peterriv/WaterSupplyController/README.md

# WaterSupplyController
Water pumping and watering management controller for country house
