peterriv/WaterSupplyController/DS/KLS5-CR2032-03.pdf

## ДЕРЖАТЕЛИ БАТАРЕЕК KLS5-CR2032-03

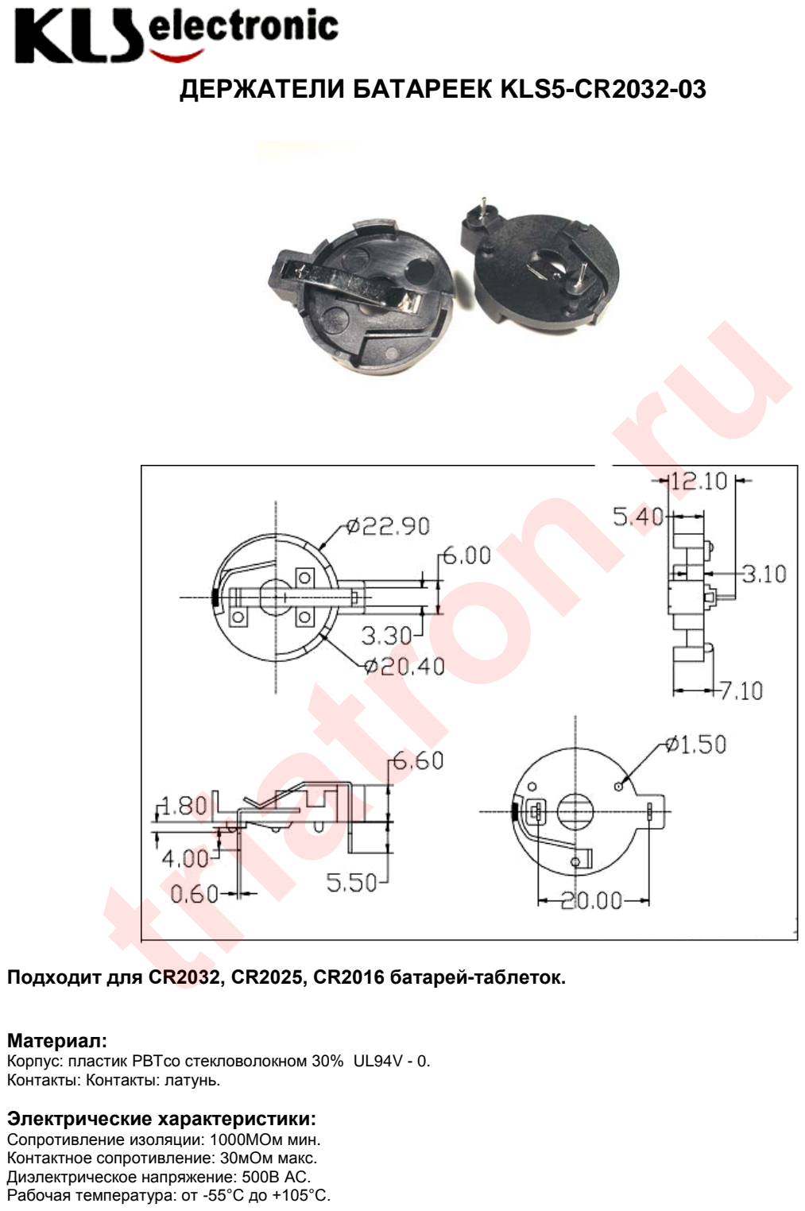
[picture p1: page 1]

Подходит для CR2032, CR2025, CR2016 батарей-таблеток.

### Материал:

Корпус: пластик PBTсо стекловолокном 30% UL94V - 0.
Контакты: Контакты: латунь.

### Электрические характеристики:

Сопротивление изоляции: 1000МОм мин.
Контактное сопротивление: 30мОм макс. Диэлектрическое напряжение: 500В АС. Рабочая температура: от -55°С до +105°С.

# triatron.ru
