peterriv/WaterSupplyController/DS/KLS5-CR2032-03.jpg

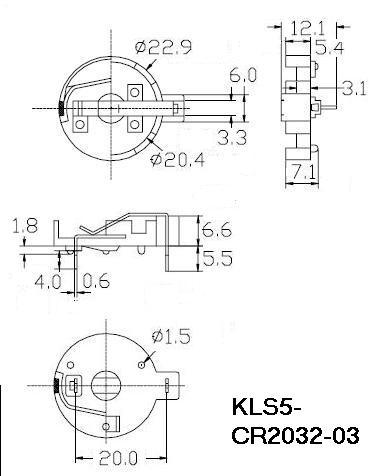
DS/KLS5-CR2032-03.jpg
