peterriv/WaterSupplyController/WaterSupplyController, BOM.xlsx

Line # | Designator | Value | Footprint | Manufacturer 1 | Manufacturer Part Number 1 | Quantity | Price
 | C1 | 22.0x35V | TC7343-D | KEMET | T494X226K035AT | 1 | 0.787
 | C2...C4, C7 | µ10x50V X7R | 0603_CAP | KEMET | C0603C104K5RAC7411 | 4 | 0.06
 | C5, C11, C19...C22 | 10nFx50V X7R | 0603_CAP | Yageo | CC0603KRX7R9BB103 | 6 | 0.042
 | C6 | 1n8x50V X7R | 0603_CAP | TDK | CGA3E2C0G1H182J080AA | 1 | 0.0225
 | C8 | 100.0x16V | TC7343-D | KEMET | T495C107K016ATE200 | 1 | 0.192
 | C9, C14 | 2µ2x10V X7R | 0603_CAP | TDK | C1608X7R1A225K080AC | 2 | 0.102
 | C10, C13, C15...C18, C27, C29_C1, C29_C2, C29_C3 | µ10x10V X7R | 0402_CAP | Yageo | CC0402KRX7R6BB104 | 10 | 0.06
 | C12 | 220.0x6.3V | TC6032-C | Kyocera AVX | TAJC227K006RNJ | 1 | 0.487
 | C23, C24 | 6.8pFx50V NP0 | 0603_CAP | Kyocera AVX | 06035A6R8CAT2A | 2 | 0.02
 | C25, C26 | 22pFx50V NP0 | 0603_CAP | KEMET | C0603C220J1GACTU | 2 | 0.01
 | C28 | 10.0x16V | TC3216-A | Samsung | CL31A106KOHNNNE | 1 | 0.0331
 | DA1 | MP1591DN | HSOP8 | Monolithic Power Systems | MP1591DN-LF-Z | 1
 | DA2 | L78L12ABUTR | SOT-89 | STMicroelectronics | L78L12ABUTR | 1 | 0.4317
 | DA3 | TPS79333DBVR | SOT23-5 | Texas Instruments | TPS79333DBVR | 1 | 5.12
 | DD1 | AT24C32AN-10SU | SO8 | Microchip / Atmel | AT24C32AN-10SU-1.8 | 1
 | DD2 | STM32F103RET6 | LQFP64 | STMicroelectronics | STM32F103RET6 | 1
 | DD3_C1, DD3_C2, DD3_C3 | SN65HVD485EDR | SO8 | Texas Instruments | SN65HVD485EDR | 3 | 23.87
 | GB1 | KLS5-CR2032-03 | CR2032P | KLS | KLS5-CR2032-03 | 1
 | HL1, HL3, HL4, HL6_C1, HL6_C2, HL6_C3 | KP-2012SYC | KP-2012_YEL | Kingbright | KP-2012SYCK | 6 | 0.684
 | HL2, HL5_C1, HL5_C2, HL5_C3 | KP-2012MGC | KP-2012_GRN | Kingbright | KP-2012SGC | 4 | 0.7
 | K1 | TRV-5VDC-SC-CD | TRV-5VDC-SC-CD | Tai-Shing Electronic Components | TRV-5VDC-SC-CD | 1
 | L1 | 22µH CDRH124NP-220MC | CDRH124 | Sumida | CDRH124NP-220MC | 1 | 1.53
 | L2, L3 | 470R BLM18PG471SN1D | 0603_BLM18 | Murata | BLM18PG600SN1D | 2 | 0.2
 | L4 | 100µH LQH43CN101K | LQH43 | Murata | LQH43CN101K03L | 1 | 0.49
 | R1, R27...R31, R37...R40 | 15k00 | 0603_RES | Yageo | RC0603FR-0715KL | 10 | 0.04
 | R2 | 100k00 | 0603_RES | Yageo | AC0603FR-07100KL | 1 | 0.069
 | R3 | 30k10 | 0603_RES | Panasonic | ERJ-3EKF3012V | 1 | 0.00313
 | R4 | 10k00 | 0603_RES | Panasonic | ERJ-3EKF1002V | 1 | 0.008
 | R5 | 8k20 | 0603_RES | Panasonic | ERJ-3EKF8201V | 1 | 0.006
 | R6 | 1k50 | 0603_RES | Panasonic | ERJ-3EKF1501V | 1 | 0.006
 | R7, R8, R25, R26 | 4k7 CAT16-472J4 | CAT16 | Bourns | CAT16-472J4LF | 4 | 0.192
 | R9, R13...R16, R24, R32...R36, R41...R45 | 5k11 | 0603_RES | Vishay | CRCW06035K11FKEA | 16 | 0.096
 | R10, R19 | k10 | 0603_RES | Yageo | RC0603FR-07100RL | 2 | 0.008
 | R11, R12 | 3k3 | 0603_RES | Yageo | RC0603FR-073K3L | 2 | 0.008
 | R17, R18, R46_C1, R46_C2, R46_C3, R47_C1, R47_C2, R47_C3 | 1k | 0603_RES | Yageo | RC0603FR-071KL | 8 | 0.064
 | R20...R23 | 6k19 | 0603_RES | Panasonic | ERJ-3EKF6191V | 4 | 0.064
 | R48_C1, R48_C2, R48_C3, R49_C1, R49_C2, R49_C3 | 240R00 | 0805_RES |  |  | 6
 | R50_C1, R50_C2, R50_C3, R51_C1, R51_C2, R51_C3 | 0R | 0402_RES | Yageo | RC0402JR-070RL | 6 | 0.006
 | VD1 | P1.5KE24A | DO-201AD | Littelfuse | TP1.5KE24A | 1 | 0.1319
 | VD2 | STPS3L60U | SMB-STPS3L60U | STMicroelectronics | STPS3L60U | 1 | 0.4583
 | VD12_C1, VD12_C2, VD12_C3, VD13_C1, VD13_C2, VD13_C3 | GSOT12C | SOT-23-(2) | Vishay Semiconductors | GSOT12-E3-08 | 6 | 0.99
 | VD3...VD11 | ES1D | SMA | ON Semiconductor / Fairchild | ES1B | 9 | 3.39
 | VT1...VT6, VT12...VT15 | MMBF170 | SOT-23 MOSFET | Diodes | MMBF170Q-7-F | 10 | 2.87
 | VT7...VT11, VT16...VT19 | IRLML0060TRPBF | SOT-23 MOSFET | Alpha & Omega Semiconductor | AO3400A | 9 | 3.62
 | X1_C1, X1_C2, X1_C3 | DS1025-01-1*3 P8BV1 | PLS2-3 | Connfly | DS1025-01-1*3 P8BV1 | 3
 | XP1 | DS1022-1*4RDF11-B | PLS-4RR | Connfly | DS1022-1*4RDF11-B | 1
 | XP2 | DS1025-05-2*3P8BV1-B | PLD2-6 | Connfly | DS1025-05-2*3P8BV1-B | 1
 | XP3 | B5B-PH-K-S(LF)(SN) | PH-5 | KLS | L-KLS1-XL1-2.00-05-S | 1
 | XP4 | B3B-PH-K-S(LF)(SN) | PH-3 | Connfly | DS1066-3MVW6X | 1
 | XP5_C1, XP5_C2, XP5_C3 | B4B-PH-K-S(LF)(SN) | PH-4 | JST | B4BPHKSLFSN | 3 | 3.02
 | XT1, XT4...XT8 | XY301VA-5.0-2P-12 | 301-021-12 | Ningbo Xinya M&E | XY301VA-5.0-2P-12 | 6
 | XT2, XT3 | XY301VA-5.0-3P-12 | 301-031-12 | Ningbo Xinya M&E | XY301VA-5.0-3P-12 | 2
 | ZQ1 | NX3215SA-32.768K-STD-MUA-8 | 1206_NX3215SA | NDK | NX3215SA-32.768K-STD-MUA-8 | 1
 | ZQ2 | 12MHz HC49SM | HC49SM | Abracon | ABLS-12.000MHZ-B4-T | 1 | 0.196
