peterriv/WaterSupplyController/Project Outputs for WaterSupplyController/Schematic Print/Schematic Prints.PDF

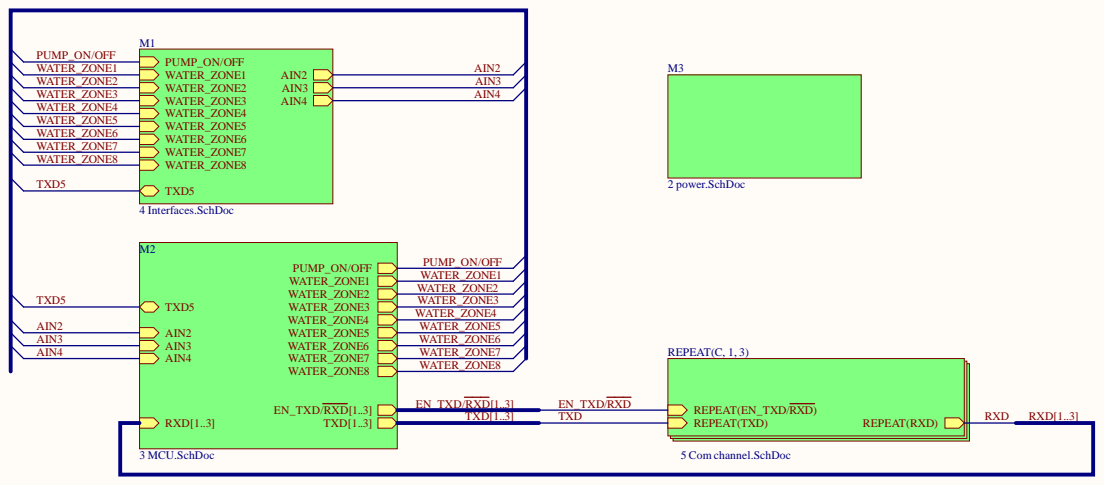
[picture p3: page 1]

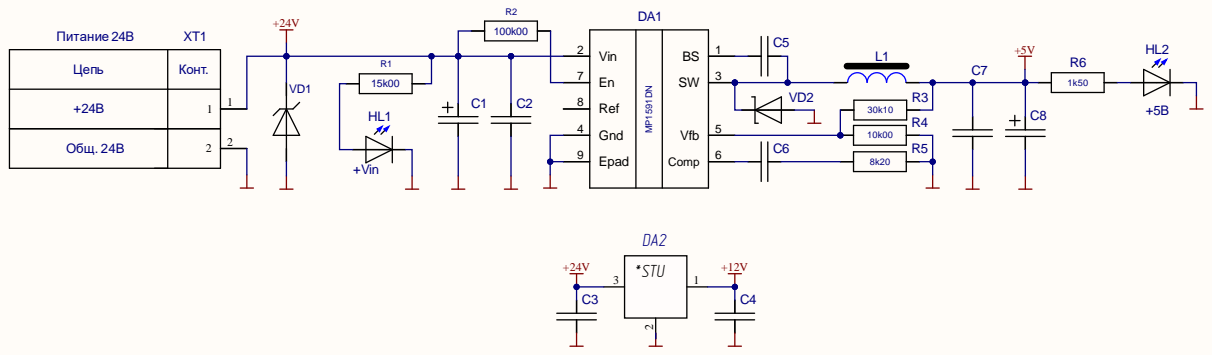
[picture p4: page 2]

Vin 2 | Comp | 6 Epad 9

Цепь | Конт.

C:\Work\WaterSupplyController\SchDocs\2 power.SchDoc

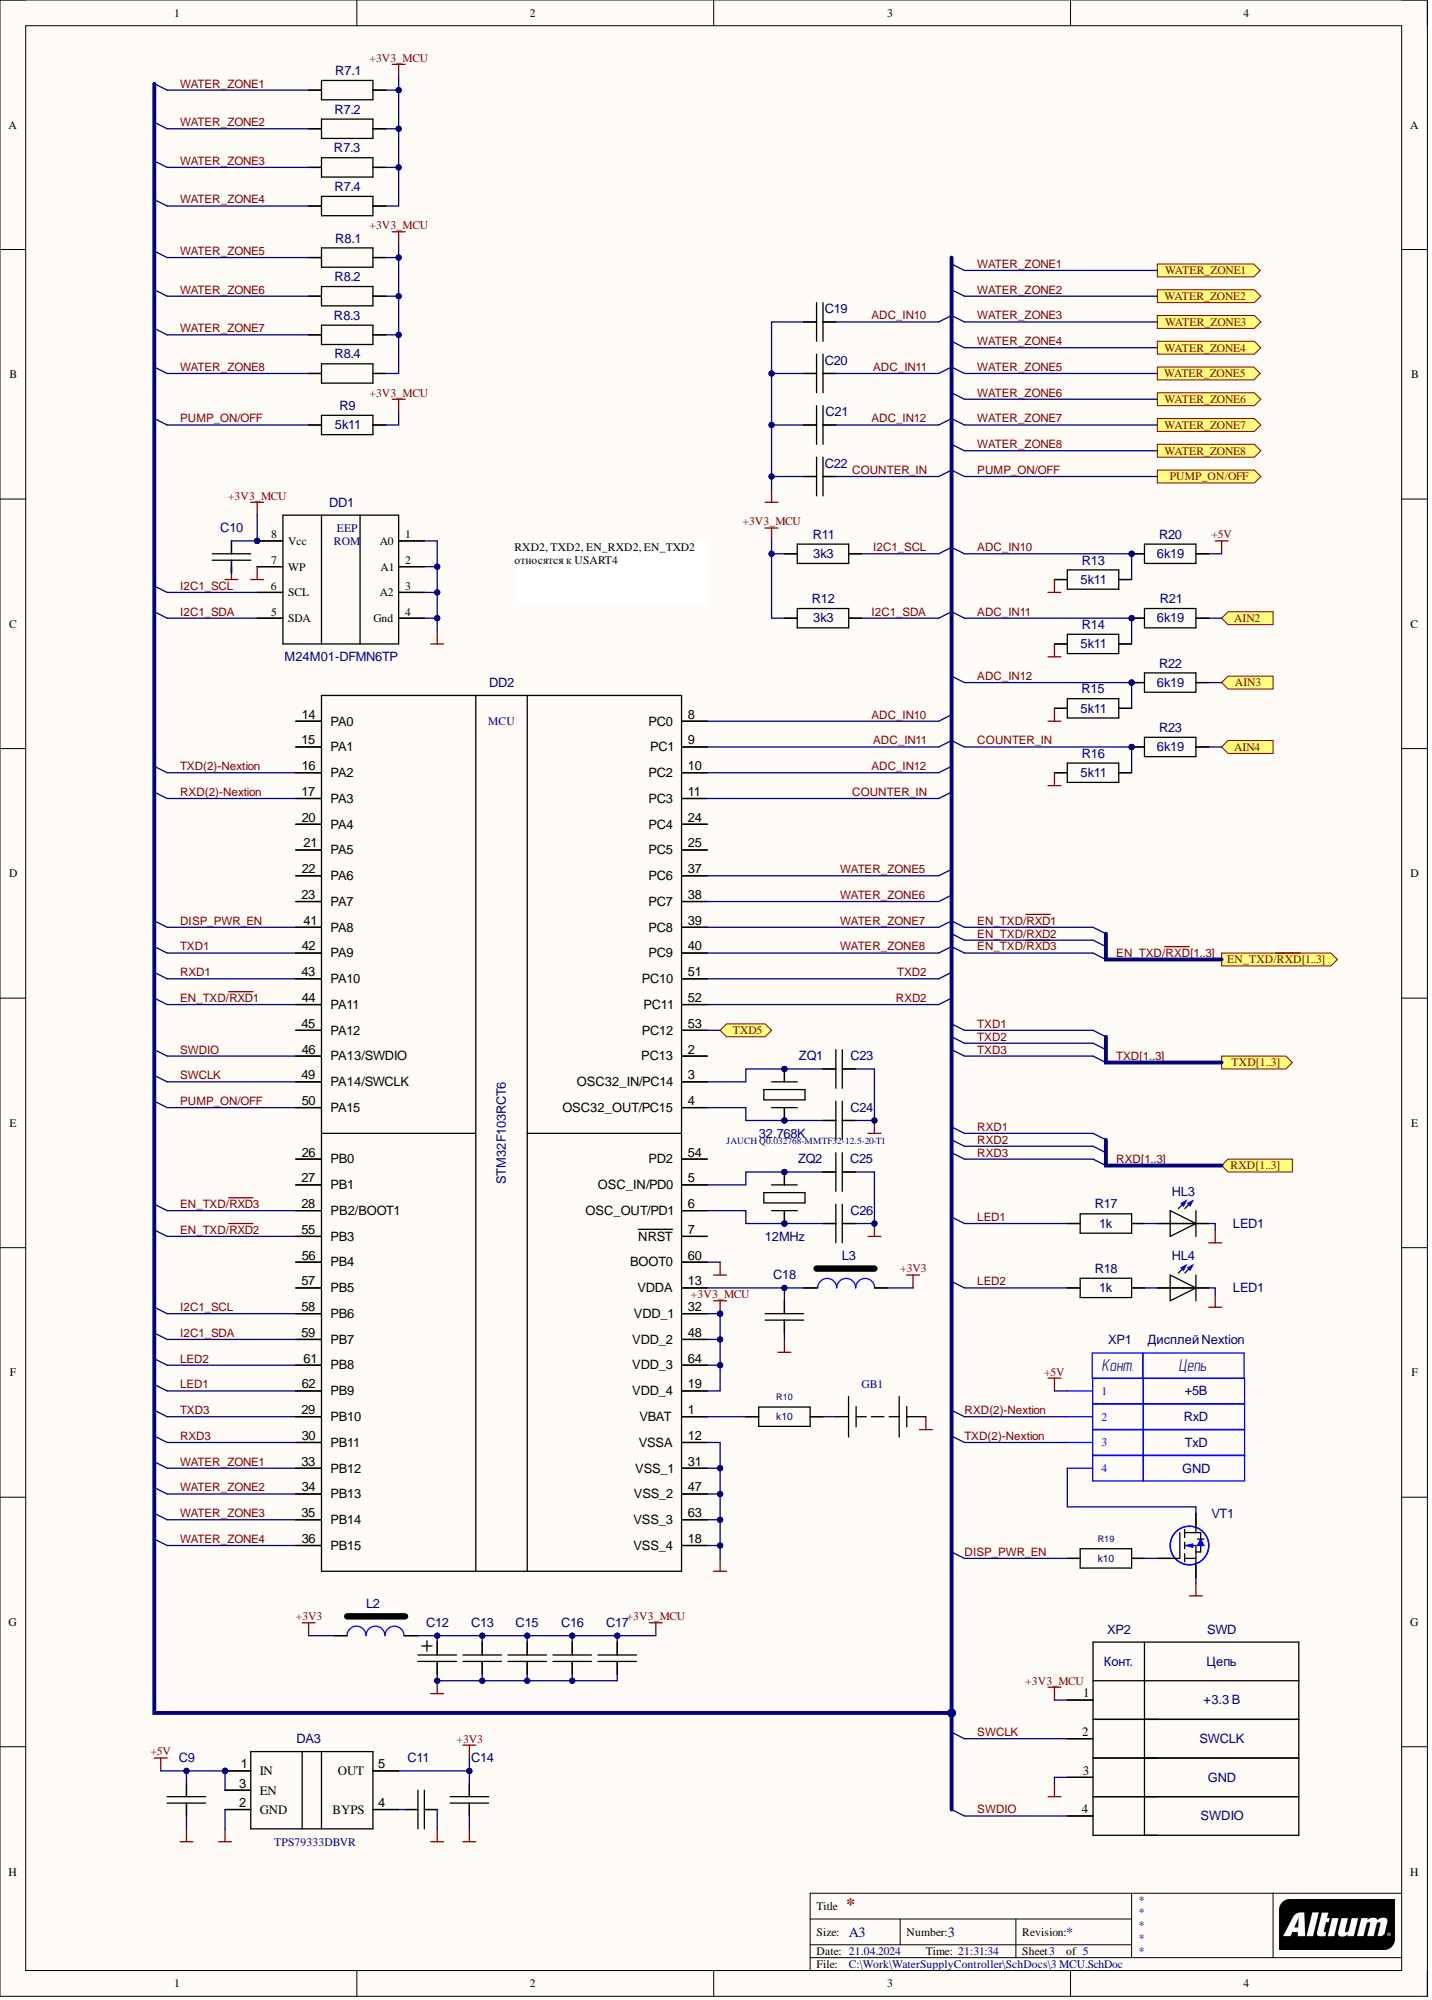
[picture p5: page 3]

Конт. | Цепь

3 | TxD

4 | GND

SWCLK

IN 1 EN 3 GND 2

GND

SWDIO

C:\Work\WaterSupplyController\SchDocs\3 MCU.SchDoc

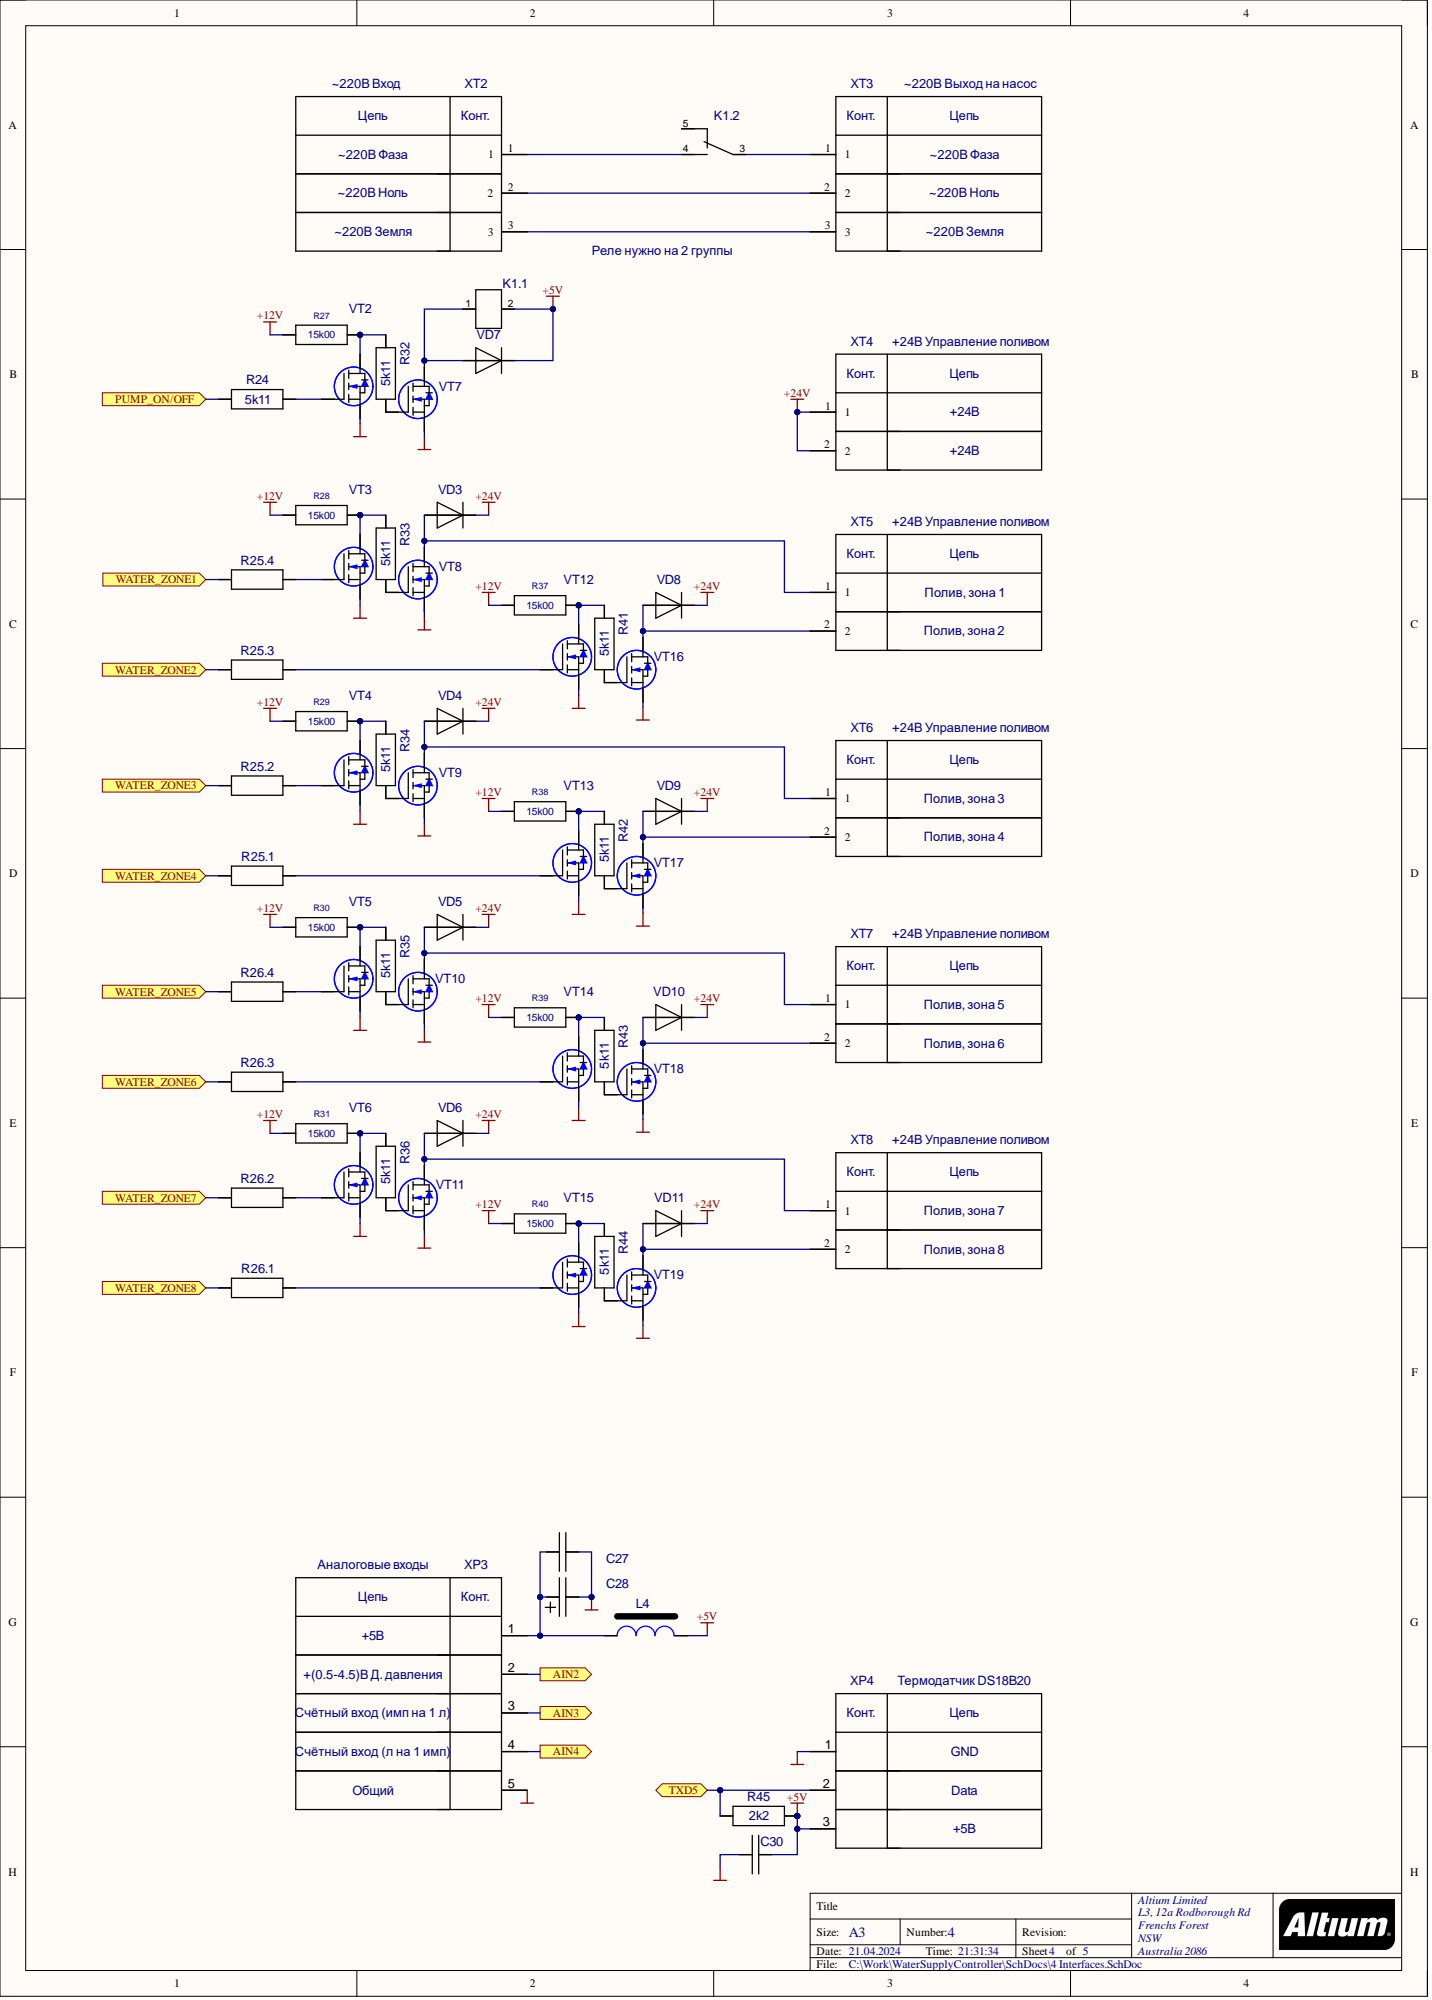
[picture p6: page 4]

Реле нужно на 2 группы

Конт. | Цепь

1 1 | Полив, зона 1

2 2 | Полив, зона 2

1 1 | Полив, зона 3

2 2 | Полив, зона 4

1 1 | Полив, зона 5

2 2 | Полив, зона 6

1 1 | Полив, зона 7

2 2 | Полив, зона 8

Цепь | Конт.

+(0.5-4.5)ВД. давления

Счётный вход (имп на 1 л)

Счётный вход (л на 1 имп)

C:\Work\WaterSupplyController\SchDocs\4 Interfaces.SchDoc

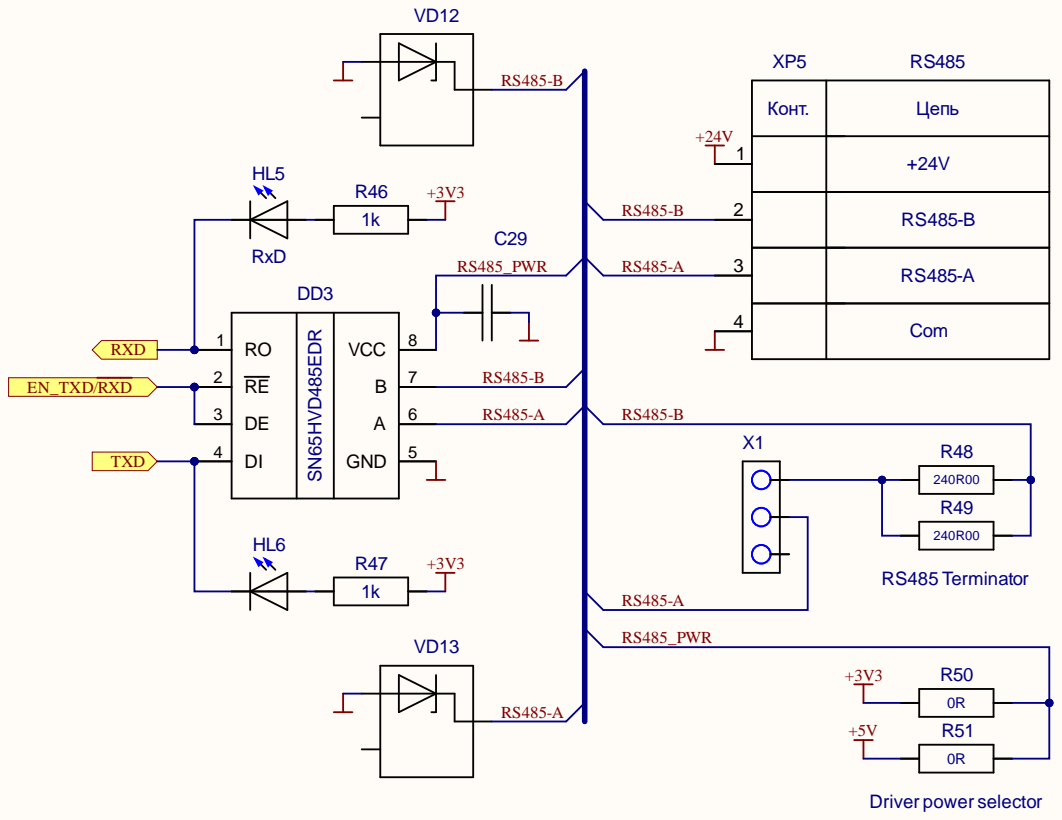
[picture p7: page 5]

Конт. | Цепь

Com

C:\Work\WaterSupplyController\SchDocs\5 Com channel.SchDoc
