peterriv/WaterSupplyController/DS/3.2_Nextion_Dimension.pdf

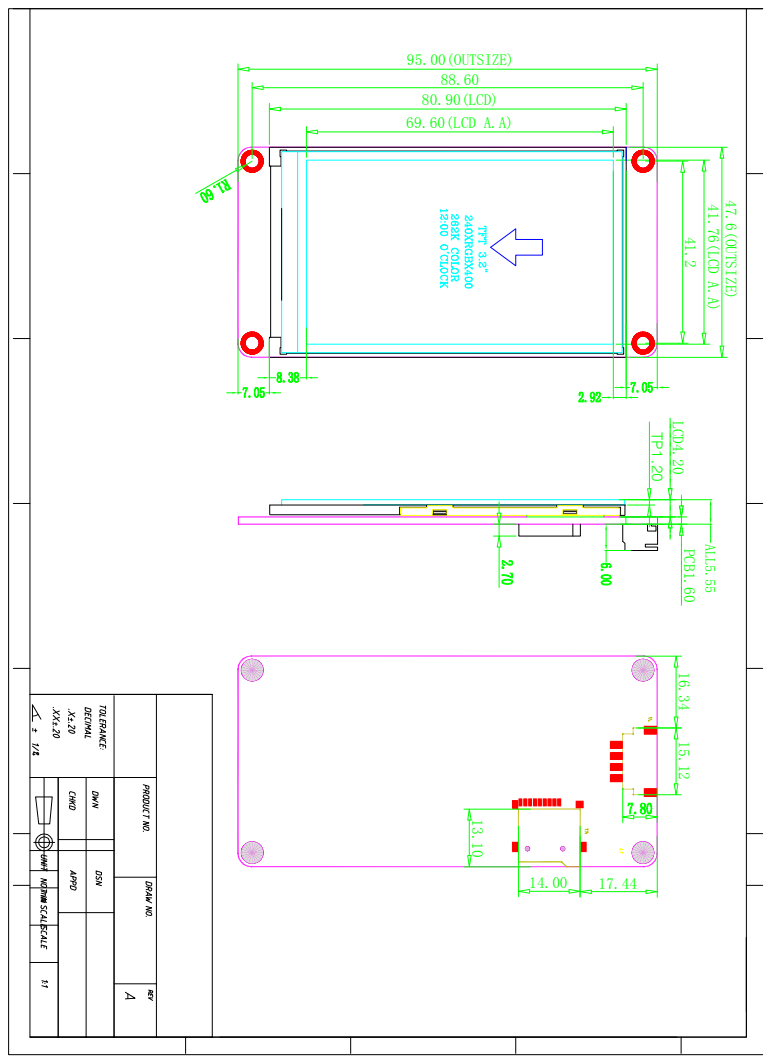
[picture p8: page 1]
41.76(LCD A.A); 47.6(OUTSIZE); 69.60(LCD A.A); 80.90(LCD); 95.00(OUTSIZE); LCD4.20; PCB1.60 16.34 15.12; ALL5.55
