peterriv/WaterSupplyController/DS/NX4832F035_dimension.pdf

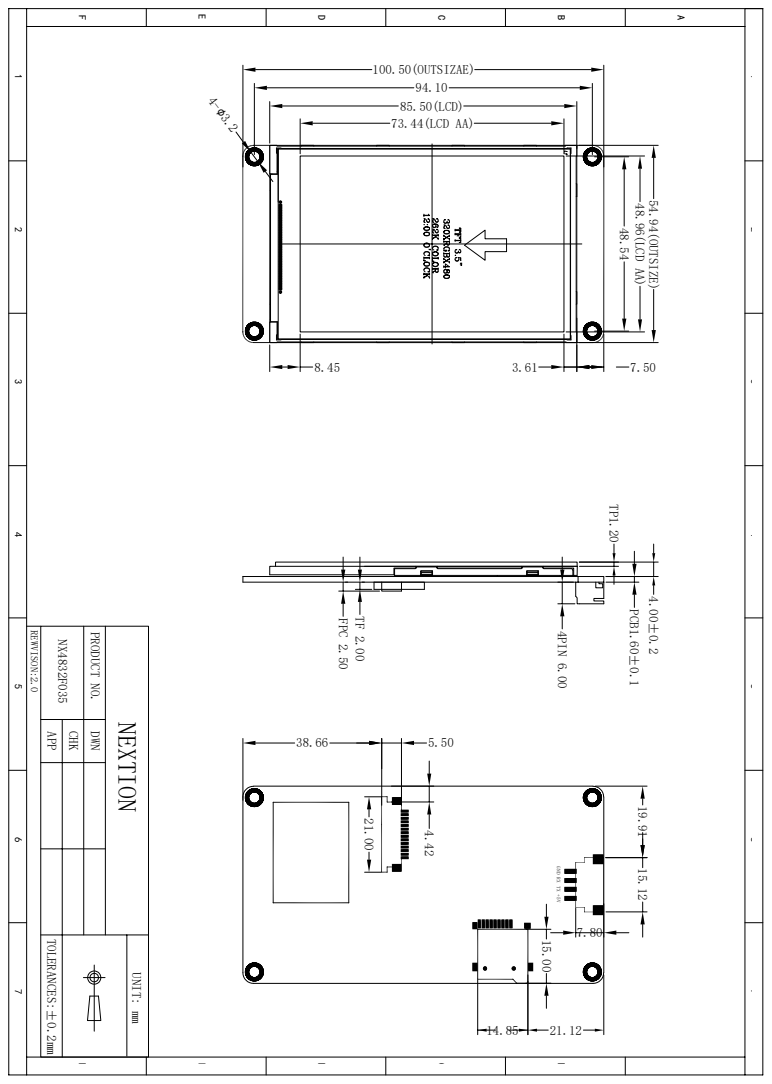
[picture p9: page 1]
PCB1.60±0.1; 4PIN 6.00; 48.96(LCD A; 54.94(OUTSIZE); 73.44(LCD AA); 94.10 85.50(LCD); 100.50(OUTSIZAE); FPC 2.50; PRODUCT NO.; U NIT: m; TOLERA; NCES:±0.2m; CHK; APP; REWVISON:2.0

+5V TX RX GND
