peterriv/WaterSupplyController/Project Outputs for WaterSupplyController/PCBDrawing/Draftsman.PDF

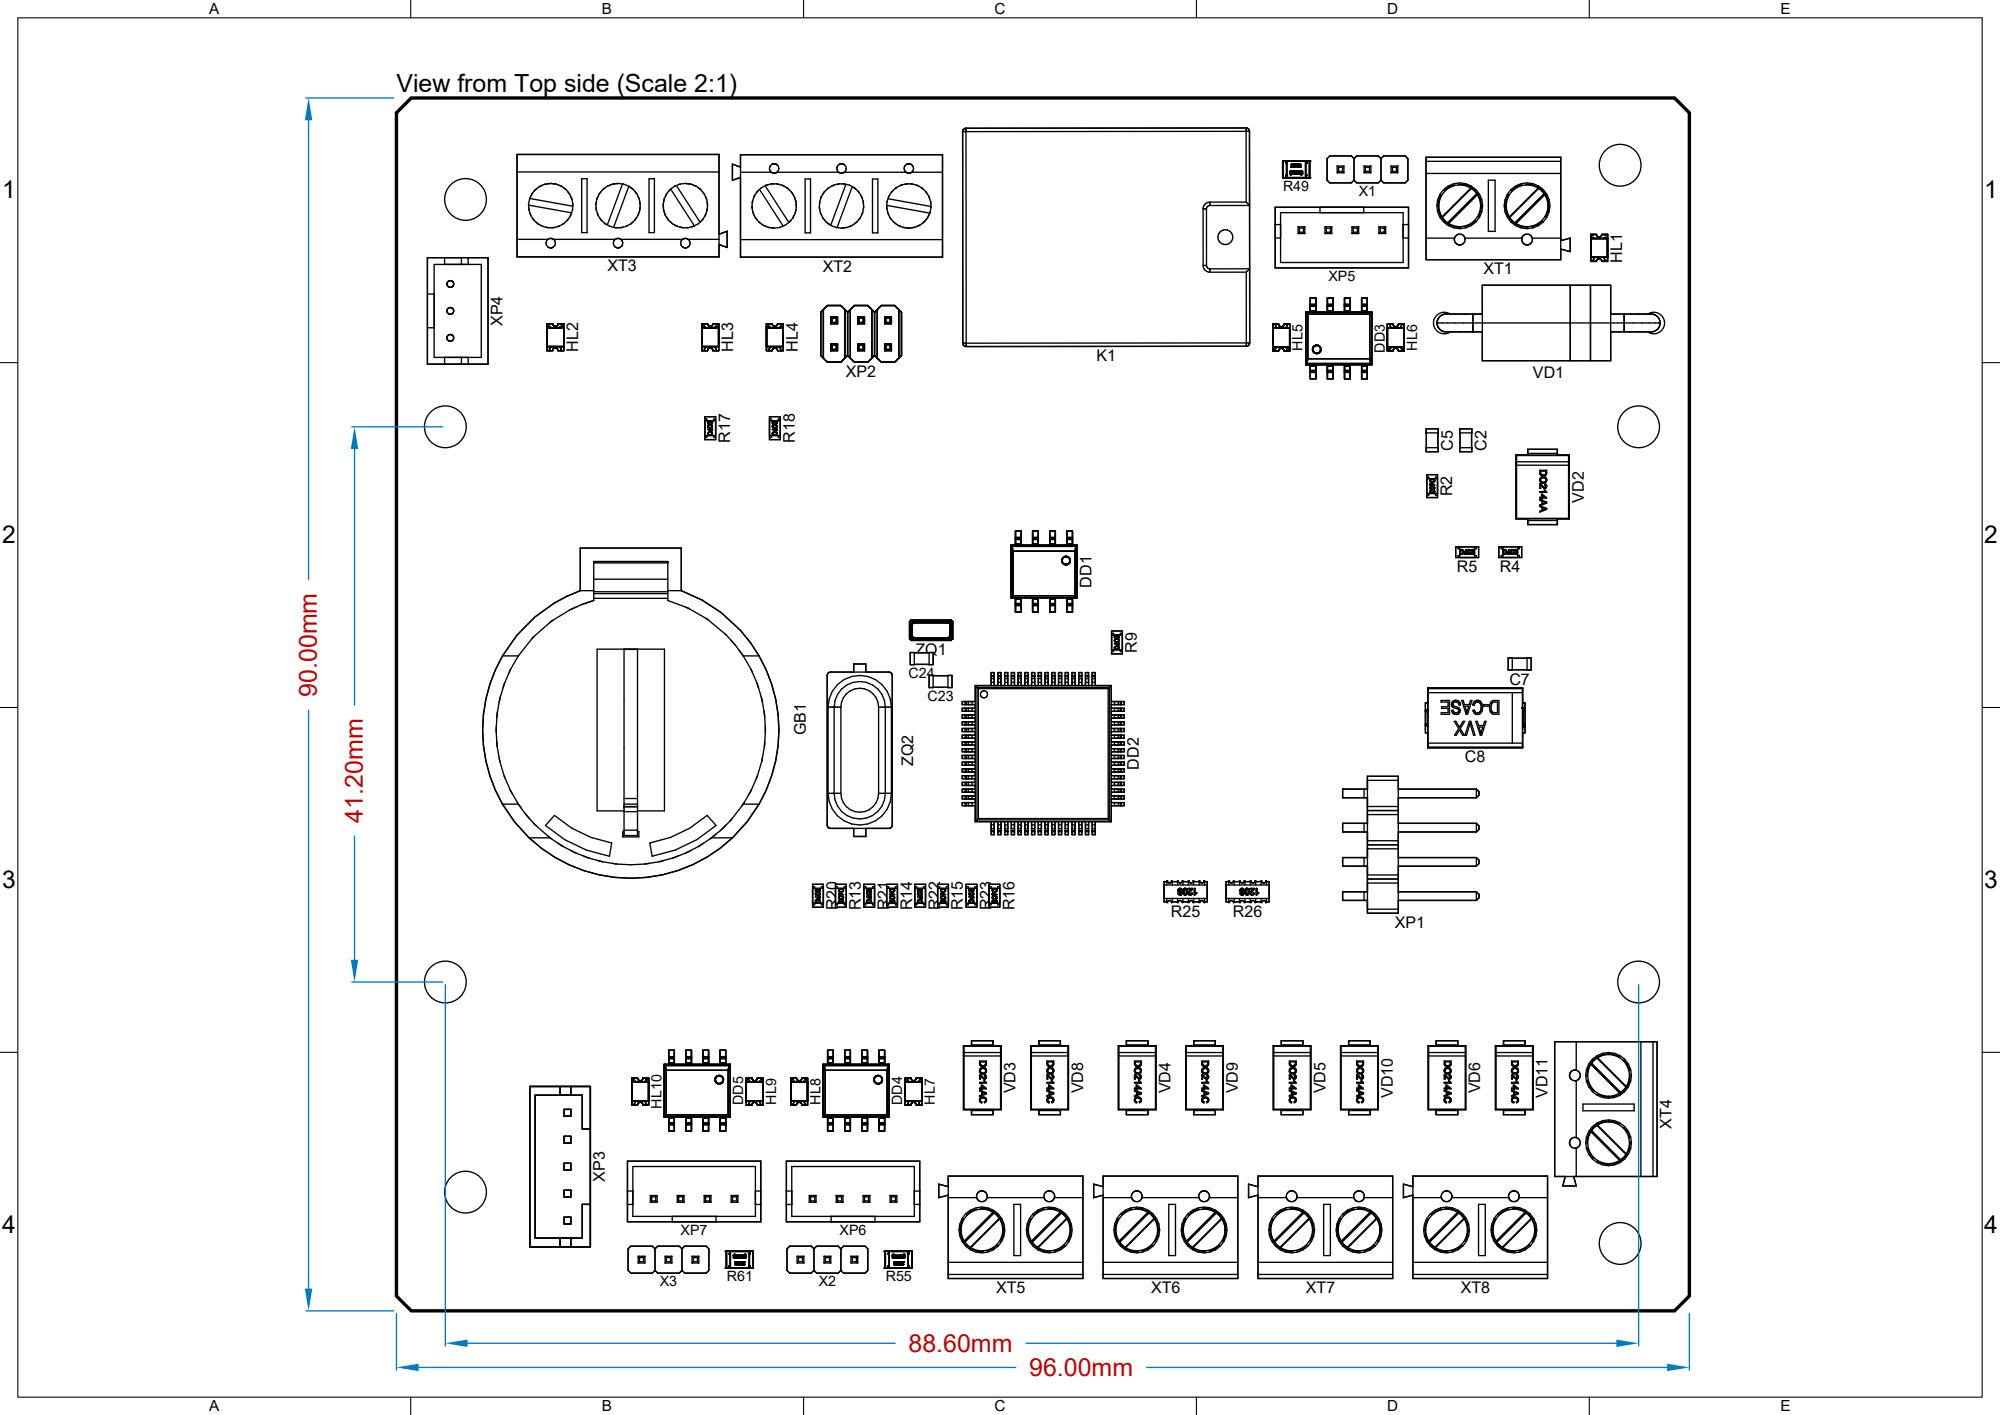
[picture p10: page 1]

View from Top side (Scale 2:1)

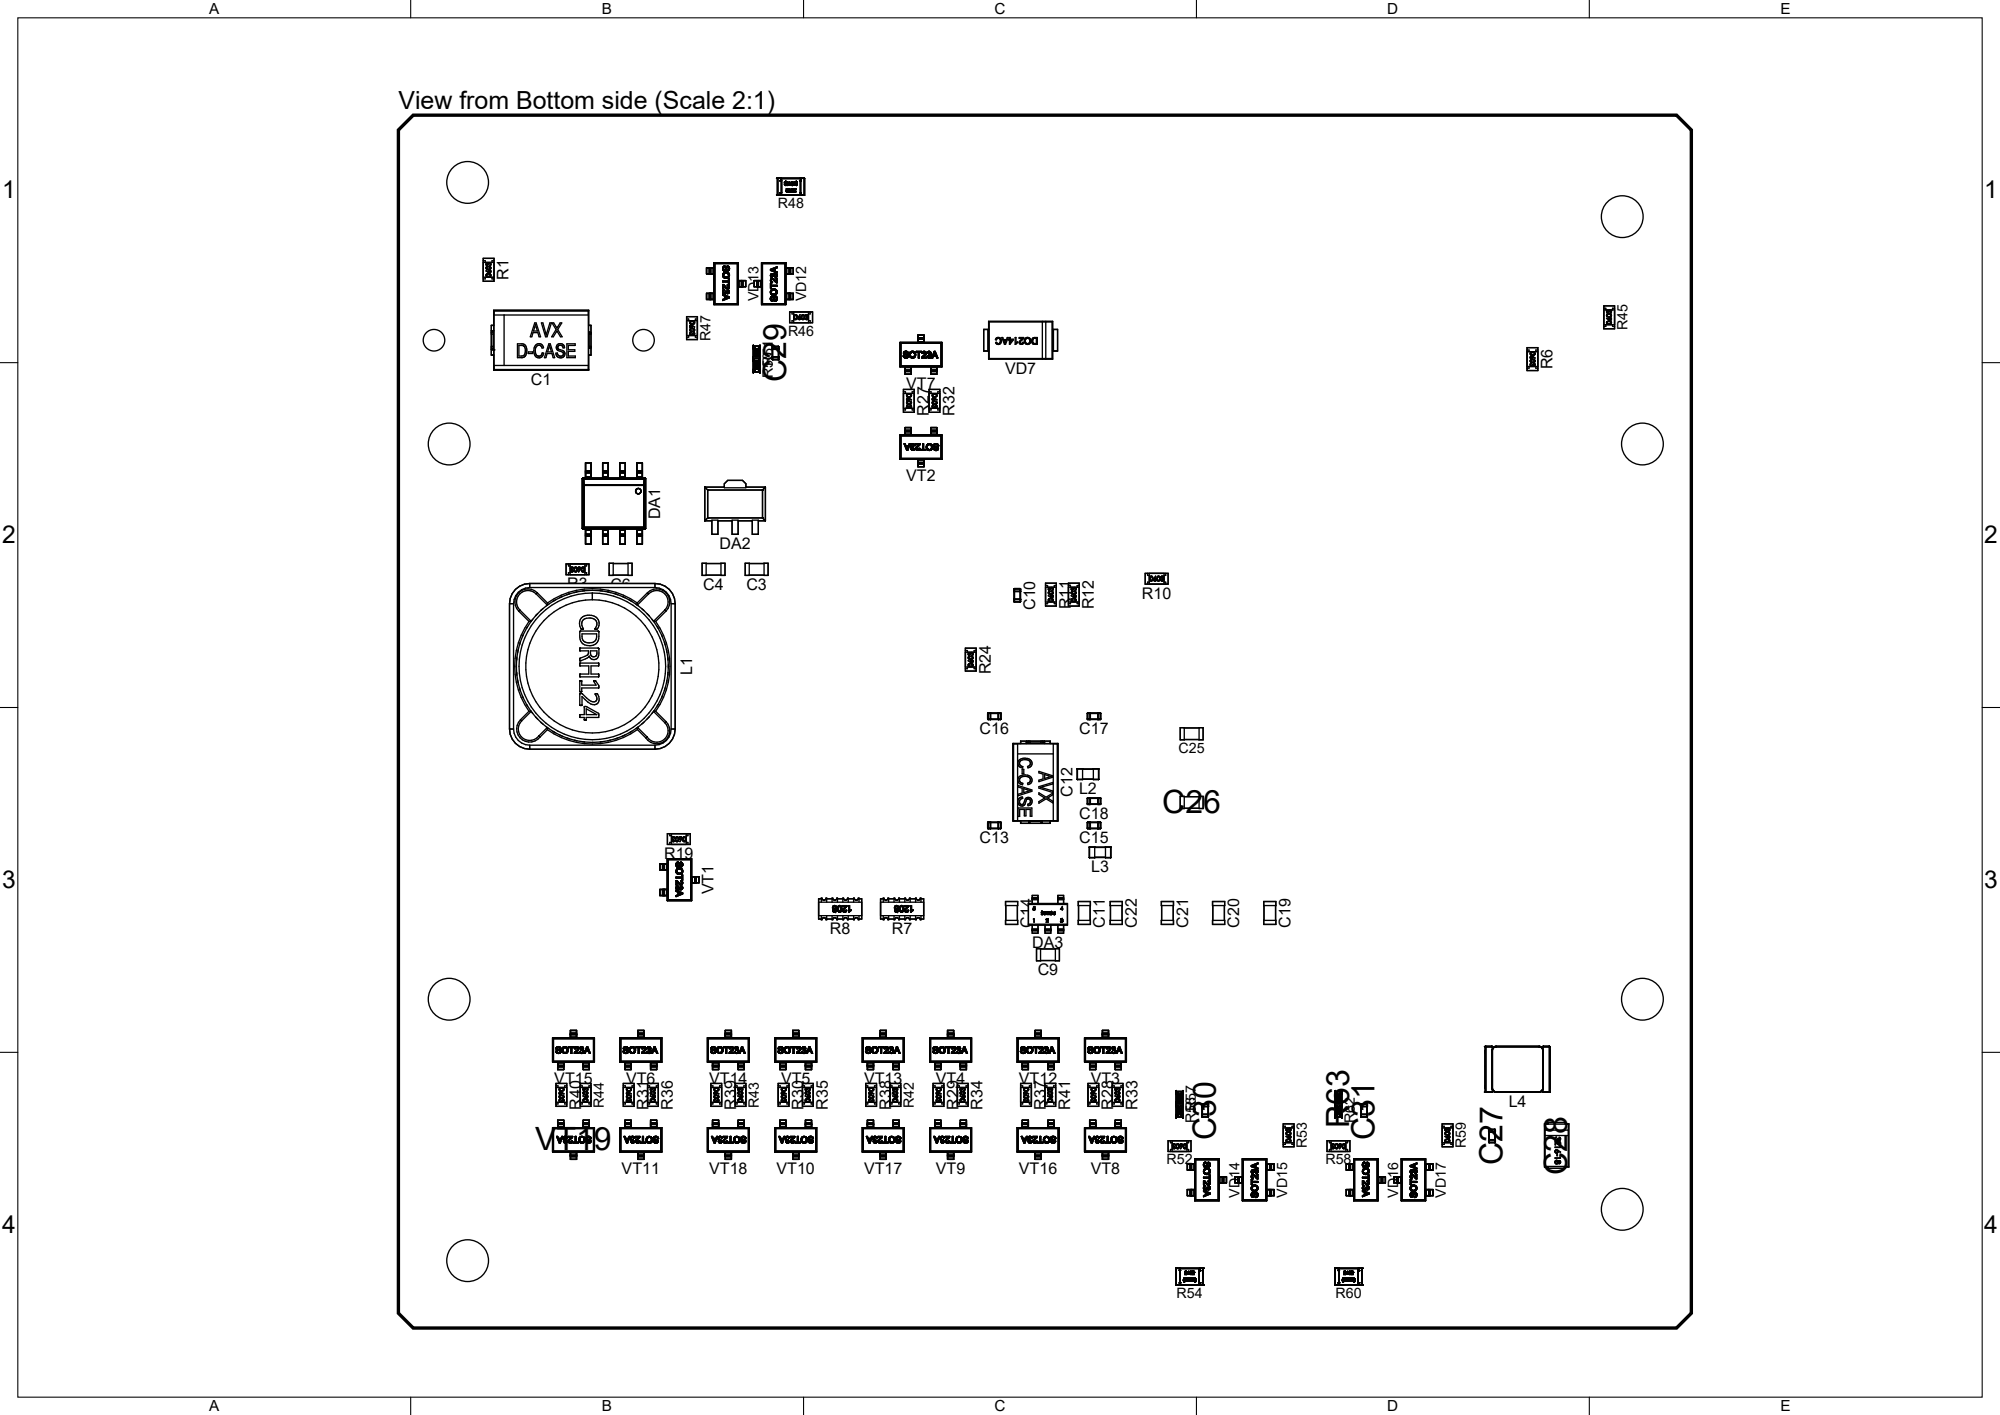
[picture p11: page 2]

View from Bottom side (Scale 2:1)
