peterriv/WaterSupplyController/(list of files, drawings)

Other design files:
SchDocs/1 top level sheet.SchDoc
SchDocs/2 power.SchDoc
SchDocs/3 MCU.SchDoc
SchDocs/4 Interfaces.SchDoc
SchDocs/5 Com channel.SchDoc
WaterSupplyController.PrjPcb
