peterriv/WaterSupplyController/FW/Core/Src/main.c

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
/* Includes ------------------------------------------------------------------*/
#include "main.h"

ADC_HandleTypeDef hadc1;
ADC_HandleTypeDef hadc2;
DMA_HandleTypeDef hdma_adc1;

CRC_HandleTypeDef hcrc;

I2C_HandleTypeDef hi2c1;

IWDG_HandleTypeDef hiwdg;

RTC_HandleTypeDef hrtc;

TIM_HandleTypeDef htim4;

UART_HandleTypeDef huart4;
UART_HandleTypeDef huart5;
UART_HandleTypeDef huart1;
UART_HandleTypeDef huart2;
UART_HandleTypeDef huart3;
DMA_HandleTypeDef hdma_uart4_rx;
DMA_HandleTypeDef hdma_uart4_tx;
DMA_HandleTypeDef hdma_usart1_rx;
DMA_HandleTypeDef hdma_usart1_tx;
DMA_HandleTypeDef hdma_usart2_rx;
DMA_HandleTypeDef hdma_usart2_tx;
DMA_HandleTypeDef hdma_usart3_rx;
DMA_HandleTypeDef hdma_usart3_tx;

/* USER CODE BEGIN PV */

JetsonComPort_t		jetson;
ExtComPort_t			external;
NextionComPort_t	nextion;
ComPortData_t			com1, com2, com3, com4, com5;

E2p_t									e2p;
Adc_t									adc1;
Statistics_t					stats;
Calibrations_t				calib;
Temperature_t					ds18b20;
WateringControl_t			water_ctrl;
LastPumpCycle_t				last_pump_cycle;
RingBuffer_t					com1_ring_buf, com2_ring_buf;

PumpCurrentState_t		pumpState;
PumpControlCommands_t pumpComms;
UvLampState_t 				uvLampState;
CurrentSystemState_t 	sysState;

// Флаг включения св-диода индикации секундной метки
volatile uint8_t	time_led_is_on;

//volatile uint8_t	uv_lamp_is_on;

// Флаг обнаружения восстановления напряжения питания (>4.8В), adc watchdog
volatile uint8_t	power_up_detected;
// Флаг обнаружения падения напряжения питания (<4.6В), adc watchdog
volatile uint8_t	power_down_detected;

// Переменные слежения за целостностью связи по RS485
volatile uint8_t 	control_link_is_lost;

// Переменная яркости дисплея в привязке к systick в мсек (2000/20=100%), (100/20=5%)
volatile int16_t	display_brightness;
// Таймер задержки перед уменьшением яркости дисплея, сек
volatile int16_t	display_brightness_timer;

// Флаг разрешения выполнения основного потока обслуживания периф. устройств 
volatile uint8_t 	periph_scan_enabled;

// Счётчик ошибок
volatile uint32_t func_err_counter;

// Счётчик ошибок датчика температуры
volatile uint32_t temp_sensors_err_counter;

volatile uint32_t	uv_lamp_preheating_on_time;


/* USER CODE END PV */

void SystemClock_Config(void);
static void MX_GPIO_Init(void);
static void MX_DMA_Init(void);
static void MX_ADC1_Init(void);
static void MX_I2C1_Init(void);
static void MX_UART4_Init(void);
static void MX_USART1_UART_Init(void);
static void MX_USART2_UART_Init(void);
static void MX_USART3_UART_Init(void);
static void MX_RTC_Init(void);
static void MX_TIM4_Init(void);
static void MX_UART5_Init(void);
static void MX_IWDG_Init(void);
static void MX_CRC_Init(void);
static void MX_ADC2_Init(void);
/**
  * @brief  The application entry point.
  * @retval int
  */
int main(void)
{

  /* USER CODE BEGIN 1 */
	
	ReturnCode_t 			func_res;
	HAL_StatusTypeDef	hal_func_res;
	
	int32_t time_temp, time_prev = 0;
	
  /* USER CODE END 1 */

  /* MCU Configuration--------------------------------------------------------*/

  /* Reset of all peripherals, Initializes the Flash interface and the Systick. */
  HAL_Init();

  /* Configure the system clock */
  SystemClock_Config();

  /* Initialize all configured peripherals */
  MX_GPIO_Init();
  MX_DMA_Init();
  MX_ADC1_Init();
  MX_I2C1_Init();
  MX_UART4_Init();
  MX_USART1_UART_Init();
  MX_USART2_UART_Init();
  MX_USART3_UART_Init();
  MX_RTC_Init();
  MX_TIM4_Init();
  MX_UART5_Init();
  MX_IWDG_Init();
  MX_CRC_Init();
  MX_ADC2_Init();
  /* USER CODE BEGIN 2 */

	// Initial hardware settings
	Init_sequence();
			
  /* USER CODE END 2 */

  /* Infinite loop */
  /* USER CODE BEGIN WHILE */
  while (1)
  {
		// Сброс watchdog******************************************************************************
		IWDG->KR = IWDG_KEY_RELOAD;

		// Если обнаружено падение напряжения питания +5В ниже +4.6В***********************************
		if (power_down_detected)
		{
			// Обработчик состояния падения напряжения питания ниже 4.6В
			Power_down_handler(&hcrc, &hi2c1, &hrtc, &e2p);			
			power_down_detected = 0;    
		
			Error_Handler();			
		}
		
		// Если принят блок данных с АЦП***************************************************************
		if (adc1.DataReady)
		{
			adc1.DataReady = 0;
			
			// Пересчёт значений АЦП в вольты
			Voltage_calc_from_adc_value(&e2p, &sysState);
			
			// Усреднение значения давления
			Get_average_pressure_value(&e2p, &sysState);
		}
		
		// Checking whether data is received via COM1**************************************************
		if (com1.RxdPacketIsReceived)
		{
			// Handles data from Com port
			func_res = Com_rxd_handler(&hcrc, com1.ComNum, &jetson, &nextion);			
			if(func_res != OK) func_err_counter++;

			com1.RxdPacketIsReceived = 0;			
		}
		
		// Checking whether data is received via COM3**************************************************
		if (com3.RxdPacketIsReceived)
		{
			// Handles data from Com port
			func_res = Com_rxd_handler(&hcrc, com3.ComNum, &jetson, &nextion);		
			if(func_res != OK) func_err_counter++;

			com3.RxdPacketIsReceived = 0;
		}
		
		// Проверка наличия принятой по COM2 строки данных из дисплея Nextion**************************
		if (com2.RxdPacketIsReceived)
		{
			// Обработчик принятого пакета по USART
			func_res = Nextion_received_data_handler(&hrtc, &e2p);	
			if(func_res != OK)
			{
				func_err_counter++;
			}

			com2.RxdPacketIsReceived = 0;
		}		

		// Проверка готовности обновления дисплея Nextion**********************************************
		if (nextion.RefreshReady)
		{		
			nextion.RefreshReady = 0;
			
			// Отрисовка на Nextion текущих значений
			func_res = Prepare_params_and_send_to_nextion(&hrtc, &e2p, &nextion, &sysState);			
			if(func_res != OK)
			{
				func_err_counter++;
			}
		}
		
		// Checking presence of unsent data in COM1 ring buffer****************************************
		if (Is_all_data_popped_from_ring_buffer(&com1_ring_buf))
		{
			// Checking whether data is ready to send via COM1
			if (com1.TxdPacketIsReadyToSend)
			{
				if (jetson.ComLink == COM1)
				{
					// Popping data from ring data buffer for sending 
					func_res = Pop_string_from_ring_buffer(jetson.ComRingBuf, jetson.PhTxdBuffer, &jetson.StringSize);
					if(func_res == OK)
					{
						com1.TxdPacketIsReadyToSend = 0;
						hal_func_res = HAL_UART_Transmit_DMA(&huart1, jetson.PhTxdBuffer, jetson.StringSize);
					}
					else func_err_counter++;
				}
				else if (external.ComLink == COM1)
				{
					// Popping data from ring data buffer for sending 
					func_res = Pop_string_from_ring_buffer(external.ComRingBuf, external.PhTxdBuffer, &external.StringSize);
					if(func_res == OK)
					{
						com1.TxdPacketIsReadyToSend = 0;
						hal_func_res = HAL_UART_Transmit_DMA(&huart1, external.PhTxdBuffer, external.StringSize);
					}
					else func_err_counter++;
				}
			}
		}
				
		// Checking presence of unsent data in COM2 ring buffer****************************************
		if (Is_all_data_popped_from_ring_buffer(&com2_ring_buf))
		{
			// Checking whether data is ready to send via COM2
			if (com2.TxdPacketIsReadyToSend)
			{
				if (nextion.ComLink == COM2)
				{
					// Popping data from ring data buffer for sending 
					func_res = Pop_string_from_ring_buffer(nextion.ComRingBuf, nextion.PhTxdBuffer, &nextion.StringSize);
					if(func_res == OK)
					{
						com2.TxdPacketIsReadyToSend = 0;
						hal_func_res = HAL_UART_Transmit_DMA(&huart2, nextion.PhTxdBuffer, nextion.StringSize);
					}
					else
					{
						func_err_counter++;
					}
				}
				else if (jetson.ComLink == COM2)
				{
					// Popping data from ring data buffer for sending 
					func_res = Pop_string_from_ring_buffer(jetson.ComRingBuf, jetson.PhTxdBuffer, &jetson.StringSize);
					if(func_res == OK)
					{
						com2.TxdPacketIsReadyToSend = 0;
						hal_func_res = HAL_UART_Transmit_DMA(&huart2, jetson.PhTxdBuffer, jetson.StringSize);
					}
					else func_err_counter++;
				}
				else if (external.ComLink == COM2)
				{
					// Popping data from ring data buffer for sending 
					func_res = Pop_string_from_ring_buffer(external.ComRingBuf, external.PhTxdBuffer, &external.StringSize);
					if(func_res == OK)
					{
						com2.TxdPacketIsReadyToSend = 0;
						hal_func_res = HAL_UART_Transmit_DMA(&huart2, external.PhTxdBuffer, external.StringSize);
					}
					else func_err_counter++;
				}
			}
		}
		
		// Проверка готовности выполнения ветки работы с периферией************************************
		if (periph_scan_enabled)
		{
			time_temp = Get_time_in_sec(&hrtc);
			
			if (time_temp != time_prev)
			{
				// Обновление секундного счётчика времени суток
				sysState.TimeInSeconds = time_temp;

				// Включение св-диода индикации секундной метки
				LED2_ON;
				time_led_is_on = 1;
				time_prev = time_temp;
			}
			
			// Коррекция времени и инкремент суток
			Make_time_correction_and_day_inc(&hrtc, &e2p, &sysState);
						
			// Выполнение автоинкремента/автодекремента каждые 150 мсек, если кнопка на дисплее удерживается
			Parsing_nextion_display_string(&hrtc, &e2p, nextion.RxdBuffer, com2.RxdPacketLenght8, com2.RxdPacketIsReceived, &sysState);
			
			// Управление системой
			SysControlLogic(&e2p, &sysState);

			// Сформировать статистику расхода воды
			Make_water_using_statistics(&e2p, &sysState);
			
			periph_scan_enabled = 0;
		}
		
		// Опрос термодатчиков только при наступлении очередного момента времени***********************
		if (ds18b20.GetSensorsData)
		{
			uint8_t err = OW_OK;
			
			// Опрос термодатчиков только при их наличии
			if (ds18b20.DiscoveredQuantity)
			{
				err = Polling_termosensors(&ds18b20);
				sysState.CurrentWaterTemp = (int16_t) (ds18b20.TempSensorsValues[0] * 10);
			}
			// При отсутствии д.темп. или ошибке связи
			if((ds18b20.DiscoveredQuantity == 0) || (err != OW_OK))
			{
				sysState.CurrentWaterTemp = 0;
				temp_sensors_err_counter++;
				
//				HAL_UART_MspDeInit(&huart5);
//				HAL_UART_MspInit(&huart5);
//				MX_UART5_Init();
				
				// Discovered termosensors qwantity on COM5
				ds18b20.DiscoveredQuantity = ds18b20_init(&huart5, &com5);
				err = OW_OK;
			}

			ds18b20.GetSensorsData = 0;
			
			// Сформировать статистику по температурам (раз в 1 сек)
			Make_temperature_statistics(&e2p, &sysState);
		}
		
    /* USER CODE END WHILE */

    /* USER CODE BEGIN 3 */
  }
  /* USER CODE END 3 */
}

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
/* USER CODE BEGIN 4 */

void HAL_Delay(uint32_t Delay)
{
  uint32_t tickstart = 0;
  tickstart = HAL_GetTick();
  while((HAL_GetTick() - tickstart) < Delay)
  {
		// Сброс watchdog
		IWDG->KR=0xAAAA;
  }
}


// Reset indication
void Leds_on_off(void)
{
	LED1_ON;
	HAL_Delay(50);
	LED2_ON;
	
	HAL_Delay(200);

	LED2_OFF;
	HAL_Delay(50);
	LED1_OFF;
	HAL_Delay(50);
}


// USART Tx transmit completed callback
void HAL_UART_TxCpltCallback(UART_HandleTypeDef *huart)
{
	if (huart->Instance == USART1)
	{
		com1.TxdPacketIsSent = 1;
		// Starting interpacket timer
		com1.TxdPacketReadyToSendTimer = 1;
		
		// Если отключено добавление паузы между пакетами
		if(COM1_DATA_PACKET_SENDING_INTERVAL == 0)
		{
			com1.TxdPacketIsReadyToSend = 1;
		}
	}

	else if (huart->Instance == USART2)
	{
		com2.TxdPacketIsSent = 1;
		// Starting interpacket timer
		com2.TxdPacketReadyToSendTimer = 1;
		
		// Если отключено добавление паузы между пакетами
		if(COM2_DATA_PACKET_SENDING_INTERVAL == 0)
		{
			com2.TxdPacketIsReadyToSend = 1;
		}
	}

	else if (huart->Instance == USART3)
	{
		com3.TxdPacketIsSent = 1;
		// Starting interpacket timer
		com3.TxdPacketReadyToSendTimer = 1;
		
		// Если отключено добавление паузы между пакетами
		if(COM3_DATA_PACKET_SENDING_INTERVAL == 0)
		{
			com3.TxdPacketIsReadyToSend = 1;
		}
	}
	
	else if (huart->Instance == UART4)
	{
		com4.TxdPacketIsSent = 1;
		// Starting interpacket timer
		com4.TxdPacketReadyToSendTimer = 1;
		
		// Если отключено добавление паузы между пакетами
		if(COM4_DATA_PACKET_SENDING_INTERVAL == 0)
		{
			com4.TxdPacketIsReadyToSend = 1;
		}
	}
	
	else if (huart->Instance == UART5)
	{
		com5.TxdPacketIsSent = 1;
		// Starting interpacket timer
		com5.TxdPacketReadyToSendTimer = 1;
		
		// Если отключено добавление паузы между пакетами
		if(COM5_DATA_PACKET_SENDING_INTERVAL == 0)
		{
			com5.TxdPacketIsReadyToSend = 1;
		}
	}
}


// Обработчик принимаемых данных по USART
void HAL_UART_RxCpltCallback(UART_HandleTypeDef *huart)
{
	// Com1
	if (huart->Instance == USART1 && com1.RxdPacketIsReceived == 0)
	{
		// Перезапуск таймера контроля непрерывности данных
		com1.RxDataFlowGapTimer = 1;
		
		// Сохранение приходящих символов, если начался приём строки
		if(jetson.ComLink == COM1)
		{
			if (com1.RxdIdx8 < sizeof(jetson.RxdBuffer))
			{
				jetson.RxdBuffer[com1.RxdIdx8++] = com1.ByteReceived;      
			}
				
			// проверка на заполнение буфера приёма
			if (com1.RxdIdx8 >= sizeof(jetson.RxdBuffer))
			{
				// Сохраняем длину принятой строки
				com1.RxdPacketLenght8 = com1.RxdIdx8;
				// Отключение контроля непрерывности данных
				com1.RxDataFlowGapTimer = 0;
				com1.RxdPacketIsReceived = 1;
				com1.RxdIdx8 = 0;
			} 
		}

		else if(nextion.ComLink == COM1)
		{
			if (com1.RxdIdx8 < sizeof(nextion.RxdBuffer))
			{
				nextion.RxdBuffer[com1.RxdIdx8++] = com1.ByteReceived;      
			}
				
			// проверка на заполнение буфера приёма
			if (com1.RxdIdx8 >= sizeof(nextion.RxdBuffer))
			{
				// Сохраняем длину принятой строки
				com1.RxdPacketLenght8 = com1.RxdIdx8;
				// Отключение контроля непрерывности данных
				com1.RxDataFlowGapTimer = 0;
				com1.RxdPacketIsReceived = 1;
				com1.RxdIdx8 = 0;
			} 		
		}
	}

	// Com2
	else if (huart->Instance == USART2)
	{
		// Перезапуск таймера контроля непрерывности данных
		com2.RxDataFlowGapTimer = 1;
		
		// �?ндикация приёма любого байта от дисплея Nextion
		//LED1_ON;

		// Сохранение приходящих символов, если начался приём строки
		if (com2.RxdIdx8 < sizeof(nextion.RxdBuffer))
		{
			nextion.RxdBuffer[com2.RxdIdx8++] = com2.ByteReceived;      
		}

		// проверка на завершение прихода (принимаемой в данный момент) строки по маркерам конца строки
		if (nextion.RxdBuffer[com2.RxdIdx8 - 1] == 0xFF)
		{
			if ((com2.RxdIdx8-1 != 0)&&(nextion.RxdBuffer[com2.RxdIdx8 - 2] == 0xFF))
			{
				if ((com2.RxdIdx8-2 != 0)&&(nextion.RxdBuffer[com2.RxdIdx8 - 3] == 0xFF))
				{
					// Сохраняем длину принятой строки
					com2.RxdPacketLenght8 = com2.RxdIdx8;
					// Отключение контроля непрерывности данных
					com2.RxDataFlowGapTimer = 0;
					com2.RxdPacketIsReceived = 1;
					com2.RxdIdx8 = 0;
				}
			}
		}
			
		// проверка на заполнение буфера приёма
		if (com2.RxdIdx8 >= sizeof(nextion.RxdBuffer))
		{
			// Сохраняем длину принятой строки
			com2.RxdPacketLenght8 = com2.RxdIdx8;
			// Отключение контроля непрерывности данных
			com2.RxDataFlowGapTimer = 0;
			com2.RxdPacketIsReceived = 1;
			com2.RxdIdx8 = 0;
		} 
	
		// Продолжаем, приём след. байта
		//HAL_UART_Receive_IT(&huart2, (uint8_t *) &com2.ByteReceived, 1);
	}
	
	// Com5
	else if (huart->Instance == UART5)
	{
		// Обработка в onewire.с в OW_Reset(), OW_Send() и в OW_SendBits()
		com5.RxdPacketIsReceived = 1;
	}
}


void HAL_UART_ErrorCallback(UART_HandleTypeDef *huart)
{
	// Com1
	if (huart->Instance == USART1)
	{
		com1.RxdPacketsErrorCounter++;
		HAL_UART_Receive_DMA(&huart1,(uint8_t *) &com1.ByteReceived, 1);
	}
	
	// Com2
	else if (huart->Instance == USART2)
	{
		com2.RxdPacketsErrorCounter++;
		HAL_UART_Receive_DMA(&huart2,(uint8_t *) &com2.ByteReceived, 1);
	}
}


// Starts receiving data on COM ports
void Com_start_receiving_data(ComNum_t ComNum)
{
	// Completing Com1 structure and data receive start
	if (ComNum == COM1)
	{
		com1.RxdIdx8 = 0;
		com1.RxdPacketIsReceived = 0;
		com1.RxDataFlowGapTimer = 0;
		HAL_UART_Receive_DMA(&huart1,(uint8_t *) &com1.ByteReceived, 1);
	}		

	// Completing Com2 structure and data receive start
	else if (ComNum == COM2)
	{
		com2.RxdIdx8 = 0;
		com2.RxdPacketIsReceived = 0;
		com2.RxDataFlowGapTimer = 0;
		HAL_UART_Receive_DMA(&huart2,(uint8_t *) &com2.ByteReceived, 1);
	}		
}




// Обработчик событий перепада уровней на входах МК
void HAL_GPIO_EXTI_Callback(uint16_t GPIO_Pin)
{
	static uint32_t time_point_prev = 0;
	
	// Если сработал счётный вход от счётчика воды (1 импульс на каждые 10 литров)
	if (GPIO_Pin == WATER_COUNTER_EXTI3_Pin) {
		// Если уровень =1 (включено)
		if (WATER_COUNTER_EXTI3_READ_PIN == 1) {
			if(e2p.Calibrations->WaterCounterLitersPerImpulse > 0) {
				// Задержка для борьбы с дребезгом контактов
				if(HAL_GetTick() - time_point_prev >= 100) {				
					// Если в  поливе
					if(*sysState.pumpCurrState == WateringMode) {
						if(e2p.LastPumpCycle->WateringVolumeCounter < e2p.Calibrations->WateringVolume) {
							// Счёт кол-ва воды, перекачанной насосом при поливе, литры
							e2p.LastPumpCycle->WateringVolumeCounter += e2p.Calibrations->WaterCounterLitersPerImpulse;
						}
					}
					
					// Счёт кол-ва воды, перекачанной насосом в текущем цикле, литры
					e2p.LastPumpCycle->WaterPumpedAtLastCycle += e2p.Calibrations->WaterCounterLitersPerImpulse;					
					// Счёт кол-ва воды, перекачанной насосом за текущие сутки, литры
					e2p.Statistics->PumpedWaterQuantityToday += e2p.Calibrations->WaterCounterLitersPerImpulse;
					// Счёт общего кол-ва воды, перекачанной насосом, литры
					e2p.Statistics->WaterPumpedTotal += e2p.Calibrations->WaterCounterLitersPerImpulse;
					
					time_point_prev = HAL_GetTick();
				}
			}
		}
		
		// Сброс флага вторичной сработки
		EXTI->PR |= WATER_COUNTER_EXTI3_Pin;
	}
	
	// Если сработал счётный вход от турбины (несколько импульсов на каждый литр)
	else if (GPIO_Pin == TURBINE_COUNTER_EXTI2_Pin) {
		// Если уровень = 1 (включено)
		if (TURBINE_EXTI2_READ_PIN == 1) {
			if(e2p.Calibrations->TurbineImpulsesPerLiter > 0) {			
				e2p.LastPumpCycle->TurbineImpCounter++;
				
				if(e2p.LastPumpCycle->TurbineImpCounter >= e2p.Calibrations->TurbineImpulsesPerLiter) {
					// Если в  поливе
					if(*sysState.pumpCurrState == WateringMode) {
						if(e2p.LastPumpCycle->WateringVolumeCounter < e2p.Calibrations->WateringVolume) {
							// Счёт кол-ва воды, перекачанной насосом при поливе, литры
							e2p.LastPumpCycle->WateringVolumeCounter += 1;
						}						
					}

					// Счёт кол-ва воды, перекачанной насосом в текущем цикле, литры
					e2p.LastPumpCycle->WaterPumpedAtLastCycle++;
					// Счёт кол-ва воды, перекачанной насосом за текущие сутки, литры
					e2p.Statistics->PumpedWaterQuantityToday++;					
					// Счёт общего кол-ва воды, перекачанной насосом, литры
					e2p.Statistics->WaterPumpedTotal++;
					
					e2p.LastPumpCycle->TurbineImpCounter = 0;
				}
			}
		}
		
		// Сброс флага вторичной сработки
		EXTI->PR |= TURBINE_COUNTER_EXTI2_Pin;
	}
}


void HAL_SYSTICK_Callback(void)
{
	static uint8_t		time_led_timer = 0;
	static uint16_t		periph_scan_timer = 0;
	static uint16_t		nextion_send_timer = 0;
	static uint16_t		control_data_timeout_timer = 0;
	static uint8_t		brightness_dim_already_done = 0;
	static uint16_t		timer_1000ms = 0, dry_work_timer = 0;
	static uint32_t		PumpedQuantityAtLastCycle_at_zero = 0;

	// Таймер отсылки данных в дисплей Nextion
	nextion_send_timer++;
	if (nextion_send_timer > NEXTION_REFRESH_PERIOD)
	{
		// Флаг выполнения обновления экрана
		nextion.RefreshReady = 1;
		nextion_send_timer = 0;
	}
	
	// Таймер паузы между опросами термодатчиков
	ds18b20.PollingWaitTimer++;
	if (ds18b20.PollingWaitTimer > TERMO_SENSORS_POLL_PERIOD)
	{
		// Флаг выполнения опроса датчиков
		ds18b20.GetSensorsData = 1;
		ds18b20.PollingWaitTimer = 0;
	}
	
	// Счёт секунд, проверка временных условий
	timer_1000ms++;
	if (timer_1000ms >= 1000)
	{
		timer_1000ms = 0;

		// Общее время работы контроллера, секунд
		e2p.Statistics->TotalControllerWorkingTime++;
		
		// Наработка УФ лампы
		if(*sysState.uvLampState != uvLampIsOff) {
			e2p.Statistics->UvLampWorkingTime++;
		}

		// Если насос запущен
		if (sysState.PumpIsStarted)
		{
			// Если в  режиме полива
			if(*sysState.pumpCurrState == WateringMode) {
				if(e2p.LastPumpCycle->WateringTimer < e2p.Calibrations->WateringTime) {
					e2p.LastPumpCycle->WateringTimer += 1;
				}
			}
			//else {
				// Если насос включен, то считаем время работы за одно включение, сек
				e2p.LastPumpCycle->PumpWorkingTimeAtLastCycle++;
			//}
			
			// Общее время работы насоса, секунд
			e2p.Statistics->TotalPumpWorkingTime++;
			
			// Обновляем точку отсчёта для обнаружения события "сухого хода" при нуле таймера
			if (dry_work_timer == 0) PumpedQuantityAtLastCycle_at_zero = e2p.Statistics->WaterPumpedTotal;
			
			dry_work_timer++;
			
			// Если прошло контрольное время,
			if (dry_work_timer >= e2p.LastPumpCycle->PumpDryRunStopTimeout)
			{
				// а значение "счётчика воды за цикл" не изменилось,
				if (PumpedQuantityAtLastCycle_at_zero == e2p.Statistics->WaterPumpedTotal)
				{
					// то фиксируем событие "сухого хода"
					sysState.DryRunProtectiveStop = 1;
				}
				
				dry_work_timer = 0;
			}
		}
		// Если не запущен, то обнуление счётчика времени отслеживания "сухого хода"
		else
		{
			dry_work_timer = 0;
		}
		
		// Таймер яркости дисплея
		if (display_brightness_timer > 0)
		{
			display_brightness_timer--;
			// Если досчитали до нуля, то однократная модификация флага
			if (display_brightness_timer == 0) brightness_dim_already_done = 0;
		}
	}

	// Если ещё не уменьшали плавно яркость дисплея
	if (brightness_dim_already_done == 0)
	{
		// При достижении таймаута
		if (display_brightness_timer == 0)
		{
			// Плавное уменьшение яркости дисплея в течение 2сек
			if (display_brightness > (DISPLAY_BRIGHTNESS_MIN_VALUE * DISPLAY_BRIGHTNESS_OFF_SPEED)) display_brightness--;
			// Прекращение плавного уменьшения яркости дисплея
			else brightness_dim_already_done = 1;
		}
	}
	
	// Таймер в мсек для выполнения потока опроса и управления периф. устройствами
	periph_scan_timer++;
	if (periph_scan_timer >= PERIPH_SCAN_TIMER_TIMEOUT)
	{
		// Флаг разрешения выполнения основного потока обслуживания периф. устройств 
		periph_scan_enabled = 1;
		periph_scan_timer = 0;
	}

	
	// Таймер 500 мсек для определения обрыва связи
	control_data_timeout_timer++;
	if (control_data_timeout_timer > NO_DATA_TIMEOUT_VALUE)
	{
		control_link_is_lost = 1;
		control_data_timeout_timer = 0;
	}

	
	// Приём по COM1
	if(COM1_DATA_FLOW_GAP_TIME_VALUE)
	{
		if (com1.RxDataFlowGapTimer != 0)
		{
			com1.RxDataFlowGapTimer++;

			// По истечении заданных мс при разрыве в данных считаем пакет завершённым, проверяем
			if (com1.RxDataFlowGapTimer >= COM1_DATA_FLOW_GAP_TIME_VALUE + 1)
			{
				// If received not zero length
				if(com1.RxdIdx8)
				{
					com1.RxdPacketIsReceived = 1;
					//com1.RxdPacketIsStarted = 0;
					// Getting received string length
					com1.RxdPacketLenght8 = com1.RxdIdx8;
					com1.RxdIdx8 = 0;
				}
				// Turning off data continuity watching timer
				com1.RxDataFlowGapTimer = 0;
			}
		}
	}
	
	// Передача по COM1, добавление паузы между пакетами
	if(COM1_DATA_PACKET_SENDING_INTERVAL)
	{
		if(com1.TxdPacketReadyToSendTimer) com1.TxdPacketReadyToSendTimer++;
		if(com1.TxdPacketReadyToSendTimer >= COM1_DATA_PACKET_SENDING_INTERVAL + 1)
		{
			com1.TxdPacketIsReadyToSend = 1;
			com1.TxdPacketReadyToSendTimer = 0;
		}
	}

	
	// Приём по COM2
		if(COM2_DATA_FLOW_GAP_TIME_VALUE)
	{
		if (com2.RxDataFlowGapTimer != 0)
		{
			com2.RxDataFlowGapTimer++;

			// По истечении заданных мс при разрыве в данных считаем пакет завершённым, проверяем
			if (com2.RxDataFlowGapTimer >= COM2_DATA_FLOW_GAP_TIME_VALUE + 1)
			{
				// If received not zero length
				if(com2.RxdIdx8)
				{
					com2.RxdPacketIsReceived = 1;
					//com2.RxdPacketIsStarted = 0;
					// Getting received string length
					com2.RxdPacketLenght8 = com2.RxdIdx8;
					com2.RxdIdx8 = 0;
				}
				// Turning off data continuity watching timer
				com2.RxDataFlowGapTimer = 0;
			}
		}
	}

	// Передача по COM2, добавление паузы между пакетами
	if(COM2_DATA_PACKET_SENDING_INTERVAL)
	{
		if(com2.TxdPacketReadyToSendTimer) com2.TxdPacketReadyToSendTimer++;
		if(com2.TxdPacketReadyToSendTimer >= COM2_DATA_PACKET_SENDING_INTERVAL + 1)
		{
			com2.TxdPacketIsReadyToSend = 1;
			com2.TxdPacketReadyToSendTimer = 0;
		}
	}

	
	// Выключение св-диода индикации секундной метки
	if (time_led_is_on) time_led_timer++;
	if (time_led_timer > 2)
	{
		LED2_OFF;	
		time_led_is_on = 0;
		time_led_timer = 0;
	}
}


// Копирование из одного буфера во 2-ой
void Copy_buf(uint8_t * source_buf, uint8_t * dest_buf, uint16_t buf_lenght)
{
	uint16_t idx=0;
	
	while (buf_lenght>0)
	{
		dest_buf[idx] = source_buf[idx];
		idx++;
		buf_lenght--;
	}
}


// Завершение измерения АЦП1
void HAL_ADC_ConvCpltCallback(ADC_HandleTypeDef* hadc)
{
	if (hadc->Instance == ADC1)
	{
		adc1.DataReady = 1;
	}

	else if (hadc->Instance == ADC2)
	{
		//adc2.DataReady = 1;
	}
}


// Пересчёт значений АЦП1 для каждого канала в вольты
void Voltage_calc_from_adc_value(E2p_t * e2p, CurrentSystemState_t * sysState)
{
	float	voltage;
	
	// Канал измерения напряжения питания +5В, аналог. вход ADC2_IN10*****************************
	{
		voltage = (float) HAL_ADC_GetValue(&hadc2);
		voltage *= ADC_LSB_VALUE;
		voltage *= FIVE_VOLTS_DIVISION_COEFF;

		// Единицы целых будут отображать единицы милливольт
		voltage /= 1;
		voltage = roundf(voltage);      

		adc1.VoltsBuf[0] = (int32_t) voltage;
	}

	// Канал измерения напряжения на аналог. входе (Д.Д.) AIN2 XP3.3 (+0,5..4,5В)******************
	{
		voltage = (float) (adc1.CountsBuf[Channel11] & 0x0000FFFF);
		voltage *= ADC_LSB_VALUE;
		voltage *= FIVE_VOLTS_DIVISION_COEFF;

		// Единицы целых будут отображать единицы милливольт
		voltage /= 1;
		voltage = roundf(voltage);      

		adc1.VoltsBuf[1] = (int32_t) voltage;
		
		// Давление воды в системе: (U тек. - U min)*( (P max - P min)/(U max - U min) )
		//voltage /= 100;
		voltage -= (float)e2p->Calibrations->PsensorMinPressureVoltage * 100;
		voltage *= ((float)e2p->Calibrations->PsensorMaxPressure - (float)e2p->Calibrations->PsensorMinPressure);
		voltage /= ((float)e2p->Calibrations->PsensorMaxPressureVoltage * 100 - (float)e2p->Calibrations->PsensorMinPressureVoltage * 100);
		//voltage *= 10;
		if (voltage < 0) voltage = 0;
		voltage = roundf(voltage);      

		sysState->WaterPressure = (int16_t) voltage;
		
		//if (WaterPressure<0) WaterPressure=0;
	}

	return;
}


// Initial hardware user settings
void Init_sequence(void)
{
	HAL_StatusTypeDef						HAL_func_res;

	// Определение размера структур для сохранения/восстановления из eeprom 
	e2p.StructSize = (uint16_t) sizeof(e2p);
	stats.StructSize = (uint16_t) sizeof(stats);
	calib.StructSize = (uint16_t) sizeof(calib);
	water_ctrl.StructSize = (uint16_t) sizeof(water_ctrl);
	last_pump_cycle.StructSize = (uint16_t) sizeof(last_pump_cycle);
	
	// Filling structure with addresses of sub structures
	e2p.Statistics 				= &stats;
	e2p.WateringControls 	= &water_ctrl;
	e2p.Calibrations			=	&calib;
	e2p.LastPumpCycle			= &last_pump_cycle;
	
	sysState.uvLampState = &uvLampState;
	sysState.pumpCurrState = &pumpState;
	sysState.pumpCtrlComms = &pumpComms;
	
	// Настройка слежения за появлением питания (срабатывает не при восстановлении, а при падении)
	//PVD_Config();
	
	// Запись калибровочного коэффициента (0-127) для коррекции хода часов реального времени ( ppm -> сек/месяц, 127 = -314 сек/мес)

	HAL_func_res = HAL_RTCEx_SetSmoothCalib(&hrtc, 0, 0, RTC_TIME_CALIBRATION_COEFF);
	
	DISPLAY_POWER_ENABLE;
	
	RXD1_DISABLE;
	RXD4_DISABLE;
	RXD3_DISABLE;
	
	WATER_PUMP_OFF;
	WATER_ZONE1_OFF;
	WATER_ZONE2_OFF;
	WATER_ZONE3_OFF;
	WATER_ZONE4_OFF;
	WATER_ZONE5_OFF;
	WATER_ZONE6_OFF;
	PWR_CTRL1_OFF;
	UV_STERILIZER_OFF;
	
	// ADC autocalibration
	HAL_ADCEx_Calibration_Start(&hadc1);
	HAL_ADCEx_Calibration_Start(&hadc2);

	HAL_TIM_OC_Start(&htim4, TIM_CHANNEL_4);
	
	// без этого не работает ацп в связке с таймером 4 по capture/compare
	TIM4->CCMR2 |= TIM_CCMR2_OC4M_1 | TIM_CCMR2_OC4M_2;
	TIM4->CR2 |= TIM_CR2_OIS4;
	
	// Сброс watchdog
	IWDG->KR = IWDG_KEY_RELOAD;
		
	// Запуск АЦП1
	adc1.DataReady = 0;
	HAL_func_res = HAL_ADC_Start_DMA(&hadc1, adc1.CountsBuf, sizeof(adc1.CountsBuf) / 4 );
	// Запуск АЦП2
	HAL_func_res = HAL_ADC_Start(&hadc2);

	// Сброс флага обнаружения восстановления питания
	power_up_detected = 0;
	
	ADC2->LTR = 0;
	ADC2->HTR = ADC_WDG_HIGH_THRESHOLD;
	// Clear the ADC analog watchdog flag
  __HAL_ADC_CLEAR_FLAG(&hadc2, ADC_FLAG_AWD);
	// Enable ADC analog watchdog interrupt
	__HAL_ADC_ENABLE_IT(&hadc2, ADC_IT_AWD);

	// Ждём восстановления напряжения питания цепи +5В, >= ADC_WDG_HIGH_THRESHOLD
	while (power_up_detected == 0)
	{
		// Reset indication
		Leds_on_off();
	}
	
	// Сброс флага обнаружения восстановления питания
	power_up_detected = 0;
	
	ADC2->LTR = ADC_WDG_LOW_THRESHOLD;
	ADC2->HTR = 4095;
	// Clear the ADC analog watchdog flag
  __HAL_ADC_CLEAR_FLAG(&hadc2, ADC_FLAG_AWD);
	// Enable ADC analog watchdog interrupt
	__HAL_ADC_ENABLE_IT(&hadc2, ADC_IT_AWD);
	
	// Восстановление рабочих переменных из eeprom
	Restore_all_data(&hcrc, &hi2c1, &hrtc, &e2p);

	// Naming working structures of Com ports 
	com1.ComNum = COM1;
	com2.ComNum = COM2;
	com3.ComNum = COM3;
	com4.ComNum = COM4;
	
	// Link logical Com port to physical
	nextion.ComLink = NEXTION_DISPLAY_COM_PORT;
	jetson.ComLink = JETSON_COM_PORT;
	external.ComLink = EXTERNAL_INTERFACE_COM_PORT;

	// Link logical structure to physical usart1
	if(jetson.ComLink == COM1)
	{
		jetson.Com = &com1;
		jetson.ComRingBuf = &com1_ring_buf;
		jetson.ComRingBuf->ComLink = COM1;
	}
	else if(nextion.ComLink == COM1)
	{
		nextion.Com = &com1;
		nextion.ComRingBuf = &com1_ring_buf;
		nextion.ComRingBuf->ComLink = COM1;
	}
	else if(external.ComLink == COM1)
	{
		external.Com = &com1;
		external.ComRingBuf = &com1_ring_buf;
		external.ComRingBuf->ComLink = COM1;
	}

	// Link logical structure to physical usart2
	if(jetson.ComLink == COM2)
	{
		jetson.Com = &com2;
		jetson.ComRingBuf = &com2_ring_buf;
		jetson.ComRingBuf->ComLink = COM2;
	}
	else if(nextion.ComLink == COM2)
	{
		nextion.Com = &com2;
		nextion.ComRingBuf = &com2_ring_buf;
		nextion.ComRingBuf->ComLink = COM2;
	}
	else if(external.ComLink == COM2)
	{
		external.Com = &com2;
		external.ComRingBuf = &com2_ring_buf;
		external.ComRingBuf->ComLink = COM2;
	}
	
	// Init ring buffers for data sending by UART
	// Setting sizes of elements of buffers
	com1_ring_buf.PBufElementSize = 4;		// uint32_t = 4 bytes
	com2_ring_buf.PBufElementSize = 4;		// uint32_t = 4 bytes
	com1_ring_buf.DBufElementSize = 1;		// uint8_t  = 1 byte
	com2_ring_buf.DBufElementSize = 1;		// uint8_t  = 1 byte
	
	// Setting mask for index wrapping when accessing ring data buffer
	com1_ring_buf.DBufMask = sizeof(com1_ring_buf.DBuf) / com1_ring_buf.DBufElementSize - 1;
	com2_ring_buf.DBufMask = sizeof(com2_ring_buf.DBuf) / com2_ring_buf.DBufElementSize - 1;
	// Setting mask for index wrapping when accessing ring pointers buffer
	com1_ring_buf.PBufMask = sizeof(com1_ring_buf.PBuf) / com1_ring_buf.PBufElementSize - 1;
	com2_ring_buf.PBufMask = sizeof(com2_ring_buf.PBuf) / com1_ring_buf.PBufElementSize - 1;

	// Prepare for first sending (starting sending timers)
	com1.TxdPacketIsReadyToSend = 1;
	com1.TxdPacketReadyToSendTimer = 1;  // Enables counting time intervals between sendings, using as pause
	com2.TxdPacketIsReadyToSend = 1;
	com2.TxdPacketReadyToSendTimer = 1;
	com3.TxdPacketIsReadyToSend = 1;
	com3.TxdPacketReadyToSendTimer = 1;
	com4.TxdPacketIsReadyToSend = 1;
	com4.TxdPacketReadyToSendTimer = 1;
	com5.TxdPacketIsReadyToSend = 1;
	com5.TxdPacketReadyToSendTimer = 1;
	
	// Com ports data receive starting
	Com_start_receiving_data(COM1);
	Com_start_receiving_data(COM2);
	Com_start_receiving_data(COM3);
	Com_start_receiving_data(COM4);
	//Com_start_receiving_data(COM5);		// Termosensor's COM port, initializing in ds18b20.c
	
	// Яркость дисплея на max (2000/20=100%)
	display_brightness = DISPLAY_BRIGHTNESS_MAX_VALUE*DISPLAY_BRIGHTNESS_OFF_SPEED;
	// Запуск таймера уменьшения яркости дисплея
	display_brightness_timer = DISPLAY_BRIGHTNESS_OFF_DELAY;
	
	// Setting instance name (number)
	com5.ComNum = COM5;
	// Discovered termosensors qwantity on COM5
	ds18b20.DiscoveredQuantity = ds18b20_init(&huart5, &com5);
	
	// Waits until the RTC registers (RTC_CNT, RTC_ALR and RTC_PRL) are synchronized with RTC APB clock
	HAL_func_res = HAL_RTC_WaitForSynchro(&hrtc);

	HAL_Delay(500);
}


// Разбор принятой строки от дисплея Nextion
void Parsing_nextion_display_string(RTC_HandleTypeDef  * hrtc, E2p_t * e2p, uint8_t * buf,
																		uint16_t string_lenght, uint8_t string_status, CurrentSystemState_t * sysState)
{
	const uint32_t 	key_is_pressed = 0x71010000;
	const uint32_t 	key_is_released = 0x71000000;
	uint8_t					large_step = 0;
	static uint8_t	state_machine = 0;
	static uint32_t	source_type = 0;
	static uint32_t	source_value = 0;
	static uint32_t	key_pressing_time_moment = 0;
	int32_t 				time_temp;

	// Если статус строки !=0, то обрабатываем как вновь принятую, иначе - повторяем, как предыдущую
	if (string_status != 0)
	{
		// 4 байта - идентификатор события
		source_type  = ((uint32_t) buf[0]) << 24;
		source_type |= ((uint32_t) buf[1]) << 16;
		source_type |= ((uint32_t) buf[2]) << 8;
		source_type |= ((uint32_t) buf[3]) << 0;

		// 4 байта - значение
		source_value  = ((uint32_t) buf[4]) << 24;
		source_value |= ((uint32_t) buf[5]) << 16;
		source_value |= ((uint32_t) buf[6]) << 8;
		source_value |= ((uint32_t) buf[7]) << 0;
		
		// Фиксируем момент нажатия кнопки на дисплее
		key_pressing_time_moment = HAL_GetTick();
		// Кнопка только нажата, ещё не обработана
		state_machine = 0;

			// Яркость дисплея на max (2000/20=100%)
		display_brightness = DISPLAY_BRIGHTNESS_MAX_VALUE * DISPLAY_BRIGHTNESS_OFF_SPEED;
		// Запуск таймера уменьшения яркости дисплея
		display_brightness_timer = DISPLAY_BRIGHTNESS_OFF_DELAY;
	}
		
	// Если кнопка на дисплее нажата и обработана 1 раз
	if (state_machine == 1)
	{
		// Секундная пауза перед автоинкрементом/автодекрементом
		if (HAL_GetTick() < key_pressing_time_moment + 1000) return;
		else
		{
			state_machine = 2;
			large_step = 0;
		}
	}

	if (state_machine == 2)
	{
		// 20-ти секундная пауза перед автоинкрементом/автодекрементом числами *1000
		if (HAL_GetTick() >= key_pressing_time_moment + 20000) large_step = 3;
		// 10-ти секундная пауза перед автоинкрементом/автодекрементом числами *100
		if (HAL_GetTick() >= key_pressing_time_moment + 10000) large_step = 2;
		// 5-ти секундная пауза перед автоинкрементом/автодекрементом числами *10
		else if (HAL_GetTick() >= key_pressing_time_moment + 5000) large_step = 1;
		else large_step = 0;
	}
		
	// Если кнопка была отжата, то обеспечиваем реакцию на повторное нажатие
	if (source_value == key_is_released)
	{
		// Если это не код номера экрана scrX
		if((source_type & 0xFFFFFF00) != 0x53637200)
		{
			state_machine = 0;
			// Обновляем момент нажатия кнопки на дисплее
			key_pressing_time_moment = 0;
			
			return;
		}
	}

	if (state_machine == 0) state_machine = 1;
	
	// Чтение текущего времени
	time_temp = Get_time_in_sec(hrtc);
	
	// Разбор принятой строки
	switch (source_type)
	{	
		// Если нажата кнопка ручного принудительного включения насоса
		case PumpOn:
		{
			if (source_value == key_is_pressed) {
				// Если не активен какой-либо режим работы
				if(*sysState->pumpCurrState == IdleMode) {
					// Обнуление счётчиков значений последнего цикла
					e2p->LastPumpCycle->PumpWorkingTimeAtLastCycle = 0;
					e2p->LastPumpCycle->WaterPumpedAtLastCycle = 0;
				}
				// Включить насос
				sysState->pumpCtrlComms->SwitchPumpOn = 1;
				*sysState->pumpCurrState = HandPumpingMode;					
			}
						
			break;
		}

		// Если нажата кнопка выключения насоса
		case PumpOff:
		{
			if (source_value == key_is_pressed)
			{
				// Если в режиме прогрева УФ лампы, индицируем
				if(*sysState->uvLampState == uvLampPreheating) {
					*sysState->uvLampState = uvLampBlinkWhilePreheating;
				}
			
				// Если не в режиме  полива
				//if(*sysState->pumpCurrState != WateringMode) {
					// Если не в режиме прогрева УФ лампы
					if((*sysState->uvLampState != uvLampPreheating) &&
						 (*sysState->uvLampState != uvLampBlinkWhilePreheating)) {
						// Выключить насос
						sysState->pumpCtrlComms->SwitchPumpOff = 1;

						// Если кнопка выкл. была нажата при активном событии "сухого хода", то
						if (sysState->DryRunProtectiveStop)
						{
							// сброс события "сухого хода"
							sysState->DryRunProtectiveStop = 0;
							
							// Возобновление автоподкачки, если была прервана "сухим ходом"
							if (*sysState->pumpCurrState == AutoPumpingMode)
							{
								// Отключение автоподкачки
								//e2p->LastPumpCycle->auto_pump_is_done = 0;
								
								// Включаем насос
								sysState->pumpCtrlComms->SwitchPumpOn = 1;
								sysState->pumpCtrlComms->SwitchPumpOff = 0;
							}
						}
						// Если событие "сухой ход" неактивно, то
						else
						{
							// Если кнопка выкл. была нажата при штатной работе автоподкачки, то
							if (*sysState->pumpCurrState == AutoPumpingMode)
							{
								// Разрешение повторной попытки автоподкачки воды
								*sysState->pumpCurrState = IdleMode;						
							}
						}
					}
				//}
			}

			break;
		}

		// Уменьшение давления включения насоса, атм * 10 ***************************
		case PumpOnPressureDec:
		{
			e2p->Calibrations->PumpOnPressure -= 1;
			if (e2p->Calibrations->PumpOnPressure < 0) e2p->Calibrations->PumpOnPressure = 0;
			break;
		}

		// Увеличение давления включения насоса, атм * 10
		case PumpOnPressureInc:
		{
			e2p->Calibrations->PumpOnPressure += 1;
			if (e2p->Calibrations->PumpOnPressure > PRESSURE_MAX_VALUE) e2p->Calibrations->PumpOnPressure = PRESSURE_MAX_VALUE;
			break;
		}

		// Уменьшение давления выключения насоса, атм * 10 ***************************
		case PumpOffPressureDec:
		{
			e2p->Calibrations->PumpOffPressure -= 1;
			if (e2p->Calibrations->PumpOffPressure < 0) e2p->Calibrations->PumpOffPressure = 0;
			break;
		}

		// Увеличение давления выключения насоса, атм * 10
		case PumpOffPressureInc:
		{
			e2p->Calibrations->PumpOffPressure += 1;
			if (e2p->Calibrations->PumpOffPressure > PRESSURE_MAX_VALUE) e2p->Calibrations->PumpOffPressure = PRESSURE_MAX_VALUE;
			break;
		}

		// Уменьшение минимального значения давления датчика давления, атм * 10 ******
		case PresSensorPminDec:
		{
			e2p->Calibrations->PsensorMinPressure -= 1;
			if (e2p->Calibrations->PsensorMinPressure < 0) e2p->Calibrations->PsensorMinPressure = 0;
			break;
		}

		// Увеличение минимального значения давления датчика давления, атм * 10
		case PresSensorPminInc:
		{
			e2p->Calibrations->PsensorMinPressure += 1;
			if (e2p->Calibrations->PsensorMinPressure > PRESSURE_MAX_VALUE) e2p->Calibrations->PsensorMinPressure = PRESSURE_MAX_VALUE;
			break;
		}
	
		// Уменьшение максимального значения давления датчика давления, атм * 10 ******
		case PresSensorPmaxDec:
		{
			e2p->Calibrations->PsensorMaxPressure -= 1;
			if (e2p->Calibrations->PsensorMaxPressure < 0) e2p->Calibrations->PsensorMaxPressure = 0;
			break;
		}

		// Увеличение максимального значения давления датчика давления, атм * 10
		case PresSensorPmaxInc:
		{
			e2p->Calibrations->PsensorMaxPressure += 1;
			if (e2p->Calibrations->PsensorMaxPressure > PRESSURE_MAX_VALUE) e2p->Calibrations->PsensorMaxPressure = PRESSURE_MAX_VALUE;
			break;
		}			

		// Уменьшение напряжения (0 - 5В), соотв. минимальному давлению датчика давления, мВ*100 ******
		case VoltageForPminDec:
		{
			e2p->Calibrations->PsensorMinPressureVoltage -= 1;
			if (e2p->Calibrations->PsensorMinPressureVoltage < 0) e2p->Calibrations->PsensorMinPressureVoltage = 0;
			break;
		}

		// Увеличение напряжения (0 - 5В), соотв. минимальному давлению датчика давления, мВ*100
		case VoltageForPminInc:
		{
			e2p->Calibrations->PsensorMinPressureVoltage += 1;
			if (e2p->Calibrations->PsensorMinPressureVoltage > MAX_PRESSURE_SENSOR_VOLTAGE)
					e2p->Calibrations->PsensorMinPressureVoltage = MAX_PRESSURE_SENSOR_VOLTAGE;
			break;
		}			

		// Уменьшение напряжения (0 - 5В), соотв. максимальному давлению датчика давления, мВ*100 ******
		case VoltageForPmaxDec:
		{
			e2p->Calibrations->PsensorMaxPressureVoltage -= 1;
			if (e2p->Calibrations->PsensorMaxPressureVoltage < 0) e2p->Calibrations->PsensorMaxPressureVoltage = 0;
			break;
		}

		// Увеличение напряжения (0 - 5В), соотв. максимальному давлению датчика давления, мВ*100
		case VoltageForPmaxInc:
		{
			e2p->Calibrations->PsensorMaxPressureVoltage += 1;
			if (e2p->Calibrations->PsensorMaxPressureVoltage > MAX_PRESSURE_SENSOR_VOLTAGE)
					e2p->Calibrations->PsensorMaxPressureVoltage = MAX_PRESSURE_SENSOR_VOLTAGE;
			break;
		}
		// Уменьшение времени срабатывания останова насоса по "сухому ходу", сек ******
		case PumpRunDryStopTimeoutDec:
		{
			if (large_step == 0)			e2p->LastPumpCycle->PumpDryRunStopTimeout -= 1;
			else if (large_step == 1)	e2p->LastPumpCycle->PumpDryRunStopTimeout -= 1;
			else if (large_step == 2)	e2p->LastPumpCycle->PumpDryRunStopTimeout -= 10;
			else if (large_step == 3)	e2p->LastPumpCycle->PumpDryRunStopTimeout -= 50;
			break;
		}

		// Увеличение времени срабатывания останова насоса по "сухому ходу", сек
		case PumpRunDryStopTimeoutInc:
		{
			if (large_step == 0)			e2p->LastPumpCycle->PumpDryRunStopTimeout += 1;
			else if (large_step == 1)	e2p->LastPumpCycle->PumpDryRunStopTimeout += 1;
			else if (large_step == 2)	e2p->LastPumpCycle->PumpDryRunStopTimeout += 10;
			else if (large_step == 3)	e2p->LastPumpCycle->PumpDryRunStopTimeout += 50;
			break;
		}
		
	// Полив
		// Уменьшение значения текущего номера выхода полива, 1-6 ******
		case CurrWateringOutputNumberDec:
		{
			e2p->WateringControls->CurrWateringOutputNumber -= 1;
			if (e2p->WateringControls->CurrWateringOutputNumber < 1) e2p->WateringControls->CurrWateringOutputNumber = 6;
			break;
		}

		// Увеличение значения текущего номера выхода полива, 1-6 ******
		case CurrWateringOutputNumberInc:
		{
			e2p->WateringControls->CurrWateringOutputNumber += 1;
			if (e2p->WateringControls->CurrWateringOutputNumber > 6) e2p->WateringControls->CurrWateringOutputNumber = 1;
			break;
		}	
				
		// Уменьшение значения смещения времени включения полива зоны 1-6 относительно начала суток, мин ******
		case OutxZeroClockTimeDeltaDec:
		{
			if (e2p->WateringControls->CurrWateringOutputNumber == 1) 			e2p->WateringControls->out1_zero_clock_time_delta -= 5;
			else if (e2p->WateringControls->CurrWateringOutputNumber == 2) e2p->WateringControls->out2_zero_clock_time_delta -= 5;
			else if (e2p->WateringControls->CurrWateringOutputNumber == 3) e2p->WateringControls->out3_zero_clock_time_delta -= 5;
			else if (e2p->WateringControls->CurrWateringOutputNumber == 4) e2p->WateringControls->out4_zero_clock_time_delta -= 5;
			else if (e2p->WateringControls->CurrWateringOutputNumber == 5) e2p->WateringControls->out5_zero_clock_time_delta -= 5;
			else if (e2p->WateringControls->CurrWateringOutputNumber == 6) e2p->WateringControls->out6_zero_clock_time_delta -= 5;

			if (e2p->WateringControls->out1_zero_clock_time_delta < 0) e2p->WateringControls->out1_zero_clock_time_delta = 1435;
			if (e2p->WateringControls->out2_zero_clock_time_delta < 0) e2p->WateringControls->out2_zero_clock_time_delta = 1435;
			if (e2p->WateringControls->out3_zero_clock_time_delta < 0) e2p->WateringControls->out3_zero_clock_time_delta = 1435;
			if (e2p->WateringControls->out4_zero_clock_time_delta < 0) e2p->WateringControls->out4_zero_clock_time_delta = 1435;
			if (e2p->WateringControls->out5_zero_clock_time_delta < 0) e2p->WateringControls->out5_zero_clock_time_delta = 1435;
			if (e2p->WateringControls->out6_zero_clock_time_delta < 0) e2p->WateringControls->out6_zero_clock_time_delta = 1435;
			break;
		}

		// Увеличение значения смещения времени включения полива зоны 1-6 относительно начала суток, мин
		case OutxZeroClockTimeDeltaInc:
		{
			if (e2p->WateringControls->CurrWateringOutputNumber == 1) 			e2p->WateringControls->out1_zero_clock_time_delta += 5;
			else if (e2p->WateringControls->CurrWateringOutputNumber == 2) e2p->WateringControls->out2_zero_clock_time_delta += 5;
			else if (e2p->WateringControls->CurrWateringOutputNumber == 3) e2p->WateringControls->out3_zero_clock_time_delta += 5;
			else if (e2p->WateringControls->CurrWateringOutputNumber == 4) e2p->WateringControls->out4_zero_clock_time_delta += 5;
			else if (e2p->WateringControls->CurrWateringOutputNumber == 5) e2p->WateringControls->out5_zero_clock_time_delta += 5;
			else if (e2p->WateringControls->CurrWateringOutputNumber == 6) e2p->WateringControls->out6_zero_clock_time_delta += 5;

			if (e2p->WateringControls->out1_zero_clock_time_delta > 1435) e2p->WateringControls->out1_zero_clock_time_delta = 0;
			if (e2p->WateringControls->out2_zero_clock_time_delta > 1435) e2p->WateringControls->out2_zero_clock_time_delta = 0;
			if (e2p->WateringControls->out3_zero_clock_time_delta > 1435) e2p->WateringControls->out3_zero_clock_time_delta = 0;
			if (e2p->WateringControls->out4_zero_clock_time_delta > 1435) e2p->WateringControls->out4_zero_clock_time_delta = 0;
			if (e2p->WateringControls->out5_zero_clock_time_delta > 1435) e2p->WateringControls->out5_zero_clock_time_delta = 0;
			if (e2p->WateringControls->out6_zero_clock_time_delta > 1435) e2p->WateringControls->out6_zero_clock_time_delta = 0;
			break;
		}		

		// Уменьшение значения времени работы полива зоны 1-6, мин ***************************
		case OutxWorkingTimeDec:
		{
			if (e2p->WateringControls->CurrWateringOutputNumber == 1)			e2p->WateringControls->out1_working_time -= 5;
			else if (e2p->WateringControls->CurrWateringOutputNumber == 2) e2p->WateringControls->out2_working_time -= 5;
			else if (e2p->WateringControls->CurrWateringOutputNumber == 3) e2p->WateringControls->out3_working_time -= 5;
			else if (e2p->WateringControls->CurrWateringOutputNumber == 4) e2p->WateringControls->out4_working_time -= 5;
			else if (e2p->WateringControls->CurrWateringOutputNumber == 5) e2p->WateringControls->out5_working_time -= 5;
			else if (e2p->WateringControls->CurrWateringOutputNumber == 6) e2p->WateringControls->out6_working_time -= 5;

			if (e2p->WateringControls->out1_working_time < 0) e2p->WateringControls->out1_working_time = 1435;
			if (e2p->WateringControls->out2_working_time < 0) e2p->WateringControls->out2_working_time = 1435;
			if (e2p->WateringControls->out3_working_time < 0) e2p->WateringControls->out3_working_time = 1435;
			if (e2p->WateringControls->out4_working_time < 0) e2p->WateringControls->out4_working_time = 1435;
			if (e2p->WateringControls->out5_working_time < 0) e2p->WateringControls->out5_working_time = 1435;
			if (e2p->WateringControls->out6_working_time < 0) e2p->WateringControls->out6_working_time = 1435;
			break;
		}

		// Увеличение значения времени работы полива зоны 1-6, мин
		case OutxWorkingTimeInc:
		{
			if (e2p->WateringControls->CurrWateringOutputNumber == 1) 			e2p->WateringControls->out1_working_time += 5;
			else if (e2p->WateringControls->CurrWateringOutputNumber == 2) e2p->WateringControls->out2_working_time += 5;
			else if (e2p->WateringControls->CurrWateringOutputNumber == 3) e2p->WateringControls->out3_working_time += 5;
			else if (e2p->WateringControls->CurrWateringOutputNumber == 4) e2p->WateringControls->out4_working_time += 5;
			else if (e2p->WateringControls->CurrWateringOutputNumber == 5) e2p->WateringControls->out5_working_time += 5;
			else if (e2p->WateringControls->CurrWateringOutputNumber == 6) e2p->WateringControls->out6_working_time += 5;

			if (e2p->WateringControls->out1_working_time > 1435) e2p->WateringControls->out1_working_time = 0;
			if (e2p->WateringControls->out2_working_time > 1435) e2p->WateringControls->out2_working_time = 0;
			if (e2p->WateringControls->out3_working_time > 1435) e2p->WateringControls->out3_working_time = 0;
			if (e2p->WateringControls->out4_working_time > 1435) e2p->WateringControls->out4_working_time = 0;
			if (e2p->WateringControls->out5_working_time > 1435) e2p->WateringControls->out5_working_time = 0;
			if (e2p->WateringControls->out6_working_time > 1435) e2p->WateringControls->out6_working_time = 0;
			break;
		}	

		// Уменьшение значения интервала времени между включениями полива зоны 1-6, мин
		case OutxWorkIntervalTimeDec:
		{
			if (e2p->WateringControls->CurrWateringOutputNumber == 1) 			e2p->WateringControls->out1_interval_time -= 5;
			else if (e2p->WateringControls->CurrWateringOutputNumber == 2) e2p->WateringControls->out2_interval_time -= 5;
			else if (e2p->WateringControls->CurrWateringOutputNumber == 3) e2p->WateringControls->out3_interval_time -= 5;
			else if (e2p->WateringControls->CurrWateringOutputNumber == 4) e2p->WateringControls->out4_interval_time -= 5;
			else if (e2p->WateringControls->CurrWateringOutputNumber == 5) e2p->WateringControls->out5_interval_time -= 5;
			else if (e2p->WateringControls->CurrWateringOutputNumber == 6) e2p->WateringControls->out6_interval_time -= 5;

			if (e2p->WateringControls->out1_interval_time < 0) e2p->WateringControls->out1_interval_time = 1435;
			if (e2p->WateringControls->out2_interval_time < 0) e2p->WateringControls->out2_interval_time = 1435;
			if (e2p->WateringControls->out3_interval_time < 0) e2p->WateringControls->out3_interval_time = 1435;
			if (e2p->WateringControls->out4_interval_time < 0) e2p->WateringControls->out4_interval_time = 1435;
			if (e2p->WateringControls->out5_interval_time < 0) e2p->WateringControls->out5_interval_time = 1435;
			if (e2p->WateringControls->out6_interval_time < 0) e2p->WateringControls->out6_interval_time = 1435;
			break;
		}

		// Увеличение значения интервала времени между включениями полива зоны 1-6, мин
		case OutxWorkIntervalTimeInc:
		{
			if (e2p->WateringControls->CurrWateringOutputNumber == 1) 			e2p->WateringControls->out1_interval_time+=5;
			else if (e2p->WateringControls->CurrWateringOutputNumber == 2) e2p->WateringControls->out2_interval_time+=5;
			else if (e2p->WateringControls->CurrWateringOutputNumber == 3) e2p->WateringControls->out3_interval_time+=5;
			else if (e2p->WateringControls->CurrWateringOutputNumber == 4) e2p->WateringControls->out4_interval_time+=5;
			else if (e2p->WateringControls->CurrWateringOutputNumber == 5) e2p->WateringControls->out5_interval_time+=5;
			else if (e2p->WateringControls->CurrWateringOutputNumber == 6) e2p->WateringControls->out6_interval_time+=5;

			if (e2p->WateringControls->out1_interval_time>1435) e2p->WateringControls->out1_interval_time=0;
			if (e2p->WateringControls->out2_interval_time>1435) e2p->WateringControls->out2_interval_time=0;
			if (e2p->WateringControls->out3_interval_time>1435) e2p->WateringControls->out3_interval_time=0;
			if (e2p->WateringControls->out4_interval_time>1435) e2p->WateringControls->out4_interval_time=0;
			if (e2p->WateringControls->out5_interval_time>1435) e2p->WateringControls->out5_interval_time=0;
			if (e2p->WateringControls->out6_interval_time>1435) e2p->WateringControls->out6_interval_time=0;
			break;
		}

		// Сброс установок для текущей зоны полива
		case CurrOutputSettingsToDefault:
		{
			if (e2p->WateringControls->CurrWateringOutputNumber == 1)
			{
				e2p->WateringControls->out1_interval_time = 0;
				e2p->WateringControls->out1_working_time = 0;
				e2p->WateringControls->out1_zero_clock_time_delta = 0;
			}
			else if (e2p->WateringControls->CurrWateringOutputNumber == 2)
			{
				e2p->WateringControls->out2_interval_time = 0;
				e2p->WateringControls->out2_working_time = 0;
				e2p->WateringControls->out2_zero_clock_time_delta = 0;				
			}

			else if (e2p->WateringControls->CurrWateringOutputNumber == 3)
			{
				e2p->WateringControls->out3_interval_time = 0;
				e2p->WateringControls->out3_working_time = 0;
				e2p->WateringControls->out3_zero_clock_time_delta = 0;				
			}

			else if (e2p->WateringControls->CurrWateringOutputNumber == 4)
			{
				e2p->WateringControls->out4_interval_time = 0;
				e2p->WateringControls->out4_working_time = 0;
				e2p->WateringControls->out4_zero_clock_time_delta = 0;				
			}

			else if (e2p->WateringControls->CurrWateringOutputNumber == 5)
			{
				e2p->WateringControls->out5_interval_time = 0;
				e2p->WateringControls->out5_working_time = 0;
				e2p->WateringControls->out5_zero_clock_time_delta = 0;				
			}

			else if (e2p->WateringControls->CurrWateringOutputNumber == 6)
			{
				e2p->WateringControls->out6_interval_time = 0;
				e2p->WateringControls->out6_working_time = 0;
				e2p->WateringControls->out6_zero_clock_time_delta = 0;				
			}
		
			break;
		}		
		
		// Уменьшение значения смещения времени автоподкачки относительно начала суток, мин ******
		case AutoPumpTimeDeltaFromStartOfDayDec:
		{
			if (large_step == 0)			e2p->LastPumpCycle->AutoPumpTimeDeltaFromStartOfDay -= 5;
			else if (large_step == 1)	e2p->LastPumpCycle->AutoPumpTimeDeltaFromStartOfDay -= 20;
			else if (large_step == 2)	e2p->LastPumpCycle->AutoPumpTimeDeltaFromStartOfDay -= 20;
			else if (large_step == 3)	e2p->LastPumpCycle->AutoPumpTimeDeltaFromStartOfDay -= 20;
			
			if (e2p->LastPumpCycle->AutoPumpTimeDeltaFromStartOfDay < 0) e2p->LastPumpCycle->AutoPumpTimeDeltaFromStartOfDay = 1435;
			break;
		}

		// Увеличение значения смещения времени автоподкачки относительно начала суток, мин
		case AutoPumpTimeDeltaFromStartOfDayInc:
		{
			if (large_step == 0)			e2p->LastPumpCycle->AutoPumpTimeDeltaFromStartOfDay += 5;
			else if (large_step == 1)	e2p->LastPumpCycle->AutoPumpTimeDeltaFromStartOfDay += 20;
			else if (large_step == 2)	e2p->LastPumpCycle->AutoPumpTimeDeltaFromStartOfDay += 20;
			else if (large_step == 3)	e2p->LastPumpCycle->AutoPumpTimeDeltaFromStartOfDay += 20;
			
			if (e2p->LastPumpCycle->AutoPumpTimeDeltaFromStartOfDay > 1435) e2p->LastPumpCycle->AutoPumpTimeDeltaFromStartOfDay = 0;
			break;
		}		

		// Уменьшение значения интервала времени между включениями автоподкачки, мин
		case AutoPumpIntervalTimeDec:
		{
			if (large_step == 0)			e2p->LastPumpCycle->AutoPumpTimeInterval -= 5;
			else if (large_step == 1)	e2p->LastPumpCycle->AutoPumpTimeInterval -= 20;
			else if (large_step == 2)	e2p->LastPumpCycle->AutoPumpTimeInterval -= 20;
			else if (large_step == 3)	e2p->LastPumpCycle->AutoPumpTimeInterval -= 20;

			if (e2p->LastPumpCycle->AutoPumpTimeInterval < 0) e2p->LastPumpCycle->AutoPumpTimeInterval = 1435;
			break;
		}

		// Увеличение значения интервала времени между включениями автоподкачки, мин
		case AutoPumpIntervalTimeInc:
		{
			if (large_step == 0)			e2p->LastPumpCycle->AutoPumpTimeInterval += 5;
			else if (large_step == 1)	e2p->LastPumpCycle->AutoPumpTimeInterval += 20;
			else if (large_step == 2)	e2p->LastPumpCycle->AutoPumpTimeInterval += 20;
			else if (large_step == 3)	e2p->LastPumpCycle->AutoPumpTimeInterval += 20;
			
			if (e2p->LastPumpCycle->AutoPumpTimeInterval > 1435) e2p->LastPumpCycle->AutoPumpTimeInterval = 0;
			break;
		}
		
		// Уменьшение объёма автоподкачки, литры *******************************************
		case AutoPumpVolumeDec:
		{
			if (large_step == 0)			e2p->LastPumpCycle->AutoPumpVolume -= 1;
			else if (large_step == 1)	e2p->LastPumpCycle->AutoPumpVolume -= 10;
			else if (large_step == 2)	e2p->LastPumpCycle->AutoPumpVolume -= 100;
			else if (large_step == 3)	e2p->LastPumpCycle->AutoPumpVolume -= 1000;

			if (e2p->LastPumpCycle->AutoPumpVolume < 0) e2p->LastPumpCycle->AutoPumpVolume = 100000;

			break;
		}

		// Увеличение объёма автоподкачки, литры
		case AutoPumpVolumeInc:
		{
			if (large_step == 0)			e2p->LastPumpCycle->AutoPumpVolume += 1;
			else if (large_step == 1)	e2p->LastPumpCycle->AutoPumpVolume += 10;
			else if (large_step == 2)	e2p->LastPumpCycle->AutoPumpVolume += 100;
			else if (large_step == 3)	e2p->LastPumpCycle->AutoPumpVolume += 1000;
			
			if (e2p->LastPumpCycle->AutoPumpVolume > 100000) e2p->LastPumpCycle->AutoPumpVolume = 0;
			
			break;			
		}

		// Уменьшение кол-ва включений автоподкачки за сутки***********************************
		case AutoPumpTimesDec:
		{
			if (large_step == 0)			e2p->LastPumpCycle->AutoPumpTimes -= 1;
			else if (large_step == 1)	e2p->LastPumpCycle->AutoPumpTimes -= 10;
			else if (large_step == 2)	e2p->LastPumpCycle->AutoPumpTimes -= 10;
			else if (large_step == 3)	e2p->LastPumpCycle->AutoPumpTimes -= 10;

			if (e2p->LastPumpCycle->AutoPumpTimes < 0) e2p->LastPumpCycle->AutoPumpTimes = 100;

			break;
		}

		// Увеличение кол-ва включений автоподкачки за сутки
		case AutoPumpTimesInc:
		{
			if (large_step == 0)			e2p->LastPumpCycle->AutoPumpTimes += 1;
			else if (large_step == 1)	e2p->LastPumpCycle->AutoPumpTimes += 10;
			else if (large_step == 2)	e2p->LastPumpCycle->AutoPumpTimes += 10;
			else if (large_step == 3)	e2p->LastPumpCycle->AutoPumpTimes += 10;
			
			if (e2p->LastPumpCycle->AutoPumpTimes > 100) e2p->LastPumpCycle->AutoPumpTimes = 0;
			
			break;			
		}
		

		// Уменьшение значения текущего времени *****************************************
		case CurrentTimeDecrement:
		{
			// Обновление счётчика времени в секундах
			sysState->TimeInSeconds = time_temp;
			if (large_step == 0)			sysState->TimeInSeconds -= 60;
			else if (large_step == 1)	sysState->TimeInSeconds -= 600;
			else if (large_step == 2)	sysState->TimeInSeconds -= 600;
			else if (large_step == 3)	sysState->TimeInSeconds -= 600;

			// Обнуление секунд во время настройки времени
			sysState->TimeInSeconds -= (sysState->TimeInSeconds % 60);
			
			if (sysState->TimeInSeconds < 0) sysState->TimeInSeconds = 86399;
			// Установка времени
			Write_time_to_RTC(hrtc, sysState->TimeInSeconds);
			break;
		}

		// Увеличение значения текущего времени
		case CurrentTimeIncrement:
		{
			// Обновление счётчика времени в секундах
			sysState->TimeInSeconds = time_temp;
			if (large_step == 0)			sysState->TimeInSeconds += 60;
			else if (large_step == 1)	sysState->TimeInSeconds += 600;
			else if (large_step == 2)	sysState->TimeInSeconds += 600;
			else if (large_step == 3)	sysState->TimeInSeconds += 600;

			// Обнуление секунд во время настройки времени
			sysState->TimeInSeconds -= (sysState->TimeInSeconds % 60);
			
			if (sysState->TimeInSeconds > 86399) sysState->TimeInSeconds = 0;
			// Установка времени
			Write_time_to_RTC(hrtc, sysState->TimeInSeconds);
			break;
		}
	
		// Уменьшение значения коррекции текущего времени *******************************
		case TimeCorrectionValueDec:
		{
			e2p->Calibrations->TimeCorrectionValue -= 1;

			if (e2p->Calibrations->TimeCorrectionValue < -7) e2p->Calibrations->TimeCorrectionValue = -7;
			break;
		}

		// Увеличение значения коррекции текущего времени
		case TimeCorrectionValueInc:
		{
			e2p->Calibrations->TimeCorrectionValue += 1;

			if (e2p->Calibrations->TimeCorrectionValue > 7) e2p->Calibrations->TimeCorrectionValue = 7;
			break;
		}
	
		// Уменьшение минимальной точки источника воды *******************************
		case VoltageForPminSourceDec:
		{
			e2p->Calibrations->SourcePsensorMinPressureVoltage -= 1;

			if (e2p->Calibrations->SourcePsensorMinPressureVoltage < 0) e2p->Calibrations->SourcePsensorMinPressureVoltage = 0;
			break;
		}

		// Увеличение минимальной точки источника воды
		case VoltageForPminSourceInc:
		{
			e2p->Calibrations->SourcePsensorMinPressureVoltage += 1;

			if (e2p->Calibrations->SourcePsensorMinPressureVoltage > SOURCE_PRESSURE_MAX_VALUE)
			{
				e2p->Calibrations->SourcePsensorMinPressureVoltage = SOURCE_PRESSURE_MAX_VALUE;
			}
			break;
		}
	
		// Уменьшение максимальной точки источника воды *******************************
		case VoltageForPmaxSourceDec:
		{
			e2p->Calibrations->SourcePsensorMaxPressureVoltage -= 1;

			if (e2p->Calibrations->SourcePsensorMaxPressureVoltage < 0) e2p->Calibrations->SourcePsensorMaxPressureVoltage = 0;
			break;
		}

		// Увеличение максимальной точки источника воды
		case VoltageForPmaxSourceInc:
		{
			e2p->Calibrations->SourcePsensorMaxPressureVoltage += 1;

			if (e2p->Calibrations->SourcePsensorMaxPressureVoltage > SOURCE_PRESSURE_MAX_VALUE)
			{
				e2p->Calibrations->SourcePsensorMaxPressureVoltage = SOURCE_PRESSURE_MAX_VALUE;
			}
			break;
		}

		// Уменьшение минимальной точки накопителя воды *******************************
		case VoltageForPminTankDec:
		{
			e2p->Calibrations->TankPsensorMinPressureVoltage -= 1;

			if (e2p->Calibrations->TankPsensorMinPressureVoltage < 0) e2p->Calibrations->TankPsensorMinPressureVoltage = 0;
			break;
		}

		// Увеличение минимальной точки накопителя воды
		case VoltageForPminTankInc:
		{
			e2p->Calibrations->TankPsensorMinPressureVoltage += 1;

			if (e2p->Calibrations->TankPsensorMinPressureVoltage > DEST_PRESSURE_MAX_VALUE)
			{
				e2p->Calibrations->TankPsensorMinPressureVoltage = DEST_PRESSURE_MAX_VALUE;
			}
			break;
		}

		// Уменьшение максимальной точки накопителя воды *******************************
		case VoltageForPmaxTankDec:
		{
			e2p->Calibrations->TankPsensorMaxPressureVoltage -= 1;

			if (e2p->Calibrations->TankPsensorMaxPressureVoltage < 0) e2p->Calibrations->TankPsensorMaxPressureVoltage = 0;
			break;
		}

		// Увеличение максимальной точки накопителя воды
		case VoltageForPmaxTankInc:
		{
			e2p->Calibrations->TankPsensorMaxPressureVoltage += 1;

			if (e2p->Calibrations->TankPsensorMaxPressureVoltage > DEST_PRESSURE_MAX_VALUE)
			{
				e2p->Calibrations->TankPsensorMaxPressureVoltage = DEST_PRESSURE_MAX_VALUE;
			}
			break;
		}

		// Установка минимальной точки источника воды по текущему значению напряжения датч. давления****
		case SetVoltageForPminSource:
		{
			// Треб. преобр в %
			e2p->Calibrations->SourcePsensorMinPressureVoltage = sysState->WellWaterLevelInVolts;

			if (e2p->Calibrations->SourcePsensorMinPressureVoltage < 0) e2p->Calibrations->SourcePsensorMinPressureVoltage = 0;
			break;
		}
		// Установка максимальной точки источника воды по текущему значению напряжения датч. давления
		case SetVoltageForPmaxSource:
		{
			// Треб. преобр в %
			e2p->Calibrations->SourcePsensorMaxPressureVoltage = sysState->WellWaterLevelInVolts;

			if (e2p->Calibrations->SourcePsensorMaxPressureVoltage > 100) e2p->Calibrations->SourcePsensorMaxPressureVoltage = 100;
			break;
		}

		// Установка минимальной точки накопителя воды по текущему значению напряжения датч. давления****
		case SetVoltageForPminTank:
		{
			// Треб. преобр в %
			e2p->Calibrations->TankPsensorMinPressureVoltage = sysState->TankWaterLevelInVolts;

			if (e2p->Calibrations->TankPsensorMinPressureVoltage < 0) e2p->Calibrations->TankPsensorMinPressureVoltage = 0;
			break;
		}
		// Установка максимальной точки накопителя воды по текущему значению напряжения датч. давления
		case SetVoltageForPmaxTank:
		{
			// Треб. преобр в %
			e2p->Calibrations->TankPsensorMaxPressureVoltage = sysState->TankWaterLevelInVolts;

			if (e2p->Calibrations->TankPsensorMaxPressureVoltage > 100) e2p->Calibrations->TankPsensorMaxPressureVoltage = 100;
			break;
		}

		// Экран 0
		case Screen0:
		{
			nextion.ScreenNumber = 0;
			break;
		}
		// Экран 1
		case Screen1:
		{
			nextion.ScreenNumber = 1;
			break;
		}
		// Экран 2
		case Screen2:
		{
			nextion.ScreenNumber = 2;
			break;
		}
		// Экран 3
		case Screen3:
		{
			nextion.ScreenNumber = 3;
			break;
		}
		// Экран 4
		case Screen4:
		{
			nextion.ScreenNumber = 4;
			break;
		}
		// Экран 5
		case Screen5:
		{
			nextion.ScreenNumber = 5;
			break;
		}
		// Экран 6
		case Screen6:
		{
			nextion.ScreenNumber = 6;
			break;
		}
		// Экран 7
		case Screen7:
		{
			nextion.ScreenNumber = 7;
			break;
		}
		// Экран 8
		case Screen8:
		{
			nextion.ScreenNumber = 8;
			break;
		}
		// Экран 9
		case Screen9:
		{
			nextion.ScreenNumber = 9;
			break;
		}

		// Вкл. реж. полива при повышенном давлении с огранич. по врем., объёму
		case WateringModeOn:
		{
			if (source_value == key_is_pressed) {
				// Если не активен какой-либо режим работы
				if(*sysState->pumpCurrState == IdleMode) {
					// Обнуление счётчиков значений последнего цикла
					e2p->LastPumpCycle->PumpWorkingTimeAtLastCycle = 0;
					e2p->LastPumpCycle->WaterPumpedAtLastCycle = 0;
					
					// Начальная установка счётчиков полива
					e2p->LastPumpCycle->WateringTimer = 0;
					e2p->LastPumpCycle->WateringVolumeCounter = 0;
				}
					
				// Если установлено давление защитного отключения для  режима полива
				if(e2p->Calibrations->WateringPumpOffPressure) {
					// Если установлен объём для полива,
					if((e2p->Calibrations->WateringVolume) ||
						 // либо установлена продолжительность полива
						 (e2p->Calibrations->WateringTime)) {
						// Включ. режима  полива
						sysState->pumpCtrlComms->SwitchPumpOn = 1;
						*sysState->pumpCurrState = WateringMode;
					}
				}
			}

			break;
		}
		// Выкл. реж. полива при повышенном давлении с огранич. по врем., объёму
		case WateringModeOff:
		{
			if (source_value == key_is_pressed) {
					// Обнуление счётчиков полива
					e2p->LastPumpCycle->WateringTimer = 0;
					e2p->LastPumpCycle->WateringVolumeCounter = 0;
				
				// Если в режиме прогрева УФ лампы, индицируем
				if(*sysState->uvLampState == uvLampPreheating) {
					*sysState->uvLampState = uvLampBlinkWhilePreheating;
				}
			
				// Если не в режиме прогрева УФ лампы
				if((*sysState->uvLampState != uvLampPreheating) &&
					 (*sysState->uvLampState != uvLampBlinkWhilePreheating)) {
					// Выключить режим  полива
					sysState->pumpCtrlComms->SwitchPumpOff = 1;
				}
					 
				// Если кнопка выкл. была нажата при активном событии "сухого хода", то
				if (sysState->DryRunProtectiveStop)
				{
					// сброс события "сухого хода"
					sysState->DryRunProtectiveStop = 0;
					
					// Возобновление автоподкачки, если была прервана "сухим ходом"
					if (*sysState->pumpCurrState == AutoPumpingMode)
					{
						// Отключение автоподкачки
						//e2p->LastPumpCycle->auto_pump_is_done = 0;
						
						// Включаем насос
						sysState->pumpCtrlComms->SwitchPumpOn = 1;
						sysState->pumpCtrlComms->SwitchPumpOff = 0;
					}
				}
				// Если событие "сухой ход" неактивно, то
				else
				{
					// Если кнопка выкл. была нажата при штатной работе автоподкачки, то
					if (*sysState->pumpCurrState == AutoPumpingMode)
					{
						// Разрешение повторной попытки автоподкачки воды
						*sysState->pumpCurrState = IdleMode;						
					}
				}
			}

			break;
		}

		// Увеличение объёма полива в реж. полива с огранич. по врем., объёму
		case WateringVolumeInc:
		{
			if (large_step == 0)			e2p->Calibrations->WateringVolume += 10;
			else if (large_step == 1)	e2p->Calibrations->WateringVolume += 10;
			else if (large_step == 2)	e2p->Calibrations->WateringVolume += 10;
			else if (large_step == 3)	e2p->Calibrations->WateringVolume += 100;
			if (e2p->Calibrations->WateringVolume > 30000) e2p->Calibrations->WateringVolume = 0;		
			break;
		}
		// Уменьшение объёма полива в реж. полива с огранич. по врем., объёму
		case WateringVolumeDec:
		{
			if (large_step == 0)			e2p->Calibrations->WateringVolume -= 10;
			else if (large_step == 1)	e2p->Calibrations->WateringVolume -= 10;
			else if (large_step == 2)	e2p->Calibrations->WateringVolume -= 10;
			else if (large_step == 3)	e2p->Calibrations->WateringVolume -= 100;
			if (e2p->Calibrations->WateringVolume < 0) e2p->Calibrations->WateringVolume = 30000;				
			break;
		}

		// Увеличение времени полива в реж. полива с огранич. по врем., объёму
		case WateringTimeInc:
		{
			if (large_step == 0)			e2p->Calibrations->WateringTime += 60;
			else if (large_step == 1)	e2p->Calibrations->WateringTime += 60;
			else if (large_step == 2)	e2p->Calibrations->WateringTime += 600;
			else if (large_step == 3)	e2p->Calibrations->WateringTime += 600;		
			if (e2p->Calibrations->WateringTime > 36000) e2p->Calibrations->WateringTime = 0;			
			break;
		}
		// Уменьшение времени полива в реж. полива с огранич. по врем., объёму
		case WateringTimeDec:
		{
			if (large_step == 0)			e2p->Calibrations->WateringTime -= 60;
			else if (large_step == 1)	e2p->Calibrations->WateringTime -= 60;
			else if (large_step == 2)	e2p->Calibrations->WateringTime -= 600;
			else if (large_step == 3)	e2p->Calibrations->WateringTime -= 600;		
			if (e2p->Calibrations->WateringTime < 0) e2p->Calibrations->WateringTime = 36000;	
			break;
		}

		// Увеличение давления отключения насоса в реж. полива с огранич. по врем., объёму
		case WateringPumpOffPressureInc:
		{
			if (large_step == 0)			e2p->Calibrations->WateringPumpOffPressure += 1;
			else if (large_step == 1)	e2p->Calibrations->WateringPumpOffPressure += 1;
			else if (large_step == 2)	e2p->Calibrations->WateringPumpOffPressure += 1;
			else if (large_step == 3)	e2p->Calibrations->WateringPumpOffPressure += 10;	
			if (e2p->Calibrations->WateringPumpOffPressure > PRESSURE_MAX_VALUE)
				e2p->Calibrations->WateringPumpOffPressure = PRESSURE_MAX_VALUE;
			break;
		}
		// Уменьшение давления отключения насоса в реж. полива с огранич. по врем., объёму
		case WateringPumpOffPressureDec:
		{
			if (large_step == 0)			e2p->Calibrations->WateringPumpOffPressure -= 1;
			else if (large_step == 1)	e2p->Calibrations->WateringPumpOffPressure -= 1;
			else if (large_step == 2)	e2p->Calibrations->WateringPumpOffPressure -= 1;
			else if (large_step == 3)	e2p->Calibrations->WateringPumpOffPressure -= 10;				
			if (e2p->Calibrations->WateringPumpOffPressure < 0)
				e2p->Calibrations->WateringPumpOffPressure = 0;			
			break;
		}
		
		// Увеличение кол-ва счётных импульсов на 1 литр при учёте перекачиваемой жидкости
		case ImpulsesPerOneLiterInc:
		{
			if (large_step == 0)			e2p->Calibrations->TurbineImpulsesPerLiter += 1;
			else if (large_step == 1)	e2p->Calibrations->TurbineImpulsesPerLiter += 10;
			else if (large_step == 2)	e2p->Calibrations->TurbineImpulsesPerLiter += 10;
			else if (large_step == 3)	e2p->Calibrations->TurbineImpulsesPerLiter += 100;
			if (e2p->Calibrations->TurbineImpulsesPerLiter > 10000) e2p->Calibrations->TurbineImpulsesPerLiter = 0;				
			break;
		}
		// Уменьшение кол-ва счётных импульсов на 1 литр при учёте перекачиваемой жидкости
		case ImpulsesPerOneLiterDec:
		{
			if (large_step == 0)			e2p->Calibrations->TurbineImpulsesPerLiter -= 1;
			else if (large_step == 1)	e2p->Calibrations->TurbineImpulsesPerLiter -= 10;
			else if (large_step == 2)	e2p->Calibrations->TurbineImpulsesPerLiter -= 10;
			else if (large_step == 3)	e2p->Calibrations->TurbineImpulsesPerLiter -= 100;
			if (e2p->Calibrations->TurbineImpulsesPerLiter < 0) e2p->Calibrations->TurbineImpulsesPerLiter = 10000;				
			break;
		}
		
		// Увеличение кол-ва литров на 1 счётный импульс при учёте перекачиваемой жидкости
		case LitersPerOneImpulseInc:
		{
			if (large_step == 0)			e2p->Calibrations->WaterCounterLitersPerImpulse += 1;
			else if (large_step == 1)	e2p->Calibrations->WaterCounterLitersPerImpulse += 10;
			else if (large_step == 2)	e2p->Calibrations->WaterCounterLitersPerImpulse += 10;
			else if (large_step == 3)	e2p->Calibrations->WaterCounterLitersPerImpulse += 100;
			if (e2p->Calibrations->WaterCounterLitersPerImpulse > 10000) e2p->Calibrations->WaterCounterLitersPerImpulse = 0;				
			break;
		}
		// Уменьшение кол-ва литров на 1 счётный импульс при учёте перекачиваемой жидкости
		case LitersPerOneImpulseDec:
		{
			if (large_step == 0)			e2p->Calibrations->WaterCounterLitersPerImpulse -= 1;
			else if (large_step == 1)	e2p->Calibrations->WaterCounterLitersPerImpulse -= 10;
			else if (large_step == 2)	e2p->Calibrations->WaterCounterLitersPerImpulse -= 10;
			else if (large_step == 3)	e2p->Calibrations->WaterCounterLitersPerImpulse -= 100;
			if (e2p->Calibrations->WaterCounterLitersPerImpulse < 0) e2p->Calibrations->WaterCounterLitersPerImpulse = 10000;				
			break;
		}
		
		// Сброс счётчиков УФ лампы
		case ResetUVLampCounters:
		{
			e2p->Statistics->UvLampWorkingTime = 0;
			e2p->Statistics->UvLampPowerOnCycleCounter = 0;

			break;
		}		
		
		// Сброс всех настроек
		case ResetAllSettingsToDefault:
		{
			Set_all_variables_to_default(e2p);

			break;
		}
	}
}


// Проверка длины, подсчет к.с. стандартной строки NMEA0183
uint8_t Nmea_string_check_checksum(uint8_t * buf, uint16_t lenght)
{
	const uint8_t string_termination_is_absent=0xFD;
	const uint8_t checksum_error=0xFE;
	const uint8_t no_errors=0x00;
	uint8_t temp,msb,lsb,idx;
	uint8_t rx_buffer_checksum=0; 

	// Проверка на наличие в конце принятой строки терминатора строки 
	idx=(lenght-2);
	if (buf[idx++] != 0x0D)
	{
		return string_termination_is_absent;
	}
	if (buf[idx++] != 0x0A)
	{
		return string_termination_is_absent;
	}

	// Проверка контр. суммы
	for (idx=1;idx<(lenght-5);idx++)
	{
		rx_buffer_checksum^=buf[idx];
	}
	// сверяем с принятым значением
	idx=lenght-4;    
	msb=buf[idx++];
	lsb=buf[idx];
	temp=ASCII2HEX(msb,lsb);
	if (rx_buffer_checksum != temp)
	{
		return checksum_error;
	}

	return no_errors;
}

		
// Подсчет к.с. буфера и запись в передаваемую строку
void Set_string_binary_checksum(uint8_t  * buf, uint16_t lenght)
{
	uint8_t 	idx,buffer_checksum=0;

	// xor-им всё между $ и *
	for (idx=1;idx<(lenght-4);idx++)
	{
		buffer_checksum^=buf[idx];
	}

	idx=lenght-3;
	buf[idx++] = buffer_checksum;
}


// Adding triple 0xFF at the end of the command as command termination and pushing to ring buffer for sending
ReturnCode_t Add_termination_to_nextion_command_and_push_to_ring_buf(NextionComPort_t * nextion)
{
	ReturnCode_t func_res;
	uint32_t size;

	// Checking buffer boundary
	if((nextion->Com->TxdIdx8 + 3) > NEXTION_COM_TXD_BUF_SIZE_IN_BYTES)
	{
		return StringLengthExceedsBufferSize;
	}
	
	nextion->TxdBuffer[nextion->Com->TxdIdx8++] = 0xFF;
	nextion->TxdBuffer[nextion->Com->TxdIdx8++] = 0xFF;
	nextion->TxdBuffer[nextion->Com->TxdIdx8++] = 0xFF;
	
	// Setting string lenght for sending as whole unit
	nextion->Com->TxdPacketLenght8 = nextion->Com->TxdIdx8;
	
	// Pushing data string to ring data buffer
	if((func_res = Push_string_to_ring_buffer(nextion->ComRingBuf, nextion->TxdBuffer, nextion->Com->TxdPacketLenght8)))
	{
		return func_res;
	}		
	
	return OK;
}


// Отрисовка на Nextion текущего значения параметров
ReturnCode_t Prepare_params_and_send_to_nextion(RTC_HandleTypeDef  * hrtc, E2p_t * e2p, NextionComPort_t * nextion, CurrentSystemState_t * sysState)
{
	ReturnCode_t					func_res;
	HAL_StatusTypeDef			HAL_func_res;
	uint8_t								ascii_buf[5];
	int32_t								temp_int32;
	int32_t 							time_temp;
	
	// Preventing corruption of sending data
	//if(nextion->Com->TxdPacketIsSent == 0) return;
	
	// Яркость дисплея
	nextion->Com->TxdIdx8 = 0;
	nextion->TxdBuffer[nextion->Com->TxdIdx8++] = 'd';
	nextion->TxdBuffer[nextion->Com->TxdIdx8++] = 'i';
	nextion->TxdBuffer[nextion->Com->TxdIdx8++] = 'm';
	nextion->TxdBuffer[nextion->Com->TxdIdx8++] = '=';
	// Яркость дисплея
	Hex2Dec2ASCII((uint16_t) (display_brightness / DISPLAY_BRIGHTNESS_OFF_SPEED), ascii_buf, sizeof(ascii_buf));	
	nextion->TxdBuffer[nextion->Com->TxdIdx8++] = ascii_buf[2];
	nextion->TxdBuffer[nextion->Com->TxdIdx8++] = ascii_buf[1];
	nextion->TxdBuffer[nextion->Com->TxdIdx8++] = ascii_buf[0];	
	// Терминатор команды + отправка в кольцевой буфер на передачу
	if((func_res = Add_termination_to_nextion_command_and_push_to_ring_buf(nextion))) return func_res;

	// Чтение текущего времени
	time_temp = Get_time_in_sec(hrtc);

	switch(nextion->ScreenNumber)
	{
		// Страница 0 (Главный экран)
		case 0:
		{
			// Давление воды в системе, атм * 10
			nextion->Com->TxdIdx8 = 0;
			nextion->TxdBuffer[nextion->Com->TxdIdx8++] = 'x';
			nextion->TxdBuffer[nextion->Com->TxdIdx8++] = '0';
			nextion->TxdBuffer[nextion->Com->TxdIdx8++] = '.';
			nextion->TxdBuffer[nextion->Com->TxdIdx8++] = 'v';
			nextion->TxdBuffer[nextion->Com->TxdIdx8++] = 'a';
			nextion->TxdBuffer[nextion->Com->TxdIdx8++] = 'l';
			nextion->TxdBuffer[nextion->Com->TxdIdx8++] = '=';
			Hex2Dec2ASCII((uint16_t) sysState->AverageWaterPressure, ascii_buf, sizeof(ascii_buf));
			nextion->TxdBuffer[nextion->Com->TxdIdx8++] = ascii_buf[2];
			nextion->TxdBuffer[nextion->Com->TxdIdx8++] = ascii_buf[1];
			nextion->TxdBuffer[nextion->Com->TxdIdx8++] = ascii_buf[0];
			// Терминатор команды + отправка в кольцевой буфер на передачу
			if((func_res = Add_termination_to_nextion_command_and_push_to_ring_buf(nextion))) return func_res;

			uint32_t restOfTime = (PUMP_ON_AFTER_UV_LAMP_ON_DELAY - (HAL_GetTick() - uv_lamp_preheating_on_time)) / 1000;		
			// Время работы насоса в последнем цикле, час
			nextion->Com->TxdIdx8 = 0;
			nextion->TxdBuffer[nextion->Com->TxdIdx8++] = 'n';
			nextion->TxdBuffer[nextion->Com->TxdIdx8++] = '4';
			nextion->TxdBuffer[nextion->Com->TxdIdx8++] = '.';
			nextion->TxdBuffer[nextion->Com->TxdIdx8++] = 'v';
			nextion->TxdBuffer[nextion->Com->TxdIdx8++] = 'a';
			nextion->TxdBuffer[nextion->Com->TxdIdx8++] = 'l';
			nextion->TxdBuffer[nextion->Com->TxdIdx8++] = '=';
			if((*sysState->uvLampState != uvLampIsOff) && (sysState->PumpIsStarted == 0)) {
				Hex2Dec2ASCII((uint16_t) (restOfTime / 3600), ascii_buf, sizeof(ascii_buf));
			} else {
				Hex2Dec2ASCII((uint16_t) (e2p->LastPumpCycle->PumpWorkingTimeAtLastCycle / 3600), ascii_buf, sizeof(ascii_buf));
			}
			nextion->TxdBuffer[nextion->Com->TxdIdx8++] = ascii_buf[1];
			nextion->TxdBuffer[nextion->Com->TxdIdx8++] = ascii_buf[0];
			// Терминатор команды + отправка в кольцевой буфер на передачу
			if((func_res = Add_termination_to_nextion_command_and_push_to_ring_buf(nextion))) return func_res;
		
			// Время работы насоса в последнем цикле, мин
			nextion->Com->TxdIdx8 = 0;
			nextion->TxdBuffer[nextion->Com->TxdIdx8++] = 'n';
			nextion->TxdBuffer[nextion->Com->TxdIdx8++] = '5';
			nextion->TxdBuffer[nextion->Com->TxdIdx8++] = '.';
			nextion->TxdBuffer[nextion->Com->TxdIdx8++] = 'v';
			nextion->TxdBuffer[nextion->Com->TxdIdx8++] = 'a';
			nextion->TxdBuffer[nextion->Com->TxdIdx8++] = 'l';
			nextion->TxdBuffer[nextion->Com->TxdIdx8++] = '=';
			if((*sysState->uvLampState != uvLampIsOff) && (sysState->PumpIsStarted == 0)) {
				Hex2Dec2ASCII((uint16_t) ((restOfTime % 3600) / 60), ascii_buf, sizeof(ascii_buf));
			} else {
			Hex2Dec2ASCII((uint16_t) ((e2p->LastPumpCycle->PumpWorkingTimeAtLastCycle % 3600) / 60), ascii_buf, sizeof(ascii_buf));	
			}
			nextion->TxdBuffer[nextion->Com->TxdIdx8++] = ascii_buf[1];
			nextion->TxdBuffer[nextion->Com->TxdIdx8++] = ascii_buf[0];
			// Терминатор команды + отправка в кольцевой буфер на передачу
			if((func_res = Add_termination_to_nextion_command_and_push_to_ring_buf(nextion))) return func_res;

			// Время работы насоса в последнем цикле, сек
			nextion->Com->TxdIdx8 = 0;
			nextion->TxdBuffer[nextion->Com->TxdIdx8++] = 'n';
			nextion->TxdBuffer[nextion->Com->TxdIdx8++] = '6';
			nextion->TxdBuffer[nextion->Com->TxdIdx8++] = '.';
			nextion->TxdBuffer[nextion->Com->TxdIdx8++] = 'v';
			nextion->TxdBuffer[nextion->Com->TxdIdx8++] = 'a';
			nextion->TxdBuffer[nextion->Com->TxdIdx8++] = 'l';
			nextion->TxdBuffer[nextion->Com->TxdIdx8++] = '=';
			if((*sysState->uvLampState != uvLampIsOff) && (sysState->PumpIsStarted == 0)) {
				Hex2Dec2ASCII((uint16_t) ((restOfTime % 3600) % 60), ascii_buf, sizeof(ascii_buf));
			} else {
			Hex2Dec2ASCII((uint16_t) ((e2p->LastPumpCycle->PumpWorkingTimeAtLastCycle % 3600) % 60), ascii_buf, sizeof(ascii_buf));	
			}
			nextion->TxdBuffer[nextion->Com->TxdIdx8++] = ascii_buf[1];
			nextion->TxdBuffer[nextion->Com->TxdIdx8++] = ascii_buf[0];
			// Терминатор команды + отправка в кольцевой буфер на передачу
			if((func_res = Add_termination_to_nextion_command_and_push_to_ring_buf(nextion))) return func_res;
				

			// Кол-во воды, перекачанной в последнем цикле
			nextion->Com->TxdIdx8 = 0;
			nextion->TxdBuffer[nextion->Com->TxdIdx8++] = 'x';
			nextion->TxdBuffer[nextion->Com->TxdIdx8++] = '1';
			nextion->TxdBuffer[nextion->Com->TxdIdx8++] = '.';
			nextion->TxdBuffer[nextion->Com->TxdIdx8++] = 'v';
			nextion->TxdBuffer[nextion->Com->TxdIdx8++] = 'a';
			nextion->TxdBuffer[nextion->Com->TxdIdx8++] = 'l';
			nextion->TxdBuffer[nextion->Com->TxdIdx8++] = '=';
			// Кол-во воды, перекачанной насосом в последнем цикле, л (старшие 3 разряда)
			Hex2Dec2ASCII((uint16_t) (e2p->LastPumpCycle->WaterPumpedAtLastCycle / 1000), ascii_buf, sizeof(ascii_buf));	
			nextion->TxdBuffer[nextion->Com->TxdIdx8++] = ascii_buf[2];
			nextion->TxdBuffer[nextion->Com->TxdIdx8++] = ascii_buf[1];
			nextion->TxdBuffer[nextion->Com->TxdIdx8++] = ascii_buf[0];
			// Кол-во воды, перекачанной насосом в последнем цикле, л (младшие 3 разряда)
			Hex2Dec2ASCII((uint16_t) (e2p->LastPumpCycle->WaterPumpedAtLastCycle % 1000), ascii_buf, sizeof(ascii_buf));	
			nextion->TxdBuffer[nextion->Com->TxdIdx8++] = ascii_buf[2];
			nextion->TxdBuffer[nextion->Com->TxdIdx8++] = ascii_buf[1];
			nextion->TxdBuffer[nextion->Com->TxdIdx8++] = ascii_buf[0];
			// Терминатор команды + отправка в кольцевой буфер на передачу
			if((func_res = Add_termination_to_nextion_command_and_push_to_ring_buf(nextion))) return func_res;


			// t воды при перекач
			nextion->Com->TxdIdx8 = 0;
			nextion->TxdBuffer[nextion->Com->TxdIdx8++] = 'x';
			nextion->TxdBuffer[nextion->Com->TxdIdx8++] = '2';
			nextion->TxdBuffer[nextion->Com->TxdIdx8++] = '.';
			nextion->TxdBuffer[nextion->Com->TxdIdx8++] = 'v';
			nextion->TxdBuffer[nextion->Com->TxdIdx8++] = 'a';
			nextion->TxdBuffer[nextion->Com->TxdIdx8++] = 'l';
			nextion->TxdBuffer[nextion->Com->TxdIdx8++] = '=';
			// t воды при перекачивании, 'С * 10
			Hex2Dec2ASCII((uint16_t) (fabs((float) e2p->LastPumpCycle->WaterTempDuringPumping)), ascii_buf, sizeof(ascii_buf));	
			nextion->TxdBuffer[nextion->Com->TxdIdx8++] = ascii_buf[2];
			nextion->TxdBuffer[nextion->Com->TxdIdx8++] = ascii_buf[1];
			nextion->TxdBuffer[nextion->Com->TxdIdx8++] = ascii_buf[0];	
			// Терминатор команды + отправка в кольцевой буфер на передачу
			if((func_res = Add_termination_to_nextion_command_and_push_to_ring_buf(nextion))) return func_res;


			// Текущ. t воды
			nextion->Com->TxdIdx8 = 0;	
			nextion->TxdBuffer[nextion->Com->TxdIdx8++] = 'x';
			nextion->TxdBuffer[nextion->Com->TxdIdx8++] = '3';
			nextion->TxdBuffer[nextion->Com->TxdIdx8++] = '.';
			nextion->TxdBuffer[nextion->Com->TxdIdx8++] = 'v';
			nextion->TxdBuffer[nextion->Com->TxdIdx8++] = 'a';
			nextion->TxdBuffer[nextion->Com->TxdIdx8++] = 'l';
			nextion->TxdBuffer[nextion->Com->TxdIdx8++] = '=';
			// текущая t воды, 'С * 10
			Hex2Dec2ASCII((uint16_t) (fabs((float) sysState->CurrentWaterTemp)), ascii_buf, sizeof(ascii_buf));	
			nextion->TxdBuffer[nextion->Com->TxdIdx8++] = ascii_buf[2];
			nextion->TxdBuffer[nextion->Com->TxdIdx8++] = ascii_buf[1];
			nextion->TxdBuffer[nextion->Com->TxdIdx8++] = ascii_buf[0];
			// Терминатор команды + отправка в кольцевой буфер на передачу
			if((func_res = Add_termination_to_nextion_command_and_push_to_ring_buf(nextion))) return func_res;
			

			// Текущее время, часы
			nextion->Com->TxdIdx8 = 0;
			nextion->TxdBuffer[nextion->Com->TxdIdx8++] = 'n';
			nextion->TxdBuffer[nextion->Com->TxdIdx8++] = '1';
			nextion->TxdBuffer[nextion->Com->TxdIdx8++] = '.';
			nextion->TxdBuffer[nextion->Com->TxdIdx8++] = 'v';
			nextion->TxdBuffer[nextion->Com->TxdIdx8++] = 'a';
			nextion->TxdBuffer[nextion->Com->TxdIdx8++] = 'l';
			nextion->TxdBuffer[nextion->Com->TxdIdx8++] = '=';
			// Обновление счётчика времени в секундах
			sysState->TimeInSeconds = time_temp;
			// Текущее время, часы
			Hex2Dec2ASCII((uint16_t) (sysState->TimeInSeconds / 3600), ascii_buf, sizeof(ascii_buf));	
			nextion->TxdBuffer[nextion->Com->TxdIdx8++] = ascii_buf[1];
			nextion->TxdBuffer[nextion->Com->TxdIdx8++] = ascii_buf[0];
			// Терминатор команды + отправка в кольцевой буфер на передачу
			if((func_res = Add_termination_to_nextion_command_and_push_to_ring_buf(nextion))) return func_res;

			// Текущее время, минуты
			nextion->Com->TxdIdx8 = 0;
			nextion->TxdBuffer[nextion->Com->TxdIdx8++] = 'n';
			nextion->TxdBuffer[nextion->Com->TxdIdx8++] = '2';
			nextion->TxdBuffer[nextion->Com->TxdIdx8++] = '.';
			nextion->TxdBuffer[nextion->Com->TxdIdx8++] = 'v';
			nextion->TxdBuffer[nextion->Com->TxdIdx8++] = 'a';
			nextion->TxdBuffer[nextion->Com->TxdIdx8++] = 'l';
			nextion->TxdBuffer[nextion->Com->TxdIdx8++] = '=';
			// Текущее время, минуты
			Hex2Dec2ASCII((uint16_t) ((sysState->TimeInSeconds % 3600) / 60), ascii_buf, sizeof(ascii_buf));	
			nextion->TxdBuffer[nextion->Com->TxdIdx8++] = ascii_buf[1];
			nextion->TxdBuffer[nextion->Com->TxdIdx8++] = ascii_buf[0];
			// Терминатор команды + отправка в кольцевой буфер на передачу
			if((func_res = Add_termination_to_nextion_command_and_push_to_ring_buf(nextion))) return func_res;

			// Текущее время, секунды
			nextion->Com->TxdIdx8 = 0;
			nextion->TxdBuffer[nextion->Com->TxdIdx8++] = 'n';
			nextion->TxdBuffer[nextion->Com->TxdIdx8++] = '3';
			nextion->TxdBuffer[nextion->Com->TxdIdx8++] = '.';
			nextion->TxdBuffer[nextion->Com->TxdIdx8++] = 'v';
			nextion->TxdBuffer[nextion->Com->TxdIdx8++] = 'a';
			nextion->TxdBuffer[nextion->Com->TxdIdx8++] = 'l';
			nextion->TxdBuffer[nextion->Com->TxdIdx8++] = '=';
			// Текущее время, секунды
			Hex2Dec2ASCII((uint16_t) ((sysState->TimeInSeconds % 3600) % 60), ascii_buf, sizeof(ascii_buf));	
			nextion->TxdBuffer[nextion->Com->TxdIdx8++] = ascii_buf[1];
			nextion->TxdBuffer[nextion->Com->TxdIdx8++] = ascii_buf[0];
			// Терминатор команды + отправка в кольцевой буфер на передачу
			if((func_res = Add_termination_to_nextion_command_and_push_to_ring_buf(nextion))) return func_res;


			// t воды в источнике, 'С
			nextion->Com->TxdIdx8 = 0;
			nextion->TxdBuffer[nextion->Com->TxdIdx8++] = 'x';
			nextion->TxdBuffer[nextion->Com->TxdIdx8++] = '4';
			nextion->TxdBuffer[nextion->Com->TxdIdx8++] = '.';
			nextion->TxdBuffer[nextion->Com->TxdIdx8++] = 'v';
			nextion->TxdBuffer[nextion->Com->TxdIdx8++] = 'a';
			nextion->TxdBuffer[nextion->Com->TxdIdx8++] = 'l';
			nextion->TxdBuffer[nextion->Com->TxdIdx8++] = '=';
			// t воды в источнике, 'С
			Hex2Dec2ASCII((uint16_t) (fabs((float) sysState->WellWaterTemp)), ascii_buf, sizeof(ascii_buf));	
			nextion->TxdBuffer[nextion->Com->TxdIdx8++] = ascii_buf[2];
			nextion->TxdBuffer[nextion->Com->TxdIdx8++] = ascii_buf[1];
			nextion->TxdBuffer[nextion->Com->TxdIdx8++] = ascii_buf[0];
			// Терминатор команды + отправка в кольцевой буфер на передачу
			if((func_res = Add_termination_to_nextion_command_and_push_to_ring_buf(nextion))) return func_res;

			// Уровень воды в источнике, %
			nextion->Com->TxdIdx8 = 0;
			nextion->TxdBuffer[nextion->Com->TxdIdx8++] = 'x';
			nextion->TxdBuffer[nextion->Com->TxdIdx8++] = '6';
			nextion->TxdBuffer[nextion->Com->TxdIdx8++] = '.';
			nextion->TxdBuffer[nextion->Com->TxdIdx8++] = 'v';
			nextion->TxdBuffer[nextion->Com->TxdIdx8++] = 'a';
			nextion->TxdBuffer[nextion->Com->TxdIdx8++] = 'l';
			nextion->TxdBuffer[nextion->Com->TxdIdx8++] = '=';
			// Объём воды в источнике, проценты
			Hex2Dec2ASCII((uint16_t) sysState->WellWaterLevelInVolts, ascii_buf, sizeof(ascii_buf));	
			nextion->TxdBuffer[nextion->Com->TxdIdx8++] = ascii_buf[2];
			nextion->TxdBuffer[nextion->Com->TxdIdx8++] = ascii_buf[1];
			nextion->TxdBuffer[nextion->Com->TxdIdx8++] = ascii_buf[0];
			// Терминатор команды + отправка в кольцевой буфер на передачу
			if((func_res = Add_termination_to_nextion_command_and_push_to_ring_buf(nextion))) return func_res;

			// Графический уровень воды в источнике, %
			nextion->Com->TxdIdx8 = 0;
			nextion->TxdBuffer[nextion->Com->TxdIdx8++] = 'j';
			nextion->TxdBuffer[nextion->Com->TxdIdx8++] = '0';
			nextion->TxdBuffer[nextion->Com->TxdIdx8++] = '.';
			nextion->TxdBuffer[nextion->Com->TxdIdx8++] = 'v';
			nextion->TxdBuffer[nextion->Com->TxdIdx8++] = 'a';
			nextion->TxdBuffer[nextion->Com->TxdIdx8++] = 'l';
			nextion->TxdBuffer[nextion->Com->TxdIdx8++] = '=';
			// Графический уровень воды в источнике, проценты
			nextion->TxdBuffer[nextion->Com->TxdIdx8++] = ascii_buf[2];
			nextion->TxdBuffer[nextion->Com->TxdIdx8++] = ascii_buf[1];
			nextion->TxdBuffer[nextion->Com->TxdIdx8++] = ascii_buf[0];
			// Терминатор команды + отправка в кольцевой буфер на передачу
			if((func_res = Add_termination_to_nextion_command_and_push_to_ring_buf(nextion))) return func_res;


			// t воды в накопителе, 'С
			nextion->Com->TxdIdx8 = 0;
			nextion->TxdBuffer[nextion->Com->TxdIdx8++] = 'x';
			nextion->TxdBuffer[nextion->Com->TxdIdx8++] = '5';
			nextion->TxdBuffer[nextion->Com->TxdIdx8++] = '.';
			nextion->TxdBuffer[nextion->Com->TxdIdx8++] = 'v';
			nextion->TxdBuffer[nextion->Com->TxdIdx8++] = 'a';
			nextion->TxdBuffer[nextion->Com->TxdIdx8++] = 'l';
			nextion->TxdBuffer[nextion->Com->TxdIdx8++] = '=';
			// t воды в накопителе, 'С
			Hex2Dec2ASCII((uint16_t) (fabs((float) sysState->TankWaterTemp)), ascii_buf, sizeof(ascii_buf));	
			nextion->TxdBuffer[nextion->Com->TxdIdx8++] = ascii_buf[2];
			nextion->TxdBuffer[nextion->Com->TxdIdx8++] = ascii_buf[1];
			nextion->TxdBuffer[nextion->Com->TxdIdx8++] = ascii_buf[0];
			// Терминатор команды + отправка в кольцевой буфер на передачу
			if((func_res = Add_termination_to_nextion_command_and_push_to_ring_buf(nextion))) return func_res;

			// Уровень воды в накопителе, %
			nextion->Com->TxdIdx8 = 0;
			nextion->TxdBuffer[nextion->Com->TxdIdx8++] = 'x';
			nextion->TxdBuffer[nextion->Com->TxdIdx8++] = '7';
			nextion->TxdBuffer[nextion->Com->TxdIdx8++] = '.';
			nextion->TxdBuffer[nextion->Com->TxdIdx8++] = 'v';
			nextion->TxdBuffer[nextion->Com->TxdIdx8++] = 'a';
			nextion->TxdBuffer[nextion->Com->TxdIdx8++] = 'l';
			nextion->TxdBuffer[nextion->Com->TxdIdx8++] = '=';
			// Объём воды в накопителе, проценты
			Hex2Dec2ASCII((uint16_t) sysState->TankWaterLevelInVolts, ascii_buf, sizeof(ascii_buf));	
			nextion->TxdBuffer[nextion->Com->TxdIdx8++] = ascii_buf[2];
			nextion->TxdBuffer[nextion->Com->TxdIdx8++] = ascii_buf[1];
			nextion->TxdBuffer[nextion->Com->TxdIdx8++] = ascii_buf[0];
			// Терминатор команды + отправка в кольцевой буфер на передачу
			if((func_res = Add_termination_to_nextion_command_and_push_to_ring_buf(nextion))) return func_res;

			// Графический уровень воды в накопителе, %
			nextion->Com->TxdIdx8 = 0;
			nextion->TxdBuffer[nextion->Com->TxdIdx8++] = 'j';
			nextion->TxdBuffer[nextion->Com->TxdIdx8++] = '1';
			nextion->TxdBuffer[nextion->Com->TxdIdx8++] = '.';
			nextion->TxdBuffer[nextion->Com->TxdIdx8++] = 'v';
			nextion->TxdBuffer[nextion->Com->TxdIdx8++] = 'a';
			nextion->TxdBuffer[nextion->Com->TxdIdx8++] = 'l';
			nextion->TxdBuffer[nextion->Com->TxdIdx8++] = '=';
			// Графический уровень воды в накопителе, проценты
			nextion->TxdBuffer[nextion->Com->TxdIdx8++] = ascii_buf[2];
			nextion->TxdBuffer[nextion->Com->TxdIdx8++] = ascii_buf[1];
			nextion->TxdBuffer[nextion->Com->TxdIdx8++] = ascii_buf[0];
			// Терминатор команды + отправка в кольцевой буфер на передачу
			if((func_res = Add_termination_to_nextion_command_and_push_to_ring_buf(nextion))) return func_res;

			// Скрытие/отрисовка сообщения "сухой ход"
			nextion->Com->TxdIdx8 = 0;
			nextion->TxdBuffer[nextion->Com->TxdIdx8++] = 't';
			nextion->TxdBuffer[nextion->Com->TxdIdx8++] = '9';
			nextion->TxdBuffer[nextion->Com->TxdIdx8++] = '.';
			nextion->TxdBuffer[nextion->Com->TxdIdx8++] = 'p';
			nextion->TxdBuffer[nextion->Com->TxdIdx8++] = 'c';
			nextion->TxdBuffer[nextion->Com->TxdIdx8++] = 'o';
			nextion->TxdBuffer[nextion->Com->TxdIdx8++] = '=';
			// Скрытие/отрисовка сообщения "сухой ход"
			if (sysState->DryRunProtectiveStop)
			{
				// Отрисовка сообщения "сухой ход"
				nextion->TxdBuffer[nextion->Com->TxdIdx8++] = '6';
				nextion->TxdBuffer[nextion->Com->TxdIdx8++] = '3';
				nextion->TxdBuffer[nextion->Com->TxdIdx8++] = '5';
				nextion->TxdBuffer[nextion->Com->TxdIdx8++] = '5';
				nextion->TxdBuffer[nextion->Com->TxdIdx8++] = '6';
			}
			else
			{
				// Скрытие сообщения "сухой ход"
				nextion->TxdBuffer[nextion->Com->TxdIdx8++] = '0';
				nextion->TxdBuffer[nextion->Com->TxdIdx8++] = '0';
				nextion->TxdBuffer[nextion->Com->TxdIdx8++] = '0';
				nextion->TxdBuffer[nextion->Com->TxdIdx8++] = '0';
				nextion->TxdBuffer[nextion->Com->TxdIdx8++] = '0';
			}
			// Терминатор команды + отправка в кольцевой буфер на передачу
			if((func_res = Add_termination_to_nextion_command_and_push_to_ring_buf(nextion))) return func_res;

			
			// Скрытие/отрисовка сообщения "Автополив"
			nextion->Com->TxdIdx8 = 0;
			nextion->TxdBuffer[nextion->Com->TxdIdx8++] = 't';
			nextion->TxdBuffer[nextion->Com->TxdIdx8++] = '1';
			nextion->TxdBuffer[nextion->Com->TxdIdx8++] = '7';
			nextion->TxdBuffer[nextion->Com->TxdIdx8++] = '.';
			nextion->TxdBuffer[nextion->Com->TxdIdx8++] = 'p';
			nextion->TxdBuffer[nextion->Com->TxdIdx8++] = 'c';
			nextion->TxdBuffer[nextion->Com->TxdIdx8++] = 'o';
			nextion->TxdBuffer[nextion->Com->TxdIdx8++] = '=';
			// Скрытие/отрисовка сообщения "Автополив"
			if (sysState->AutoWatering)
			{
				// Отрисовка сообщения "Автополив"
				nextion->TxdBuffer[nextion->Com->TxdIdx8++] = '3';
				nextion->TxdBuffer[nextion->Com->TxdIdx8++] = '4';
				nextion->TxdBuffer[nextion->Com->TxdIdx8++] = '7';
				nextion->TxdBuffer[nextion->Com->TxdIdx8++] = '8';
				nextion->TxdBuffer[nextion->Com->TxdIdx8++] = '4';
			}
			else
			{
				// Скрытие сообщения "Автополив"
				nextion->TxdBuffer[nextion->Com->TxdIdx8++] = '0';
				nextion->TxdBuffer[nextion->Com->TxdIdx8++] = '0';
				nextion->TxdBuffer[nextion->Com->TxdIdx8++] = '0';
				nextion->TxdBuffer[nextion->Com->TxdIdx8++] = '0';
				nextion->TxdBuffer[nextion->Com->TxdIdx8++] = '0';
			}
			// Терминатор команды + отправка в кольцевой буфер на передачу
			if((func_res = Add_termination_to_nextion_command_and_push_to_ring_buf(nextion))) return func_res;

			// Скрытие/отрисовка сообщения "Автоподкачка"
			nextion->Com->TxdIdx8 = 0;
			nextion->TxdBuffer[nextion->Com->TxdIdx8++] = 't';
			nextion->TxdBuffer[nextion->Com->TxdIdx8++] = '1';
			nextion->TxdBuffer[nextion->Com->TxdIdx8++] = '8';
			nextion->TxdBuffer[nextion->Com->TxdIdx8++] = '.';
			nextion->TxdBuffer[nextion->Com->TxdIdx8++] = 'p';
			nextion->TxdBuffer[nextion->Com->TxdIdx8++] = 'c';
			nextion->TxdBuffer[nextion->Com->TxdIdx8++] = 'o';
			nextion->TxdBuffer[nextion->Com->TxdIdx8++] = '=';
			// Скрытие/отрисовка сообщения "Автоподкачка"
			if (*sysState->pumpCurrState == AutoPumpingMode)
			{
				// Отрисовка сообщения "Автоподкачка"
				nextion->TxdBuffer[nextion->Com->TxdIdx8++] = '1';
				nextion->TxdBuffer[nextion->Com->TxdIdx8++] = '3';
				nextion->TxdBuffer[nextion->Com->TxdIdx8++] = '6';
				nextion->TxdBuffer[nextion->Com->TxdIdx8++] = '2';
				nextion->TxdBuffer[nextion->Com->TxdIdx8++] = '9';
			}
			else
			{
				// Скрытие сообщения "Автоподкачка"
				nextion->TxdBuffer[nextion->Com->TxdIdx8++] = '0';
				nextion->TxdBuffer[nextion->Com->TxdIdx8++] = '0';
				nextion->TxdBuffer[nextion->Com->TxdIdx8++] = '0';
				nextion->TxdBuffer[nextion->Com->TxdIdx8++] = '0';
				nextion->TxdBuffer[nextion->Com->TxdIdx8++] = '0';
			}
			// Терминатор команды + отправка в кольцевой буфер на передачу
			if((func_res = Add_termination_to_nextion_command_and_push_to_ring_buf(nextion))) return func_res;
			
			// Скрытие/отрисовка сообщения "Полив"
			nextion->Com->TxdIdx8 = 0;
			nextion->TxdBuffer[nextion->Com->TxdIdx8++] = 't';
			nextion->TxdBuffer[nextion->Com->TxdIdx8++] = '2';
			nextion->TxdBuffer[nextion->Com->TxdIdx8++] = '3';
			nextion->TxdBuffer[nextion->Com->TxdIdx8++] = '.';
			nextion->TxdBuffer[nextion->Com->TxdIdx8++] = 'p';
			nextion->TxdBuffer[nextion->Com->TxdIdx8++] = 'c';
			nextion->TxdBuffer[nextion->Com->TxdIdx8++] = 'o';
			nextion->TxdBuffer[nextion->Com->TxdIdx8++] = '=';
			// Скрытие/отрисовка сообщения "Полив"
			if (*sysState->pumpCurrState == WateringMode)
			{
				// Отрисовка сообщения "Полив"
				nextion->TxdBuffer[nextion->Com->TxdIdx8++] = '3';
				nextion->TxdBuffer[nextion->Com->TxdIdx8++] = '4';
				nextion->TxdBuffer[nextion->Com->TxdIdx8++] = '7';
				nextion->TxdBuffer[nextion->Com->TxdIdx8++] = '8';
				nextion->TxdBuffer[nextion->Com->TxdIdx8++] = '4';
			}
			else
			{
				// Скрытие сообщения "Полив"
				nextion->TxdBuffer[nextion->Com->TxdIdx8++] = '0';
				nextion->TxdBuffer[nextion->Com->TxdIdx8++] = '0';
				nextion->TxdBuffer[nextion->Com->TxdIdx8++] = '0';
				nextion->TxdBuffer[nextion->Com->TxdIdx8++] = '0';
				nextion->TxdBuffer[nextion->Com->TxdIdx8++] = '0';
			}
			// Терминатор команды + отправка в кольцевой буфер на передачу
			if((func_res = Add_termination_to_nextion_command_and_push_to_ring_buf(nextion))) return func_res;

			// изменение цвета кнопки включения насоса
			nextion->Com->TxdIdx8 = 0;
			nextion->TxdBuffer[nextion->Com->TxdIdx8++] = 'b';
			nextion->TxdBuffer[nextion->Com->TxdIdx8++] = '0';
			nextion->TxdBuffer[nextion->Com->TxdIdx8++] = '.';
			nextion->TxdBuffer[nextion->Com->TxdIdx8++] = 'b';
			nextion->TxdBuffer[nextion->Com->TxdIdx8++] = 'c';
			nextion->TxdBuffer[nextion->Com->TxdIdx8++] = 'o';
			nextion->TxdBuffer[nextion->Com->TxdIdx8++] = '=';
			if(*sysState->pumpCurrState != WateringMode)
			{
				// Если УФ лампа включена на прогрев, то кнопка вкл. насоса имеет фиолетовый цвет
				if (*sysState->uvLampState == uvLampPreheating)
				{
					nextion->TxdBuffer[nextion->Com->TxdIdx8++] = '2';
					nextion->TxdBuffer[nextion->Com->TxdIdx8++] = '4';
					nextion->TxdBuffer[nextion->Com->TxdIdx8++] = '5';
					nextion->TxdBuffer[nextion->Com->TxdIdx8++] = '8';
					nextion->TxdBuffer[nextion->Com->TxdIdx8++] = '9';
				}
				// Если УФ лампа включена на прогрев и есть попытка отключения, то подсвечиваем кнопку вкл. насоса
				else if (*sysState->uvLampState == uvLampBlinkWhilePreheating)
				{
					nextion->TxdBuffer[nextion->Com->TxdIdx8++] = '3';
					nextion->TxdBuffer[nextion->Com->TxdIdx8++] = '9';
					nextion->TxdBuffer[nextion->Com->TxdIdx8++] = '4';
					nextion->TxdBuffer[nextion->Com->TxdIdx8++] = '5';
					nextion->TxdBuffer[nextion->Com->TxdIdx8++] = '5';
					
					*sysState->uvLampState = uvLampPreheating;
				}
				// Если насос включен, то кнопка вкл. насоса имеет салатовый цвет
				else if (sysState->PumpIsStarted)
				{
					nextion->TxdBuffer[nextion->Com->TxdIdx8++] = '3';
					nextion->TxdBuffer[nextion->Com->TxdIdx8++] = '4';
					nextion->TxdBuffer[nextion->Com->TxdIdx8++] = '7';
					nextion->TxdBuffer[nextion->Com->TxdIdx8++] = '8';
					nextion->TxdBuffer[nextion->Com->TxdIdx8++] = '4';
				}
				else
				{
					// Если насос выключен, то кнопка вкл. насоса имеет оранжевый цвет
					nextion->TxdBuffer[nextion->Com->TxdIdx8++] = '6';
					nextion->TxdBuffer[nextion->Com->TxdIdx8++] = '4';
					nextion->TxdBuffer[nextion->Com->TxdIdx8++] = '5';
					nextion->TxdBuffer[nextion->Com->TxdIdx8++] = '1';
					nextion->TxdBuffer[nextion->Com->TxdIdx8++] = '2';
				}
			}
			// Терминатор команды + отправка в кольцевой буфер на передачу
			if((func_res = Add_termination_to_nextion_command_and_push_to_ring_buf(nextion))) return func_res;
			

			// Время включения насоса в последнем цикле, час
			nextion->Com->TxdIdx8 = 0;
			nextion->TxdBuffer[nextion->Com->TxdIdx8++] = 'n';
			nextion->TxdBuffer[nextion->Com->TxdIdx8++] = '7';
			nextion->TxdBuffer[nextion->Com->TxdIdx8++] = '.';
			nextion->TxdBuffer[nextion->Com->TxdIdx8++] = 'v';
			nextion->TxdBuffer[nextion->Com->TxdIdx8++] = 'a';
			nextion->TxdBuffer[nextion->Com->TxdIdx8++] = 'l';
			nextion->TxdBuffer[nextion->Com->TxdIdx8++] = '=';
			// Время включения насоса в последнем цикле, час
			Hex2Dec2ASCII((uint16_t) (e2p->LastPumpCycle->PumpStartTimeAtLastCycle / 3600), ascii_buf, sizeof(ascii_buf));	
			nextion->TxdBuffer[nextion->Com->TxdIdx8++] = ascii_buf[1];
			nextion->TxdBuffer[nextion->Com->TxdIdx8++] = ascii_buf[0];
			// Терминатор команды + отправка в кольцевой буфер на передачу
			if((func_res = Add_termination_to_nextion_command_and_push_to_ring_buf(nextion))) return func_res;
				
			// Время включения насоса в последнем цикле, мин
			nextion->Com->TxdIdx8 = 0;
			nextion->TxdBuffer[nextion->Com->TxdIdx8++] = 'n';
			nextion->TxdBuffer[nextion->Com->TxdIdx8++] = '8';
			nextion->TxdBuffer[nextion->Com->TxdIdx8++] = '.';
			nextion->TxdBuffer[nextion->Com->TxdIdx8++] = 'v';
			nextion->TxdBuffer[nextion->Com->TxdIdx8++] = 'a';
			nextion->TxdBuffer[nextion->Com->TxdIdx8++] = 'l';
			nextion->TxdBuffer[nextion->Com->TxdIdx8++] = '=';
			// Время включения насоса в последнем цикле, мин
			Hex2Dec2ASCII((uint16_t) ((e2p->LastPumpCycle->PumpStartTimeAtLastCycle % 3600) / 60), ascii_buf, sizeof(ascii_buf));	
			nextion->TxdBuffer[nextion->Com->TxdIdx8++] = ascii_buf[1];
			nextion->TxdBuffer[nextion->Com->TxdIdx8++] = ascii_buf[0];
			// Терминатор команды + отправка в кольцевой буфер на передачу
			if((func_res = Add_termination_to_nextion_command_and_push_to_ring_buf(nextion))) return func_res;

			// Время включения насоса в последнем цикле, сек
			nextion->Com->TxdIdx8 = 0;
			nextion->TxdBuffer[nextion->Com->TxdIdx8++] = 'n';
			nextion->TxdBuffer[nextion->Com->TxdIdx8++] = '9';
			nextion->TxdBuffer[nextion->Com->TxdIdx8++] = '.';
			nextion->TxdBuffer[nextion->Com->TxdIdx8++] = 'v';
			nextion->TxdBuffer[nextion->Com->TxdIdx8++] = 'a';
			nextion->TxdBuffer[nextion->Com->TxdIdx8++] = 'l';
			nextion->TxdBuffer[nextion->Com->TxdIdx8++] = '=';
			// Время включения насоса в последнем цикле, сек
			Hex2Dec2ASCII((uint16_t) ((e2p->LastPumpCycle->PumpStartTimeAtLastCycle % 3600) % 60), ascii_buf, sizeof(ascii_buf));	
			nextion->TxdBuffer[nextion->Com->TxdIdx8++] = ascii_buf[1];
			nextion->TxdBuffer[nextion->Com->TxdIdx8++] = ascii_buf[0];
			// Терминатор команды + отправка в кольцевой буфер на передачу
			if((func_res = Add_termination_to_nextion_command_and_push_to_ring_buf(nextion))) return func_res;

			break;
		}

		// Страница 1 (настройки насоса)
		case 1:
		{
			// P вкл. насоса, атм * 10
			nextion->Com->TxdIdx8 = 0;
			nextion->TxdBuffer[nextion->Com->TxdIdx8++] = 'x';
			nextion->TxdBuffer[nextion->Com->TxdIdx8++] = '1';
			nextion->TxdBuffer[nextion->Com->TxdIdx8++] = '0';
			nextion->TxdBuffer[nextion->Com->TxdIdx8++] = '2';
			nextion->TxdBuffer[nextion->Com->TxdIdx8++] = '.';
			nextion->TxdBuffer[nextion->Com->TxdIdx8++] = 'v';
			nextion->TxdBuffer[nextion->Com->TxdIdx8++] = 'a';
			nextion->TxdBuffer[nextion->Com->TxdIdx8++] = 'l';
			nextion->TxdBuffer[nextion->Com->TxdIdx8++] = '=';
			// Давление включения насоса, атм * 10
			Hex2Dec2ASCII((uint16_t) e2p->Calibrations->PumpOnPressure, ascii_buf, sizeof(ascii_buf));	
			nextion->TxdBuffer[nextion->Com->TxdIdx8++] = ascii_buf[2];
			nextion->TxdBuffer[nextion->Com->TxdIdx8++] = ascii_buf[1];
			nextion->TxdBuffer[nextion->Com->TxdIdx8++] = ascii_buf[0];
			// Терминатор команды + отправка в кольцевой буфер на передачу
			if((func_res = Add_termination_to_nextion_command_and_push_to_ring_buf(nextion))) return func_res;

			// P выкл. насоса, атм * 10
			nextion->Com->TxdIdx8 = 0;
			nextion->TxdBuffer[nextion->Com->TxdIdx8++] = 'x';
			nextion->TxdBuffer[nextion->Com->TxdIdx8++] = '1';
			nextion->TxdBuffer[nextion->Com->TxdIdx8++] = '0';
			nextion->TxdBuffer[nextion->Com->TxdIdx8++] = '3';
			nextion->TxdBuffer[nextion->Com->TxdIdx8++] = '.';
			nextion->TxdBuffer[nextion->Com->TxdIdx8++] = 'v';
			nextion->TxdBuffer[nextion->Com->TxdIdx8++] = 'a';
			nextion->TxdBuffer[nextion->Com->TxdIdx8++] = 'l';
			nextion->TxdBuffer[nextion->Com->TxdIdx8++] = '=';
			// Давление выключения насоса, атм * 10
			Hex2Dec2ASCII((uint16_t) e2p->Calibrations->PumpOffPressure, ascii_buf, sizeof(ascii_buf));	
			nextion->TxdBuffer[nextion->Com->TxdIdx8++] = ascii_buf[2];
			nextion->TxdBuffer[nextion->Com->TxdIdx8++] = ascii_buf[1];
			nextion->TxdBuffer[nextion->Com->TxdIdx8++] = ascii_buf[0];	
			// Терминатор команды + отправка в кольцевой буфер на передачу
			if((func_res = Add_termination_to_nextion_command_and_push_to_ring_buf(nextion))) return func_res;


			// Калибровка датчика давления: P min, атм * 10
			nextion->Com->TxdIdx8 = 0;
			nextion->TxdBuffer[nextion->Com->TxdIdx8++] = 'x';
			nextion->TxdBuffer[nextion->Com->TxdIdx8++] = '1';
			nextion->TxdBuffer[nextion->Com->TxdIdx8++] = '0';
			nextion->TxdBuffer[nextion->Com->TxdIdx8++] = '0';
			nextion->TxdBuffer[nextion->Com->TxdIdx8++] = '.';
			nextion->TxdBuffer[nextion->Com->TxdIdx8++] = 'v';
			nextion->TxdBuffer[nextion->Com->TxdIdx8++] = 'a';
			nextion->TxdBuffer[nextion->Com->TxdIdx8++] = 'l';
			nextion->TxdBuffer[nextion->Com->TxdIdx8++] = '=';
			// Калибровка датчика давления: P min, атм * 10
			Hex2Dec2ASCII((uint16_t) e2p->Calibrations->PsensorMinPressure, ascii_buf, sizeof(ascii_buf));	
			nextion->TxdBuffer[nextion->Com->TxdIdx8++] = ascii_buf[2];
			nextion->TxdBuffer[nextion->Com->TxdIdx8++] = ascii_buf[1];
			nextion->TxdBuffer[nextion->Com->TxdIdx8++] = ascii_buf[0];
			// Терминатор команды + отправка в кольцевой буфер на передачу
			if((func_res = Add_termination_to_nextion_command_and_push_to_ring_buf(nextion))) return func_res;

			// Калибровка датчика давления: P max, атм * 10
			nextion->Com->TxdIdx8 = 0;
			nextion->TxdBuffer[nextion->Com->TxdIdx8++] = 'x';
			nextion->TxdBuffer[nextion->Com->TxdIdx8++] = '1';
			nextion->TxdBuffer[nextion->Com->TxdIdx8++] = '0';
			nextion->TxdBuffer[nextion->Com->TxdIdx8++] = '1';
			nextion->TxdBuffer[nextion->Com->TxdIdx8++] = '.';
			nextion->TxdBuffer[nextion->Com->TxdIdx8++] = 'v';
			nextion->TxdBuffer[nextion->Com->TxdIdx8++] = 'a';
			nextion->TxdBuffer[nextion->Com->TxdIdx8++] = 'l';
			nextion->TxdBuffer[nextion->Com->TxdIdx8++] = '=';
			// Калибровка датчика давления: P max, атм * 10
			Hex2Dec2ASCII((uint16_t) e2p->Calibrations->PsensorMaxPressure, ascii_buf, sizeof(ascii_buf));	
			nextion->TxdBuffer[nextion->Com->TxdIdx8++] = ascii_buf[2];
			nextion->TxdBuffer[nextion->Com->TxdIdx8++] = ascii_buf[1];
			nextion->TxdBuffer[nextion->Com->TxdIdx8++] = ascii_buf[0];	
			// Терминатор команды + отправка в кольцевой буфер на передачу
			if((func_res = Add_termination_to_nextion_command_and_push_to_ring_buf(nextion))) return func_res;

			// Калибровка датчика давления: P min = U min, мВ * 100
			nextion->Com->TxdIdx8 = 0;
			nextion->TxdBuffer[nextion->Com->TxdIdx8++] = 'x';
			nextion->TxdBuffer[nextion->Com->TxdIdx8++] = '1';
			nextion->TxdBuffer[nextion->Com->TxdIdx8++] = '0';
			nextion->TxdBuffer[nextion->Com->TxdIdx8++] = '4';
			nextion->TxdBuffer[nextion->Com->TxdIdx8++] = '.';
			nextion->TxdBuffer[nextion->Com->TxdIdx8++] = 'v';
			nextion->TxdBuffer[nextion->Com->TxdIdx8++] = 'a';
			nextion->TxdBuffer[nextion->Com->TxdIdx8++] = 'l';
			nextion->TxdBuffer[nextion->Com->TxdIdx8++] = '=';
			// Напряжение (0 - 5В), соотв. минимальному давлению датчика давления, мВ * 100
			Hex2Dec2ASCII((uint16_t) e2p->Calibrations->PsensorMinPressureVoltage, ascii_buf, sizeof(ascii_buf));	
			nextion->TxdBuffer[nextion->Com->TxdIdx8++] = ascii_buf[2];
			nextion->TxdBuffer[nextion->Com->TxdIdx8++] = ascii_buf[1];
			nextion->TxdBuffer[nextion->Com->TxdIdx8++] = ascii_buf[0];
			// Терминатор команды + отправка в кольцевой буфер на передачу
			if((func_res = Add_termination_to_nextion_command_and_push_to_ring_buf(nextion))) return func_res;

			// Калибровка датчика давления: P max = U max, мВ * 100
			nextion->Com->TxdIdx8 = 0;
			nextion->TxdBuffer[nextion->Com->TxdIdx8++] = 'x';
			nextion->TxdBuffer[nextion->Com->TxdIdx8++] = '1';
			nextion->TxdBuffer[nextion->Com->TxdIdx8++] = '0';
			nextion->TxdBuffer[nextion->Com->TxdIdx8++] = '5';
			nextion->TxdBuffer[nextion->Com->TxdIdx8++] = '.';
			nextion->TxdBuffer[nextion->Com->TxdIdx8++] = 'v';
			nextion->TxdBuffer[nextion->Com->TxdIdx8++] = 'a';
			nextion->TxdBuffer[nextion->Com->TxdIdx8++] = 'l';
			nextion->TxdBuffer[nextion->Com->TxdIdx8++] = '=';
			// Напряжение (0 - 5В), соотв. максимальному давлению датчика давления, мВ * 100
			Hex2Dec2ASCII((uint16_t) e2p->Calibrations->PsensorMaxPressureVoltage, ascii_buf, sizeof(ascii_buf));	
			nextion->TxdBuffer[nextion->Com->TxdIdx8++] = ascii_buf[2];
			nextion->TxdBuffer[nextion->Com->TxdIdx8++] = ascii_buf[1];
			nextion->TxdBuffer[nextion->Com->TxdIdx8++] = ascii_buf[0];
			// Терминатор команды + отправка в кольцевой буфер на передачу
			if((func_res = Add_termination_to_nextion_command_and_push_to_ring_buf(nextion))) return func_res;

			// Таймаут срабатывания останова насоса по "сухому ходу"
			nextion->Com->TxdIdx8 = 0;
			nextion->TxdBuffer[nextion->Com->TxdIdx8++] = 'x';
			nextion->TxdBuffer[nextion->Com->TxdIdx8++] = '1';
			nextion->TxdBuffer[nextion->Com->TxdIdx8++] = '0';
			nextion->TxdBuffer[nextion->Com->TxdIdx8++] = '6';
			nextion->TxdBuffer[nextion->Com->TxdIdx8++] = '.';
			nextion->TxdBuffer[nextion->Com->TxdIdx8++] = 'v';
			nextion->TxdBuffer[nextion->Com->TxdIdx8++] = 'a';
			nextion->TxdBuffer[nextion->Com->TxdIdx8++] = 'l';
			nextion->TxdBuffer[nextion->Com->TxdIdx8++] = '=';
			Hex2Dec2ASCII((uint16_t) e2p->LastPumpCycle->PumpDryRunStopTimeout, ascii_buf, sizeof(ascii_buf));	
			nextion->TxdBuffer[nextion->Com->TxdIdx8++] = ascii_buf[3];
			nextion->TxdBuffer[nextion->Com->TxdIdx8++] = ascii_buf[2];
			nextion->TxdBuffer[nextion->Com->TxdIdx8++] = ascii_buf[1];
			nextion->TxdBuffer[nextion->Com->TxdIdx8++] = ascii_buf[0];
			// Терминатор команды + отправка в кольцевой буфер на передачу
			if((func_res = Add_termination_to_nextion_command_and_push_to_ring_buf(nextion))) return func_res;

			break;
		}

		// Страница 2 (статистика)
		case 2:
		{
			// Общее время работы контроллера, часов.минут
			nextion->Com->TxdIdx8 = 0;
			nextion->TxdBuffer[nextion->Com->TxdIdx8++] = 'x';
			nextion->TxdBuffer[nextion->Com->TxdIdx8++] = '2';
			nextion->TxdBuffer[nextion->Com->TxdIdx8++] = '0';
			nextion->TxdBuffer[nextion->Com->TxdIdx8++] = '0';
			nextion->TxdBuffer[nextion->Com->TxdIdx8++] = '.';
			nextion->TxdBuffer[nextion->Com->TxdIdx8++] = 'v';
			nextion->TxdBuffer[nextion->Com->TxdIdx8++] = 'a';
			nextion->TxdBuffer[nextion->Com->TxdIdx8++] = 'l';
			nextion->TxdBuffer[nextion->Com->TxdIdx8++] = '=';
			// Общее время работы контроллера, часов (старшие 8-6 разряды)
			Hex2Dec2ASCII((uint16_t) ((e2p->Statistics->TotalControllerWorkingTime / 3600) / 1000), ascii_buf, sizeof(ascii_buf));	
			nextion->TxdBuffer[nextion->Com->TxdIdx8++] = ascii_buf[2];
			nextion->TxdBuffer[nextion->Com->TxdIdx8++] = ascii_buf[1];
			nextion->TxdBuffer[nextion->Com->TxdIdx8++] = ascii_buf[0];
			// Общее время работы контроллера, часов (средние 5-3 разряды)
			Hex2Dec2ASCII((uint16_t) (((e2p->Statistics->TotalControllerWorkingTime / 3600) % 10000) % 1000), ascii_buf, sizeof(ascii_buf));	
			nextion->TxdBuffer[nextion->Com->TxdIdx8++] = ascii_buf[2];
			nextion->TxdBuffer[nextion->Com->TxdIdx8++] = ascii_buf[1];
			nextion->TxdBuffer[nextion->Com->TxdIdx8++] = ascii_buf[0];
			// Общее время работы контроллера, минут (младшие 2-1 разряды)
			Hex2Dec2ASCII((uint16_t) ((e2p->Statistics->TotalControllerWorkingTime / 60) % 60), ascii_buf, sizeof(ascii_buf));	
			nextion->TxdBuffer[nextion->Com->TxdIdx8++] = ascii_buf[1];
			nextion->TxdBuffer[nextion->Com->TxdIdx8++] = ascii_buf[0];
			// Терминатор команды + отправка в кольцевой буфер на передачу
			if((func_res = Add_termination_to_nextion_command_and_push_to_ring_buf(nextion))) return func_res;


			// Общее время работы насоса, часов.минут
			nextion->Com->TxdIdx8 = 0;
			nextion->TxdBuffer[nextion->Com->TxdIdx8++] = 'x';
			nextion->TxdBuffer[nextion->Com->TxdIdx8++] = '2';
			nextion->TxdBuffer[nextion->Com->TxdIdx8++] = '0';
			nextion->TxdBuffer[nextion->Com->TxdIdx8++] = '1';
			nextion->TxdBuffer[nextion->Com->TxdIdx8++] = '.';
			nextion->TxdBuffer[nextion->Com->TxdIdx8++] = 'v';
			nextion->TxdBuffer[nextion->Com->TxdIdx8++] = 'a';
			nextion->TxdBuffer[nextion->Com->TxdIdx8++] = 'l';
			nextion->TxdBuffer[nextion->Com->TxdIdx8++] = '=';
			// Общее время работы насоса, часов (старшие 8-6 разряды)
			Hex2Dec2ASCII((uint16_t) ((e2p->Statistics->TotalPumpWorkingTime / 3600) / 1000), ascii_buf, sizeof(ascii_buf));	
			nextion->TxdBuffer[nextion->Com->TxdIdx8++] = ascii_buf[2];
			nextion->TxdBuffer[nextion->Com->TxdIdx8++] = ascii_buf[1];
			nextion->TxdBuffer[nextion->Com->TxdIdx8++] = ascii_buf[0];
			// Общее время работы насоса, часов (средние 5-3 разряды)
			Hex2Dec2ASCII((uint16_t) (((e2p->Statistics->TotalPumpWorkingTime / 3600) % 10000) % 1000), ascii_buf, sizeof(ascii_buf));	
			nextion->TxdBuffer[nextion->Com->TxdIdx8++] = ascii_buf[2];
			nextion->TxdBuffer[nextion->Com->TxdIdx8++] = ascii_buf[1];
			nextion->TxdBuffer[nextion->Com->TxdIdx8++] = ascii_buf[0];
			// Общее время работы контроллера, минут (младшие 2-1 разряды)
			Hex2Dec2ASCII((uint16_t) ((e2p->Statistics->TotalPumpWorkingTime / 60) % 60), ascii_buf, sizeof(ascii_buf));	
			nextion->TxdBuffer[nextion->Com->TxdIdx8++] = ascii_buf[1];
			nextion->TxdBuffer[nextion->Com->TxdIdx8++] = ascii_buf[0];
			// Терминатор команды + отправка в кольцевой буфер на передачу
			if((func_res = Add_termination_to_nextion_command_and_push_to_ring_buf(nextion))) return func_res;


			// Общее кол-во перекачанной насосом воды, литры
			nextion->Com->TxdIdx8 = 0;
			nextion->TxdBuffer[nextion->Com->TxdIdx8++] = 'x';
			nextion->TxdBuffer[nextion->Com->TxdIdx8++] = '2';
			nextion->TxdBuffer[nextion->Com->TxdIdx8++] = '0';
			nextion->TxdBuffer[nextion->Com->TxdIdx8++] = '2';
			nextion->TxdBuffer[nextion->Com->TxdIdx8++] = '.';
			nextion->TxdBuffer[nextion->Com->TxdIdx8++] = 'v';
			nextion->TxdBuffer[nextion->Com->TxdIdx8++] = 'a';
			nextion->TxdBuffer[nextion->Com->TxdIdx8++] = 'l';
			nextion->TxdBuffer[nextion->Com->TxdIdx8++] = '=';
			// Общее кол-во воды, перекачанной насосом, литры (старшие 5-8 разряды)
			Hex2Dec2ASCII((uint16_t) (e2p->Statistics->WaterPumpedTotal / 10000), ascii_buf, sizeof(ascii_buf));	
			nextion->TxdBuffer[nextion->Com->TxdIdx8++] = ascii_buf[3];
			nextion->TxdBuffer[nextion->Com->TxdIdx8++] = ascii_buf[2];
			nextion->TxdBuffer[nextion->Com->TxdIdx8++] = ascii_buf[1];
			nextion->TxdBuffer[nextion->Com->TxdIdx8++] = ascii_buf[0];
			// Общее кол-во воды, перекачанной насосом, литры  (младшие 1-4 разряды)
			Hex2Dec2ASCII((uint16_t) (e2p->Statistics->WaterPumpedTotal % 10000), ascii_buf, sizeof(ascii_buf));	
			nextion->TxdBuffer[nextion->Com->TxdIdx8++] = ascii_buf[3];
			nextion->TxdBuffer[nextion->Com->TxdIdx8++] = ascii_buf[2];
			nextion->TxdBuffer[nextion->Com->TxdIdx8++] = ascii_buf[1];
			nextion->TxdBuffer[nextion->Com->TxdIdx8++] = ascii_buf[0];
			// Терминатор команды + отправка в кольцевой буфер на передачу
			if((func_res = Add_termination_to_nextion_command_and_push_to_ring_buf(nextion))) return func_res;


			// Кол-во перекачанной воды за сутки, литры
			nextion->Com->TxdIdx8 = 0;
			nextion->TxdBuffer[nextion->Com->TxdIdx8++] = 'x';
			nextion->TxdBuffer[nextion->Com->TxdIdx8++] = '2';
			nextion->TxdBuffer[nextion->Com->TxdIdx8++] = '0';
			nextion->TxdBuffer[nextion->Com->TxdIdx8++] = '3';
			nextion->TxdBuffer[nextion->Com->TxdIdx8++] = '.';
			nextion->TxdBuffer[nextion->Com->TxdIdx8++] = 'v';
			nextion->TxdBuffer[nextion->Com->TxdIdx8++] = 'a';
			nextion->TxdBuffer[nextion->Com->TxdIdx8++] = 'l';
			nextion->TxdBuffer[nextion->Com->TxdIdx8++] = '=';		
			// Общее кол-во воды, перекачанной за сутки, литры (старшие 5-8 разряды)
			Hex2Dec2ASCII((uint16_t) (e2p->Statistics->PumpedWaterQuantityToday / 10000), ascii_buf, sizeof(ascii_buf));	
			nextion->TxdBuffer[nextion->Com->TxdIdx8++] = ascii_buf[3];
			nextion->TxdBuffer[nextion->Com->TxdIdx8++] = ascii_buf[2];
			nextion->TxdBuffer[nextion->Com->TxdIdx8++] = ascii_buf[1];
			nextion->TxdBuffer[nextion->Com->TxdIdx8++] = ascii_buf[0];
			// Общее кол-во воды, перекачанной за сутки, литры  (младшие 1-4 разряды)
			Hex2Dec2ASCII((uint16_t) (e2p->Statistics->PumpedWaterQuantityToday % 10000), ascii_buf, sizeof(ascii_buf));	
			nextion->TxdBuffer[nextion->Com->TxdIdx8++] = ascii_buf[3];
			nextion->TxdBuffer[nextion->Com->TxdIdx8++] = ascii_buf[2];
			nextion->TxdBuffer[nextion->Com->TxdIdx8++] = ascii_buf[1];
			nextion->TxdBuffer[nextion->Com->TxdIdx8++] = ascii_buf[0];
			// Терминатор команды + отправка в кольцевой буфер на передачу
			if((func_res = Add_termination_to_nextion_command_and_push_to_ring_buf(nextion))) return func_res;


			// Кол-во перекачанной воды за неделю, литры*10  (десятки литров)
			nextion->Com->TxdIdx8 = 0;
			nextion->TxdBuffer[nextion->Com->TxdIdx8++] = 'x';
			nextion->TxdBuffer[nextion->Com->TxdIdx8++] = '2';
			nextion->TxdBuffer[nextion->Com->TxdIdx8++] = '0';
			nextion->TxdBuffer[nextion->Com->TxdIdx8++] = '4';
			nextion->TxdBuffer[nextion->Com->TxdIdx8++] = '.';
			nextion->TxdBuffer[nextion->Com->TxdIdx8++] = 'v';
			nextion->TxdBuffer[nextion->Com->TxdIdx8++] = 'a';
			nextion->TxdBuffer[nextion->Com->TxdIdx8++] = 'l';
			nextion->TxdBuffer[nextion->Com->TxdIdx8++] = '=';	
			// Общее кол-во воды, перекачанной за неделю, литры (старшие 5-8 разряды)
			Hex2Dec2ASCII((uint16_t) (e2p->Statistics->PumpedWaterQuantityLastWeek / 10000), ascii_buf, sizeof(ascii_buf));	
			nextion->TxdBuffer[nextion->Com->TxdIdx8++] = ascii_buf[3];
			nextion->TxdBuffer[nextion->Com->TxdIdx8++] = ascii_buf[2];
			nextion->TxdBuffer[nextion->Com->TxdIdx8++] = ascii_buf[1];
			nextion->TxdBuffer[nextion->Com->TxdIdx8++] = ascii_buf[0];
			// Общее кол-во воды, перекачанной за неделю, литры  (младшие 1-4 разряды)
			Hex2Dec2ASCII((uint16_t) (e2p->Statistics->PumpedWaterQuantityLastWeek % 10000), ascii_buf, sizeof(ascii_buf));	
			nextion->TxdBuffer[nextion->Com->TxdIdx8++] = ascii_buf[3];
			nextion->TxdBuffer[nextion->Com->TxdIdx8++] = ascii_buf[2];
			nextion->TxdBuffer[nextion->Com->TxdIdx8++] = ascii_buf[1];
			nextion->TxdBuffer[nextion->Com->TxdIdx8++] = ascii_buf[0];
			// Терминатор команды + отправка в кольцевой буфер на передачу
			if((func_res = Add_termination_to_nextion_command_and_push_to_ring_buf(nextion))) return func_res;


			// Общее время работы УФ лампы, часов.минут
			nextion->Com->TxdIdx8 = 0;
			nextion->TxdBuffer[nextion->Com->TxdIdx8++] = 'x';
			nextion->TxdBuffer[nextion->Com->TxdIdx8++] = '2';
			nextion->TxdBuffer[nextion->Com->TxdIdx8++] = '0';
			nextion->TxdBuffer[nextion->Com->TxdIdx8++] = '5';
			nextion->TxdBuffer[nextion->Com->TxdIdx8++] = '.';
			nextion->TxdBuffer[nextion->Com->TxdIdx8++] = 'v';
			nextion->TxdBuffer[nextion->Com->TxdIdx8++] = 'a';
			nextion->TxdBuffer[nextion->Com->TxdIdx8++] = 'l';
			nextion->TxdBuffer[nextion->Com->TxdIdx8++] = '=';
			// Общее время работы УФ лампы, часов (старшие 8-6 разряды)
			Hex2Dec2ASCII((uint16_t) ((e2p->Statistics->UvLampWorkingTime / 3600) / 1000), ascii_buf, sizeof(ascii_buf));	
			nextion->TxdBuffer[nextion->Com->TxdIdx8++] = ascii_buf[2];
			nextion->TxdBuffer[nextion->Com->TxdIdx8++] = ascii_buf[1];
			nextion->TxdBuffer[nextion->Com->TxdIdx8++] = ascii_buf[0];
			// Общее время работы УФ лампы, часов (средние 5-3 разряды)
			Hex2Dec2ASCII((uint16_t) (((e2p->Statistics->UvLampWorkingTime / 3600) % 10000) % 1000), ascii_buf, sizeof(ascii_buf));	
			nextion->TxdBuffer[nextion->Com->TxdIdx8++] = ascii_buf[2];
			nextion->TxdBuffer[nextion->Com->TxdIdx8++] = ascii_buf[1];
			nextion->TxdBuffer[nextion->Com->TxdIdx8++] = ascii_buf[0];
			// Общее время работы УФ лампы, минут (младшие 2-1 разряды)
			Hex2Dec2ASCII((uint16_t) ((e2p->Statistics->UvLampWorkingTime / 60) % 60), ascii_buf, sizeof(ascii_buf));	
			nextion->TxdBuffer[nextion->Com->TxdIdx8++] = ascii_buf[1];
			nextion->TxdBuffer[nextion->Com->TxdIdx8++] = ascii_buf[0];
			// Терминатор команды + отправка в кольцевой буфер на передачу
			if((func_res = Add_termination_to_nextion_command_and_push_to_ring_buf(nextion))) return func_res;
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
