peterriv/WaterSupplyController/FW/Core/Inc/config.h

#ifndef			_CONFIG_H
#define 		_CONFIG_H

#include "main.h"
// backup.c строка 532 (temp16 = Get_day_number(hrtc)) - проверить!

// Nextion display communication port selection
#define NEXTION_DISPLAY_COM_PORT									COM2

#define JETSON_COM_PORT														COM1
#define EXTERNAL_INTERFACE_COM_PORT								COM3

// Запись калибровочного коэффициента для коррекции хода часов реального времени ( сек/месяц)
// при подобранном к. деления = 32762, при котором часы только начинают опережать (>32762 часы отстают), за сутки опережение на 4 сек при корр. =0
// 32 = 31 ppm = -79 сек/мес (-0.5c/сут); 36 = 34 ppm = -89 сек/мес (-1c/сут); 24 = 23 ppm = -59 сек/мес (+2c/сут); 48 = 46 ppm = -119 сек/мес (-4c/сут)
// 30 = 29 ppm = -74 сек/мес (-2c/сут); // 26 - за 4 суток +5 сек
#define	RTC_TIME_CALIBRATION_COEFF								27

// Вид представления данных часов реального времени (двоичн / двоичн. - десятичн.)
#define	RTC_FORMAT																RTC_FORMAT_BIN


// Максимальный размер страницы в EEPROM для разовой записи, байт
#define	E2P_PAGE_MAX_SIZE													512

// Размер страницы в EEPROM для разовой записи, байт
#define	E2P_PAGE_SIZE															256

// Кол-во термодатчиков 1-Wire на одной шине
#define	ONE_WIRE_TERMO_SENSORS_QUANTITY						1

// Период опроса термодатчиков 1-Wire, SysTicks
#define	TERMO_SENSORS_POLL_PERIOD									1000

// Коэффициент для перевода бар в атмосферы
#define	BAR_TO_ATM_COEFF													0.98692327f

// Максимальное значение давления в системе, атм * 10
#define	PRESSURE_MAX_VALUE												160

// Максимальное значение давления в источнике, атм * 10
#define	SOURCE_PRESSURE_MAX_VALUE									160

// Максимальное значение давления в накопителе, атм * 10
#define	DEST_PRESSURE_MAX_VALUE										160

// Напряжение, соответствующее максимальному давлению в системе, В * 10
#define	MAX_PRESSURE_SENSOR_VOLTAGE								50

// Разница в давлении, больше которой будет разрешено включение насоса, атм * 10
// (Исп. для сохранения ресурса УФ лампы)
#define	PRESSURE_DELTA														10


#define	ANALOG_REFERENCE_VOLTAGE									3300																																	//mV
#define	ADC_RESOLUTION														4096																																	//counts
#define	ADC_LSB_VALUE															(float)((float)ANALOG_REFERENCE_VOLTAGE/(float)(ADC_RESOLUTION-1))		//mV на один отсчёт АЦП

// Определение коэффициента деления при переходе с напряжения +5В пит. д.д. к уровню для АЦП
#define	PRESSURE_SENSOR_POWER_VOLTAGE_VALUE				5.11f
#define	ADC_PRS_SENS_VOLTAGE_VALUE								2.311f
#define	FIVE_VOLTS_DIVISION_COEFF									(float)PRESSURE_SENSOR_POWER_VOLTAGE_VALUE/ADC_PRS_SENS_VOLTAGE_VALUE

// Порог напряжения питания цепи +5В, <= которому сработает сохранение в eeprom, мВ
#define	ADC_WDG_LOW_THRESHOLD_VOLTAGE_VALUE				4400
#define	ADC_WDG_LOW_THRESHOLD											(uint16_t) ((float)(ADC_WDG_LOW_THRESHOLD_VOLTAGE_VALUE)/(FIVE_VOLTS_DIVISION_COEFF*ADC_LSB_VALUE))
// Порог напряжения питания цепи +5В, >= которому сработает восстановление из eeprom, мВ
#define	ADC_WDG_HIGH_THRESHOLD_VOLTAGE_VALUE			4700
#define	ADC_WDG_HIGH_THRESHOLD										(uint16_t) ((float)(ADC_WDG_HIGH_THRESHOLD_VOLTAGE_VALUE)/(FIVE_VOLTS_DIVISION_COEFF*ADC_LSB_VALUE))


// Длина строки данных от ведущего контроллера
//#define	STRING_LENGHT_FROM_MASTER									8
// Длина строки данных для передачи в БЧ
//#define	STRING_LENGHT_TO_MASTER										8
#define JETSON_COM_RXD_BUF_SIZE_IN_BYTES   				128
#define JETSON_COM_TXD_BUF_SIZE_IN_BYTES   				128

#define EXTERNAL_COM_RXD_BUF_SIZE_IN_BYTES 				128
#define EXTERNAL_COM_TXD_BUF_SIZE_IN_BYTES 				128

// Длина строки данных из дисплея Nextion
#define	STRING_LENGHT_FROM_NEXTION								12
#define NEXTION_COM_RXD_BUF_SIZE_IN_BYTES   			STRING_LENGHT_FROM_NEXTION * 2
// Длина строки данных для отправки в дисплей Nextion
#define	STRING_LENGHT_TO_NEXTION									20
#define NEXTION_COM_TXD_BUF_SIZE_IN_BYTES   			STRING_LENGHT_TO_NEXTION

// Size of buffer of pointers in ring buffer(must be a multiple of 2; 1,2,4,8,16,32,64,etc)
#define TX_POINTERS_BUFFER_SIZE										64		// Must be > (TX_RING_DATA_BUFFER_SIZE / TXD String Size)
// Size of ring data buffer (must be a multiple of 2; 1,2,4,8,16,32,64,etc)
#define TX_RING_DATA_BUFFER_SIZE									512

// Значение в SysTick для определения таймаута "сухого хода"
//#define	DRY_WORK_TIMEOUT_VALUE										35000

// Значение в секундах для определения задержки вкл насоса по давлению
#define	PUMP_ON_DELAY															60
// Значение в секундах для определения задержки выкл насоса по давлению
#define	PUMP_OFF_DELAY														4

// Коэфф. скорости уменьшения яркости дисплея в привязке к systick (100%*(DISPLAY_BRIGHTNESS_OFF_SPEED=20)=2000, т.е. за 2 сек)
#define	DISPLAY_BRIGHTNESS_OFF_SPEED							20

// Значение в секундах задержки перед снижением яркости дисплея
#define	DISPLAY_BRIGHTNESS_OFF_DELAY							60

// Значение в секундах задержки перед снижением яркости дисплея после отключения автофункций
#define	AUTOFUNC_DISPLAY_BRIGHTNESS_OFF_DELAY			5

// Яркость дисплея  при работе автофункций, %
#define	AUTOFUNC_DISPLAY_BRIGHTNESS_VALUE					30

// Максимальное значение яркости дисплея, %
#define	DISPLAY_BRIGHTNESS_MAX_VALUE							100

// Минимальное значение яркости дисплея, %
#define	DISPLAY_BRIGHTNESS_MIN_VALUE							5


// Период отсылки данных в дисплей Nextion, SysTicks
#define NEXTION_REFRESH_PERIOD										100

// Значение в SysTick для определения таймаута обрыва связи, SysTicks
#define	NO_DATA_TIMEOUT_VALUE											500

// Интервал выполнения потока опроса и управления периф. устройствами, SysTicks
// (влияет на скорость автоинкремента значений при удержании кнопки на дисплее)
#define	PERIPH_SCAN_TIMER_TIMEOUT									150


// Длительность перерыва в потоке принимаемых данных com-портов, означачающая разделение пакетов
// (Если = 0, то не разделять по времени на отдельные строки, пакеты)
#define	COM1_DATA_FLOW_GAP_TIME_VALUE							5
#define	COM2_DATA_FLOW_GAP_TIME_VALUE							0

// Интервал отправки пакетов по COM1, SysTicks
#define	COM1_DATA_PACKET_SENDING_INTERVAL					2
// Интервал отправки пакетов по COM2 (Nextion), SysTicks
#define	COM2_DATA_PACKET_SENDING_INTERVAL					0
#define	COM3_DATA_PACKET_SENDING_INTERVAL					0
#define	COM4_DATA_PACKET_SENDING_INTERVAL					0
#define	COM5_DATA_PACKET_SENDING_INTERVAL					0


// Задержка между включением УФ лампы и вкл. насоса, SysTicks
#define	PUMP_ON_AFTER_UV_LAMP_ON_DELAY						2.5*60*1000


#define	DISPLAY_POWER_ENABLE											HAL_GPIO_WritePin(DISP_PWR_EN_GPIO_Port, DISP_PWR_EN_Pin, GPIO_PIN_SET)
#define	DISPLAY_POWER_DISABLE											HAL_GPIO_WritePin(DISP_PWR_EN_GPIO_Port, DISP_PWR_EN_Pin, GPIO_PIN_RESET)

#define	RXD1_ENABLE																HAL_GPIO_WritePin(EN_TXD1_RXD1_GPIO_Port, EN_TXD1_RXD1_Pin, GPIO_PIN_RESET)
#define	RXD1_DISABLE															HAL_GPIO_WritePin(EN_TXD1_RXD1_GPIO_Port, EN_TXD1_RXD1_Pin, GPIO_PIN_SET)

#define	TXD1_ENABLE																HAL_GPIO_WritePin(EN_TXD1_RXD1_GPIO_Port, EN_TXD1_RXD1_Pin, GPIO_PIN_SET)
#define	TXD1_DISABLE															HAL_GPIO_WritePin(EN_TXD1_RXD1_GPIO_Port, EN_TXD1_RXD1_Pin, GPIO_PIN_RESET)

#define	RXD4_ENABLE																HAL_GPIO_WritePin(EN_TXD4_RXD4_GPIO_Port, EN_TXD4_RXD4_Pin, GPIO_PIN_RESET)
#define	RXD4_DISABLE															HAL_GPIO_WritePin(EN_TXD4_RXD4_GPIO_Port, EN_TXD4_RXD4_Pin, GPIO_PIN_SET)

#define	TXD4_ENABLE																HAL_GPIO_WritePin(EN_TXD4_RXD4_GPIO_Port, EN_TXD4_RXD4_Pin, GPIO_PIN_SET)
#define	TXD4_DISABLE															HAL_GPIO_WritePin(EN_TXD4_RXD4_GPIO_Port, EN_TXD4_RXD4_Pin, GPIO_PIN_RESET)

#define	RXD3_ENABLE																HAL_GPIO_WritePin(EN_TXD3_RXD3_GPIO_Port, EN_TXD3_RXD3_Pin, GPIO_PIN_RESET)
#define	RXD3_DISABLE															HAL_GPIO_WritePin(EN_TXD3_RXD3_GPIO_Port, EN_TXD3_RXD3_Pin, GPIO_PIN_SET)

#define	TXD3_ENABLE																HAL_GPIO_WritePin(EN_TXD3_RXD3_GPIO_Port, EN_TXD3_RXD3_Pin, GPIO_PIN_SET)
#define	TXD3_DISABLE															HAL_GPIO_WritePin(EN_TXD3_RXD3_GPIO_Port, EN_TXD3_RXD3_Pin, GPIO_PIN_RESET)


#define	WATER_PUMP_ON															HAL_GPIO_WritePin(PUMP_ON_OFF_GPIO_Port, PUMP_ON_OFF_Pin, GPIO_PIN_RESET)
#define	WATER_PUMP_OFF														HAL_GPIO_WritePin(PUMP_ON_OFF_GPIO_Port, PUMP_ON_OFF_Pin, GPIO_PIN_SET)

#define	WATER_ZONE1_ON														HAL_GPIO_WritePin(WATER_ZONE1_GPIO_Port, WATER_ZONE1_Pin, GPIO_PIN_RESET)
#define	WATER_ZONE1_OFF														HAL_GPIO_WritePin(WATER_ZONE1_GPIO_Port, WATER_ZONE1_Pin, GPIO_PIN_SET)

#define	WATER_ZONE2_ON														HAL_GPIO_WritePin(WATER_ZONE2_GPIO_Port, WATER_ZONE2_Pin, GPIO_PIN_RESET)
#define	WATER_ZONE2_OFF														HAL_GPIO_WritePin(WATER_ZONE2_GPIO_Port, WATER_ZONE2_Pin, GPIO_PIN_SET)

#define	WATER_ZONE3_ON														HAL_GPIO_WritePin(WATER_ZONE3_GPIO_Port, WATER_ZONE3_Pin, GPIO_PIN_RESET)
#define	WATER_ZONE3_OFF														HAL_GPIO_WritePin(WATER_ZONE3_GPIO_Port, WATER_ZONE3_Pin, GPIO_PIN_SET)

#define	WATER_ZONE4_ON														HAL_GPIO_WritePin(WATER_ZONE4_GPIO_Port, WATER_ZONE4_Pin, GPIO_PIN_RESET)
#define	WATER_ZONE4_OFF														HAL_GPIO_WritePin(WATER_ZONE4_GPIO_Port, WATER_ZONE4_Pin, GPIO_PIN_SET)

#define	WATER_ZONE5_ON														HAL_GPIO_WritePin(WATER_ZONE5_GPIO_Port, WATER_ZONE5_Pin, GPIO_PIN_RESET)
#define	WATER_ZONE5_OFF														HAL_GPIO_WritePin(WATER_ZONE5_GPIO_Port, WATER_ZONE5_Pin, GPIO_PIN_SET)

#define	WATER_ZONE6_ON														HAL_GPIO_WritePin(WATER_ZONE6_GPIO_Port, WATER_ZONE6_Pin, GPIO_PIN_RESET)
#define	WATER_ZONE6_OFF														HAL_GPIO_WritePin(WATER_ZONE6_GPIO_Port, WATER_ZONE6_Pin, GPIO_PIN_SET)

#define	PWR_CTRL1_ON														HAL_GPIO_WritePin(PWR_CTRL1_GPIO_Port, PWR_CTRL1_Pin, GPIO_PIN_RESET)
#define	PWR_CTRL1_OFF														HAL_GPIO_WritePin(PWR_CTRL1_GPIO_Port, PWR_CTRL1_Pin, GPIO_PIN_SET)

#define	UV_STERILIZER_ON													HAL_GPIO_WritePin(UV_STERILIZER_GPIO_Port, UV_STERILIZER_Pin, GPIO_PIN_RESET)
#define	UV_STERILIZER_OFF													HAL_GPIO_WritePin(UV_STERILIZER_GPIO_Port, UV_STERILIZER_Pin, GPIO_PIN_SET)


#define	LED1_ON																		HAL_GPIO_WritePin(LED1_GPIO_Port, LED1_Pin, GPIO_PIN_SET)
#define	LED1_OFF																	HAL_GPIO_WritePin(LED1_GPIO_Port, LED1_Pin, GPIO_PIN_RESET)
#define	LED1_TOGGLE																HAL_GPIO_TogglePin(LED1_GPIO_Port, LED1_Pin)

#define	LED2_ON																		HAL_GPIO_WritePin(LED2_GPIO_Port, LED2_Pin, GPIO_PIN_SET)
#define	LED2_OFF																	HAL_GPIO_WritePin(LED2_GPIO_Port, LED2_Pin, GPIO_PIN_RESET)
#define	LED2_TOGGLE																HAL_GPIO_TogglePin(LED2_GPIO_Port, LED2_Pin)


#define WATER_COUNTER_EXTI3_READ_PIN							HAL_GPIO_ReadPin	(WATER_COUNTER_EXTI3_GPIO_Port, WATER_COUNTER_EXTI3_Pin)
#define TURBINE_EXTI2_READ_PIN										HAL_GPIO_ReadPin	(TURBINE_COUNTER_EXTI2_GPIO_Port, TURBINE_COUNTER_EXTI2_Pin)


/** @brief 0 if @p cond is true-ish; causes a compile error otherwise. */
#define ZERO_OR_COMPILE_ERROR(cond) ((int) sizeof(char[1 - 2 * !(cond)]) - 1)

/**
 * @brief Zero if @p array has an array type, a compile error otherwise
 *
 * This macro is available only from C, not C++.
 */
#define IS_ARRAY(array) \
	ZERO_OR_COMPILE_ERROR( \
		!__builtin_types_compatible_p(__typeof__(array), \
					      __typeof__(&(array)[0])))


/**
 * @brief Number of elements in the given @p array
 *
 * In C++, due to language limitations, this will accept as @p array
 * any type that implements <tt>operator[]</tt>. The results may not be
 * particularly meaningful in this case.
 *
 * In C, passing a pointer as @p array causes a compile error.
 */
#define ARRAY_SIZE(array) \
	((size_t) (IS_ARRAY(array) + (sizeof(array) / sizeof((array)[0]))))

#endif
