peterriv/WaterSupplyController/FW/Core/Inc/main.h

#define TURBINE_COUNTER_EXTI2_Pin GPIO_PIN_2
#define TURBINE_COUNTER_EXTI2_GPIO_Port GPIOC
#define TURBINE_COUNTER_EXTI2_EXTI_IRQn EXTI2_IRQn
#define WATER_COUNTER_EXTI3_Pin GPIO_PIN_3
#define WATER_COUNTER_EXTI3_GPIO_Port GPIOC
#define WATER_COUNTER_EXTI3_EXTI_IRQn EXTI3_IRQn
#define USART2_TX_NEXTION_Pin GPIO_PIN_2
#define USART2_TX_NEXTION_GPIO_Port GPIOA
#define USART2_RX_NEXTION_Pin GPIO_PIN_3
#define USART2_RX_NEXTION_GPIO_Port GPIOA
#define EN_TXD3_RXD3_Pin GPIO_PIN_2
#define EN_TXD3_RXD3_GPIO_Port GPIOB
#define WATER_ZONE1_Pin GPIO_PIN_12
#define WATER_ZONE1_GPIO_Port GPIOB
#define WATER_ZONE2_Pin GPIO_PIN_13
#define WATER_ZONE2_GPIO_Port GPIOB
#define WATER_ZONE3_Pin GPIO_PIN_14
#define WATER_ZONE3_GPIO_Port GPIOB
#define WATER_ZONE4_Pin GPIO_PIN_15
#define WATER_ZONE4_GPIO_Port GPIOB
#define WATER_ZONE5_Pin GPIO_PIN_6
#define WATER_ZONE5_GPIO_Port GPIOC
#define WATER_ZONE6_Pin GPIO_PIN_7
#define WATER_ZONE6_GPIO_Port GPIOC
#define PWR_CTRL1_Pin GPIO_PIN_8
#define PWR_CTRL1_GPIO_Port GPIOC
#define UV_STERILIZER_Pin GPIO_PIN_9
#define UV_STERILIZER_GPIO_Port GPIOC
#define DISP_PWR_EN_Pin GPIO_PIN_8
#define DISP_PWR_EN_GPIO_Port GPIOA
#define EN_TXD1_RXD1_Pin GPIO_PIN_11
#define EN_TXD1_RXD1_GPIO_Port GPIOA
#define PUMP_ON_OFF_Pin GPIO_PIN_15
#define PUMP_ON_OFF_GPIO_Port GPIOA
#define USART4_TX_Pin GPIO_PIN_10
#define USART4_TX_GPIO_Port GPIOC
#define USART4_RX_Pin GPIO_PIN_11
#define USART4_RX_GPIO_Port GPIOC
#define EN_TXD4_RXD4_Pin GPIO_PIN_3
#define EN_TXD4_RXD4_GPIO_Port GPIOB
#define LED2_Pin GPIO_PIN_8
#define LED2_GPIO_Port GPIOB
#define LED1_Pin GPIO_PIN_9
#define LED1_GPIO_Port GPIOB
