peterriv/WaterSupplyController/(commit log)

2022-09-28 gitignore filter is added
2022-09-28 Fixed day time correction, 1PPS blinking
    [Watering control.ioc, backup.c, backup.h, config.h, main.c]
2022-10-06 RTC corr coeff 30
    [3 MCU.SchDoc, WaterSupplyController.PrjPcb]
2023-01-18 Auto pump with interval added
2023-01-19 Adding multiple auto pump is finished, not tested
2023-02-19 Auto pumping active if curr time more than set time, cubemx project updated
2023-03-13 Popping data error from ring buffer fixed, termosensor connection changed
    [4 Interfaces.SchDoc]
2023-04-05 Fixed and tested working with screen number of Nextion display
    [backup.c, config.h, main.c, main.h, types_def.h]
2023-04-09 Time correction coeff changed, the lowest visual buttons lifted up
    [config.h]
2023-05-08 Auto pumping time check corrected, not tested
    [config.h, ds18b20.c, ds18b20.h, main.c, main.h, onewire.c, types_def.h]
2023-05-09 Auto pumping tested, com2 rxd errors corrected
    [config.h, main.c, types_def.h]
2023-05-11 'No free space in ring buffer' occasional error fixed
    [config.h, main.c, ring_buffer.c, types_def.h]
2023-07-07 Fixed accidential 'dry run' stop
    [WaterSupplyController.PrjPcb]
2024-04-11 Added UV Lamp control logic, timer, counter
2024-04-21 Partly added water count from turbine
    [3 MCU.SchDoc, 4 Interfaces.SchDoc]
2025-01-23 Pump on and off timeout by pressure splited
2025-07-12 Water on-off without pause issue is fixed
    [main.c, main.h]
2025-07-18 Pump doesn't turn off by pressure is fixed
    [main.c]
2025-09-19 Some bugs are removed, working now
    [backup.c, main.c, main.h, types_def.h]
2025-09-19 Water turbine coeff corrected, UV lamp reverse countdown added
    [main.c]
2025-10-07 Resetting watering counters by pressing stop button added
    [main.c]
